sneumeister/Gas-o-Meter2/CAD-housing/README.md

[↓ Switch to English](README_EN.md)

# Gehäuse Dateien zum 3D Druck #

## CAD Dateien ##

CAD-dateien für PTC Creo Parametrics v11.x :  [Creo_parametrics/](./Creo_parametrics/)

## STEP Dateien ###

- Gehäuse: [gasmeter-case01.stp](./gasmeter-case01.stp)
- Akkudeckel: [battcover.stp](./battcover.stp)

## Bilder ##

Platz für das PCB und den Reed-Schalter:

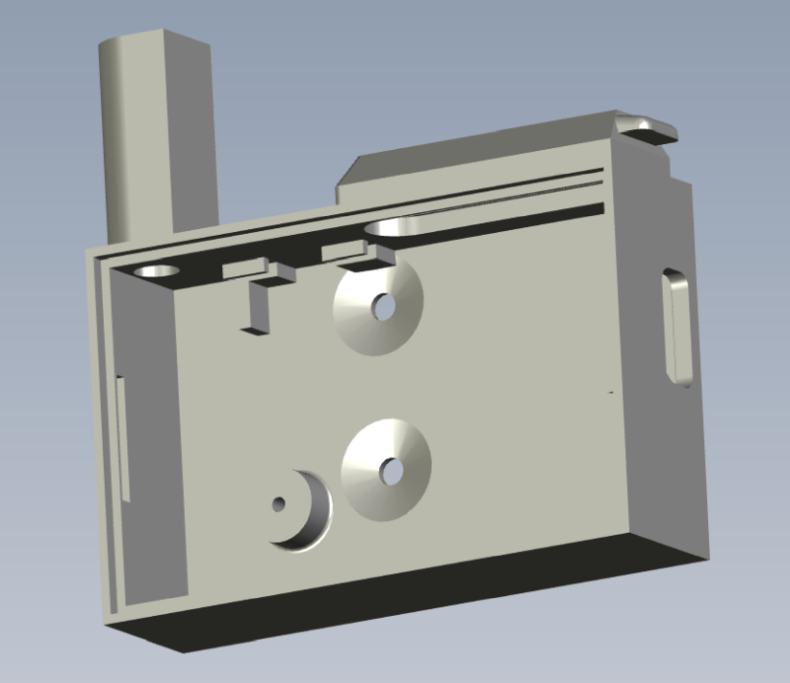
[picture p3: CAD-housing/pictures/gasmeter-case01.png]

(Am "Dom" muss noch ein M6 Gewinde geschnitten werden; die Platine mit Innensechskantschraube M2x10 befestigen)

Paltz für den Akku 523450 - 3,7V / 1000mAh (5,2 x 34 x 50mm):

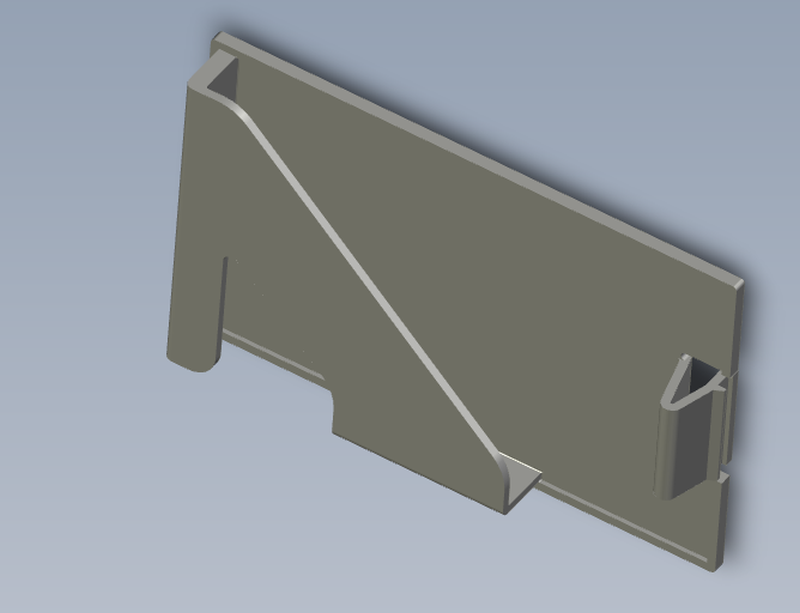
[picture p4: CAD-housing/pictures/battcover.png]


Gedruckt bei JLCPCB

| Item | Data |
| ---- | ---- |
| 3D Technology | SLA(Resin) |
| Material | JLC Black Resin |
| Colors | Black |
| Surface Finish | 01 Sanding / General Sanding |

Bilder
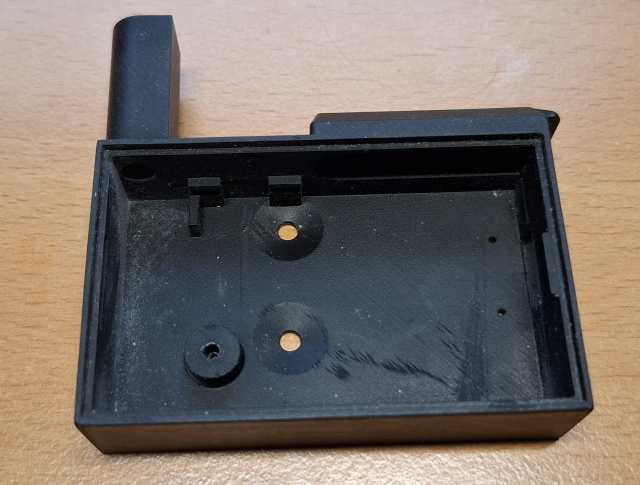
[picture p5: CAD-housing/pictures/house00.png]

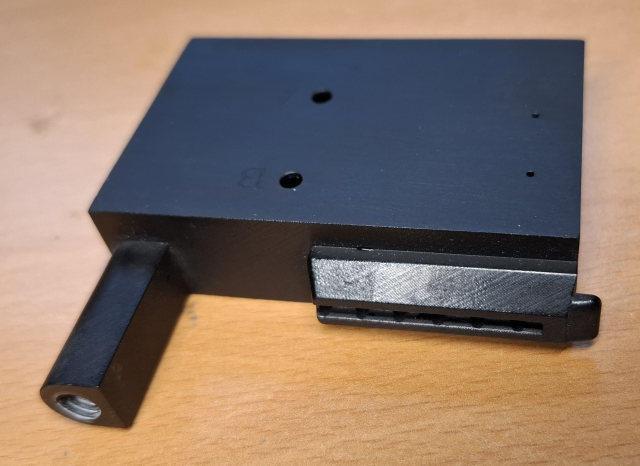
[picture p6: CAD-housing/pictures/house01.png]

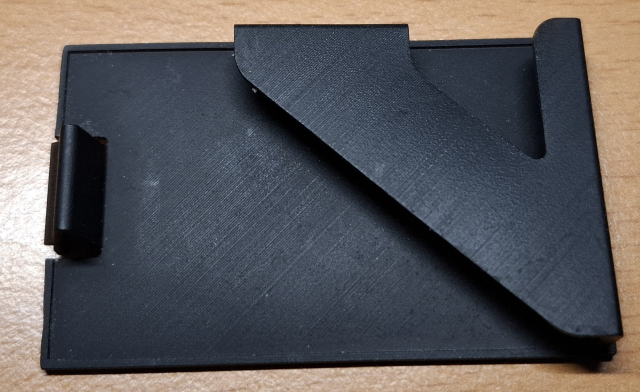
[picture p7: CAD-housing/pictures/house06.png]

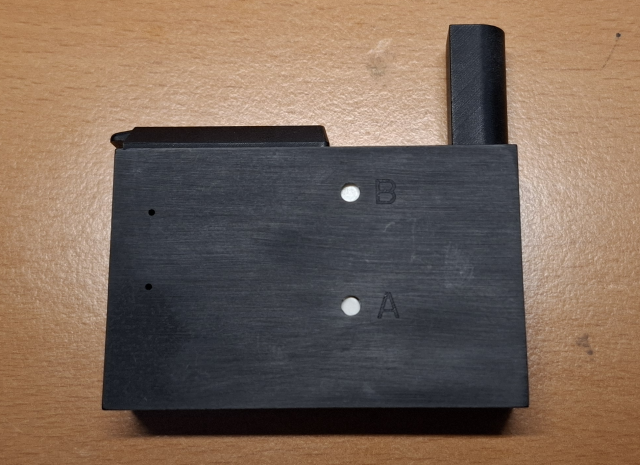
[picture p8: CAD-housing/pictures/house02.png]

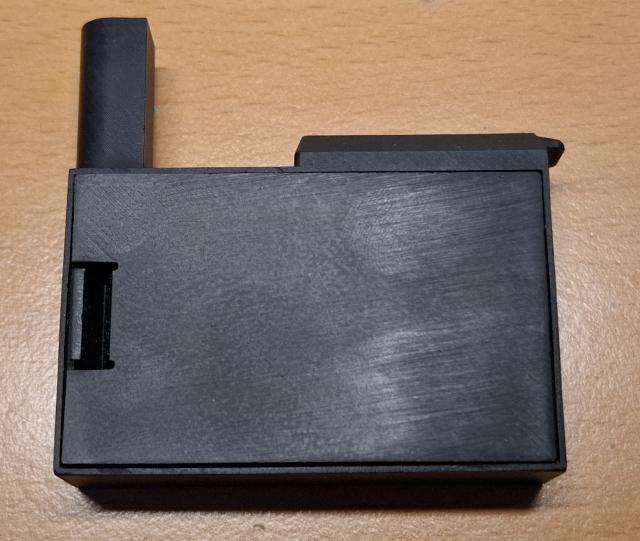
[picture p9: CAD-housing/pictures/house03.png]

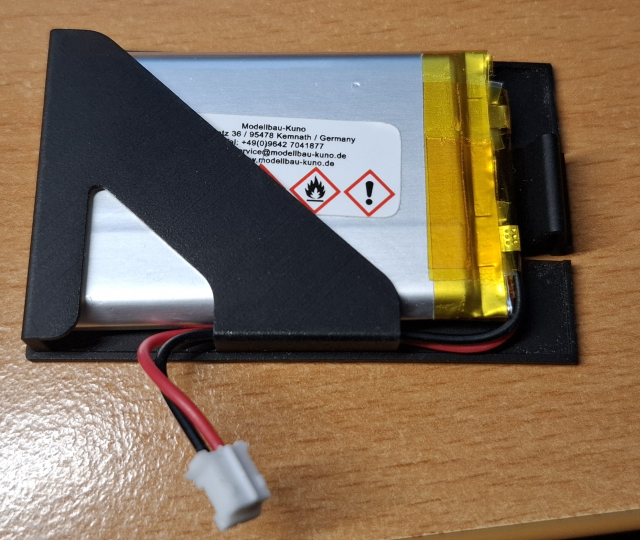
[picture p10: CAD-housing/pictures/house04.png]

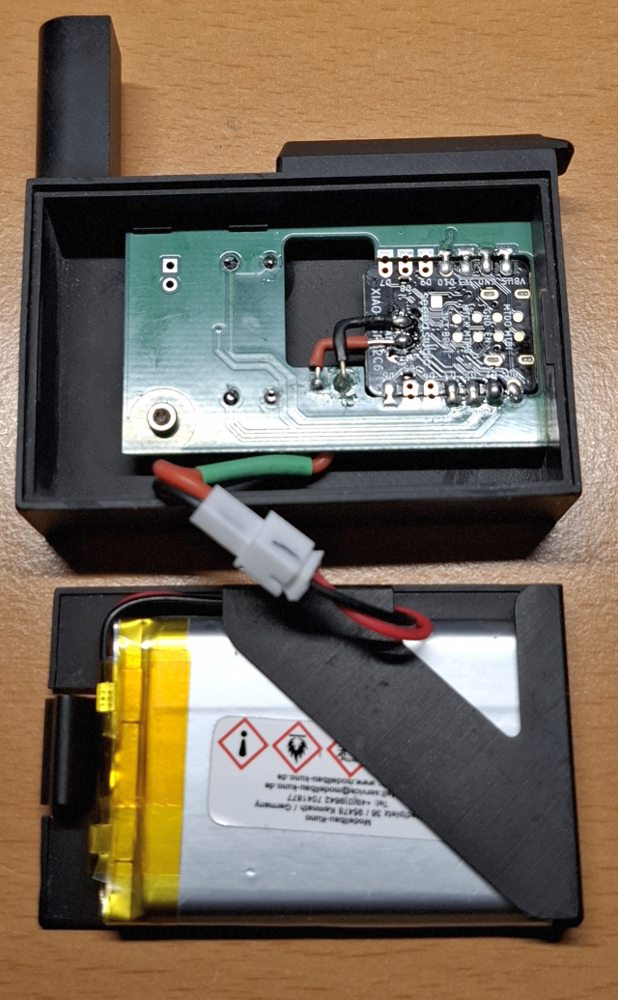
[picture p11: CAD-housing/pictures/house05.png]
