sneumeister/Gas-o-Meter2/KiCAD-PCB/Version20260523/README.md

[↓ Switch to English](README_EN.md)

# Gas-O-Meter2 — Platinenversion 20260523

KiCAD-Projekt und Stückliste (BOM) der zweiten Platinenrevision.

- Akku-Spannung am **GPIO0** (Pin1/A0/D0) mittels **1:1-Spannungsteiler** (R2/R3)
- **USB-Spannungsversorgung:** **VBUS** an **GPIO18** (Pin11/D10) über **asymmetrischen Spannungsteiler** (R3/R4)
- **Freiraum** um die Onboard-Antenne zur Verbesserung der Sende-/Empfangseigenschaften

## Schaltplan

[Schaltplan ESP32C6_gasometer (PDF)](Schaltplan_ESP32C6_gasometer.pdf)

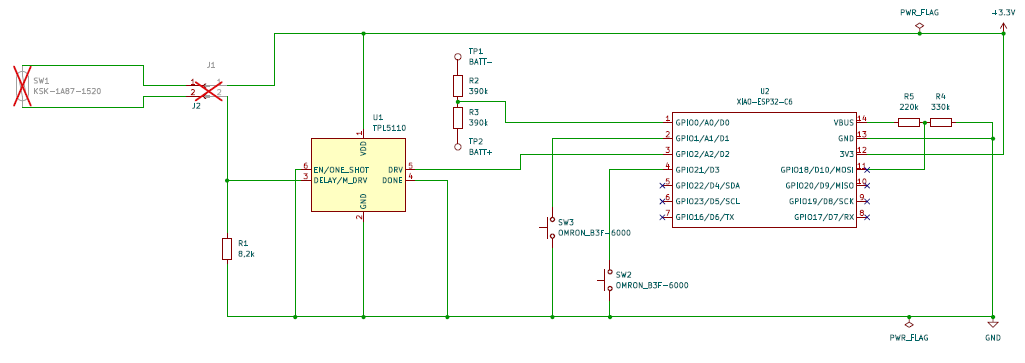
[picture p16: KiCAD-PCB/Version20260523/ESP32C6_gasometer_Schaltplan.png]
Schaltplan ESP32C6_gasometer


## Stückliste (BOM)

Quelle: `BOM_ESP32C6_gasometer.xlsx`

| Reference | Qty | Beschreibung | Value | Datasheet |
| --- | --- | --- | ----- | --- |
| J1 | 1 | Generic connector, single row, 01x02 // Reed | JST-XH 1.25 2pin socket | |
| J2 | 1 | Generic connector, single row, 01x02 // Batterie | JST-XH 1.25 2pin plug | |
| R1 | 1 | Resistor_SMD1206 | 8,2k | |
| R2,R3 | 2 | Resistor_SMD1206 | 390k | |
| R4 | 1 | Resistor_SMD1206 | 330k | |
| R5 | 1 | Resistor_SMD1206 | 220k | |
| SW1 | 1 | reed switch | KSK-1A87-1520 | [Datasheet](https://standexdetect.de/wp-content/uploads/sites/8/2025/09/datasheet-reed-switch-series-ksk-1a80.pdf) |
| SW2,SW3 | 2 | Push button switch, generic, two pins | OMRON_B3F-6000 | [Datasheet](https://omronfs.omron.com/en_US/ecb/products/pdf/en-b3f.pdf) |
| U1 | 1 | Timer, Nano Power, SOT-23-6 | TPL5110 | [Datasheet](http://www.ti.com/lit/ds/symlink/tpl5110.pdf) |
| U2 | 1 | | Seeed Studio XIAO ESP32-C6 | |
| J3 | | JST-Conn. / Battery Connector | JST-PH 2.00 2pin socket | |
| | 1 | Li-Polymer Battery 52x34x5,0mm | LiPo 1000mAh 523450 | |

## 3D-Ansicht

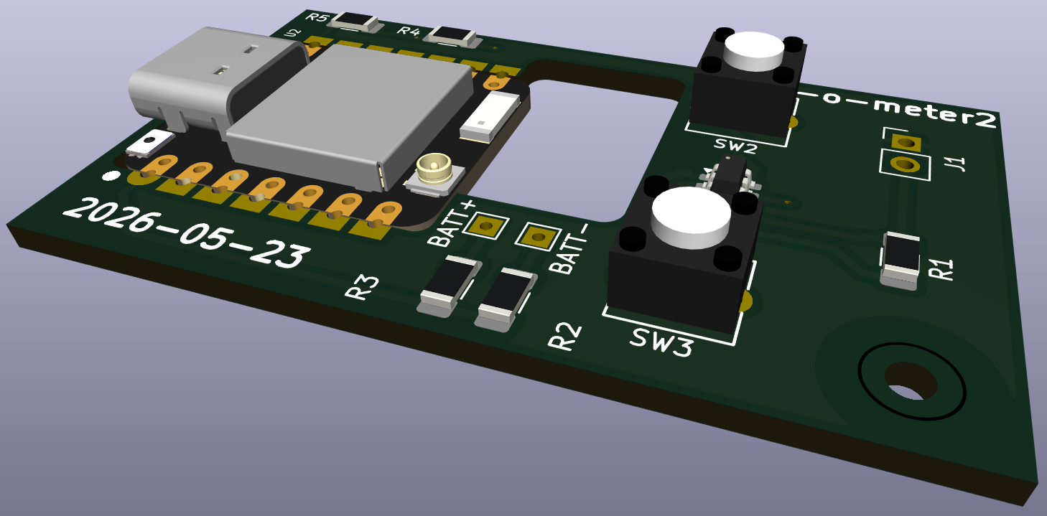
[picture p17: KiCAD-PCB/Version20260523/ESP32C6_PCB_3D.png]
ESP32C6 PCB 3D


## KiCAD-Export

Aktueller Stand: [ESP32C6_gasometer-2026-07-11_162129](ESP32C6_gasometer-2026-07-11_162129/)
