sneumeister/Gas-o-Meter2/THIRD_PARTY_NOTICES.md

# Third-party notices

Gas-O-Meter2 firmware and the web flasher use third-party software. The
versions below correspond to the pinned entries in `dependencies.lock`,
`platformio.ini` and the web-flasher dependency for the current source tree.

The Gas-O-Meter2 project itself is licensed under the Apache License 2.0; see
[`LICENSE`](./LICENSE) and [`NOTICE`](./NOTICE). The notices below do not
change the licenses of the respective third-party works.

## Apache License 2.0

The following works are provided under the Apache License 2.0:

- ESP-IDF 5.5.1, Espressif Systems:
  <https://github.com/espressif/esp-idf/tree/v5.5.1>
- espressif/mdns 1.9.1, Espressif Systems:
  <https://components.espressif.com/components/espressif/mdns/versions/1.9.1>
- espressif/esp-zigbee-lib 1.6.8, Espressif Systems:
  <https://components.espressif.com/components/espressif/esp-zigbee-lib/versions/1.6.8>
- ESP Web Tools 10.4.0, ESPHome contributors:
  <https://github.com/esphome/esp-web-tools/tree/10.4.0>

A copy of the Apache License 2.0 is provided in [`LICENSE`](./LICENSE).

ESP-IDF contains components and submodules with their own license and
attribution notices. Their corresponding source and component-specific notices
are available from the exact ESP-IDF source version linked above.

## MIT-licensed software

The following copyright notices apply:

### ArduinoJson 7.4.3

Copyright © 2014-2026, Benoit BLANCHON

Source: <https://github.com/bblanchon/ArduinoJson/tree/v7.4.3>

### joltwallet/littlefs 1.20.3

Copyright 2020 Brian Pugh

Source: <https://components.espressif.com/components/joltwallet/littlefs/versions/1.20.3>

### nordesems/esp-captive-portal 1.3.0

Copyright (c) 2026 Ahmed Al-Tameemi, Nordes Sp. z o. o.

Source:
<https://components.espressif.com/components/nordesems/esp-captive-portal/versions/1.3.0>

### Bootstrap 5.3.2

Copyright (c) 2011-2023 The Bootstrap Authors

Source: <https://github.com/twbs/bootstrap/tree/v5.3.2>

### MIT License text

Permission is hereby granted, free of charge, to any person obtaining a copy
of this software and associated documentation files (the "Software"), to deal
in the Software without restriction, including without limitation the rights
to use, copy, modify, merge, publish, distribute, sublicense, and/or sell
copies of the Software, and to permit persons to whom the Software is
furnished to do so, subject to the following conditions:

The above copyright notice and this permission notice shall be included in all
copies or substantial portions of the Software.

THE SOFTWARE IS PROVIDED "AS IS", WITHOUT WARRANTY OF ANY KIND, EXPRESS OR
IMPLIED, INCLUDING BUT NOT LIMITED TO THE WARRANTIES OF MERCHANTABILITY,
FITNESS FOR A PARTICULAR PURPOSE AND NONINFRINGEMENT. IN NO EVENT SHALL THE
AUTHORS OR COPYRIGHT HOLDERS BE LIABLE FOR ANY CLAIM, DAMAGES OR OTHER
LIABILITY, WHETHER IN AN ACTION OF CONTRACT, TORT OR OTHERWISE, ARISING FROM,
OUT OF OR IN CONNECTION WITH THE SOFTWARE OR THE USE OR OTHER DEALINGS IN THE
SOFTWARE.

## espressif/esp-zboss-lib 1.6.4

Source:
<https://components.espressif.com/components/espressif/esp-zboss-lib/versions/1.6.4>

Copyright (c) 2012-2021 DSR Corporation, Denver CO, USA  
Copyright (c) 2021 Espressif Systems (Shanghai) PTE LTD  
All rights reserved.

Redistribution and use in source and binary forms, with or without
modification, are permitted provided that the following conditions are met:

1. Redistributions of source code must retain the above copyright notice,
   this list of conditions and the following disclaimer.
2. Redistributions in binary form, except as embedded into an Espressif
   Systems integrated circuit in a product or a software update for such
   product, must reproduce the above copyright notice, this list of conditions
   and the following disclaimer in the documentation and/or other materials
   provided with the distribution.
3. Neither the name of the copyright holder nor the names of its contributors
   may be used to endorse or promote products derived from this software
   without specific prior written permission.
4. Any software provided in binary form under this license must not be reverse
   engineered, decompiled, modified and/or disassembled.

THIS SOFTWARE IS PROVIDED BY THE COPYRIGHT HOLDERS AND CONTRIBUTORS "AS IS"
AND ANY EXPRESS OR IMPLIED WARRANTIES, INCLUDING, BUT NOT LIMITED TO, THE
IMPLIED WARRANTIES OF MERCHANTABILITY AND FITNESS FOR A PARTICULAR PURPOSE
ARE DISCLAIMED. IN NO EVENT SHALL THE COPYRIGHT HOLDER OR CONTRIBUTORS BE
LIABLE FOR ANY DIRECT, INDIRECT, INCIDENTAL, SPECIAL, EXEMPLARY, OR
CONSEQUENTIAL DAMAGES (INCLUDING, BUT NOT LIMITED TO, PROCUREMENT OF
SUBSTITUTE GOODS OR SERVICES; LOSS OF USE, DATA, OR PROFITS; OR BUSINESS
INTERRUPTION) HOWEVER CAUSED AND ON ANY THEORY OF LIABILITY, WHETHER IN
CONTRACT, STRICT LIABILITY, OR TORT (INCLUDING NEGLIGENCE OR OTHERWISE)
ARISING IN ANY WAY OUT OF THE USE OF THIS SOFTWARE, EVEN IF ADVISED OF THE
POSSIBILITY OF SUCH DAMAGE.
