sneumeister/Gas-o-Meter2/pictures/webui/config-ble.png

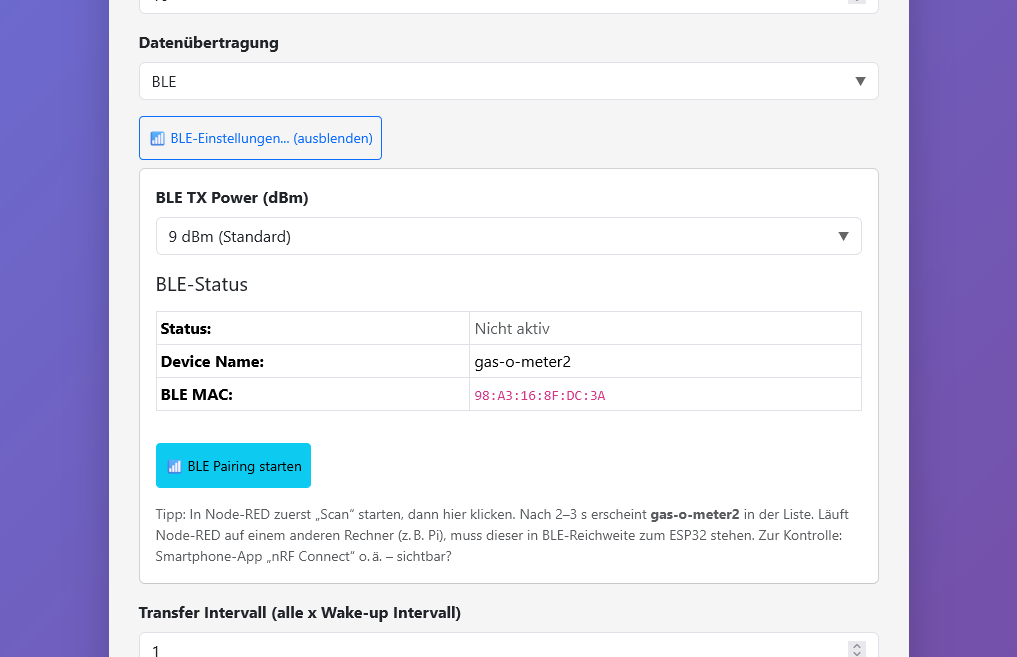
pictures/webui/config-ble.png
