sneumeister/Gas-o-Meter2/pictures/webui/config-change-popup.png

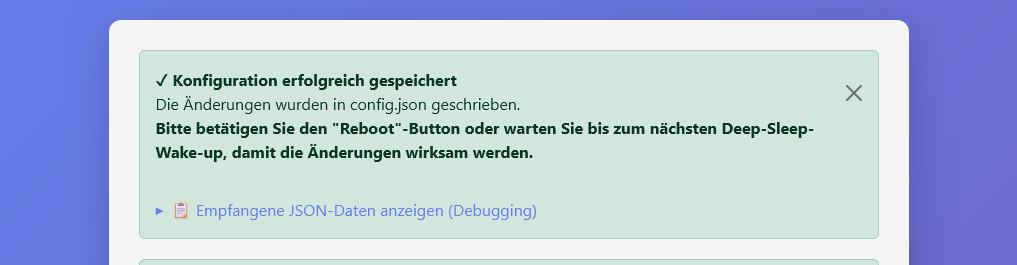
pictures/webui/config-change-popup.png
