sneumeister/Gas-o-Meter2/CAD-housing/gasmeter-case01.stp

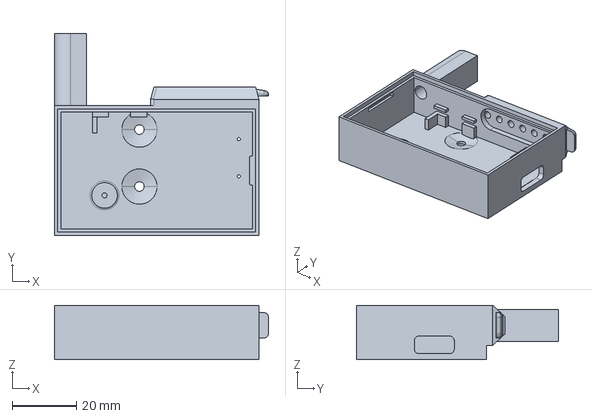
[picture p26: CAD file, 2025-12-28]
CAD-housing/gasmeter-case01.stp
66.8 x 63.0 x 17.0 mm
