sneumeister/Gas-o-Meter2/CAD-housing/battcover.stp

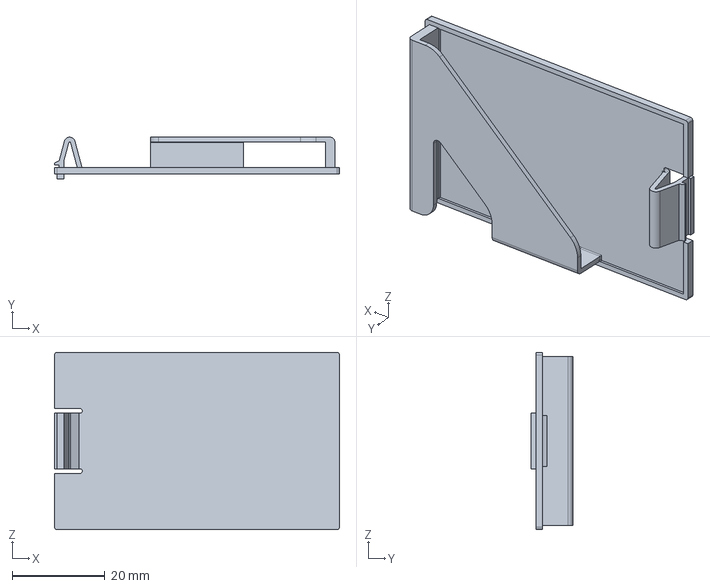
[picture p27: CAD file, 2025-12-28]
CAD-housing/battcover.stp
61.5 x 9.00 x 38.2 mm
