sneumeister/Gas-o-Meter2/CAD-housing/ESP32C6_gasometer.step

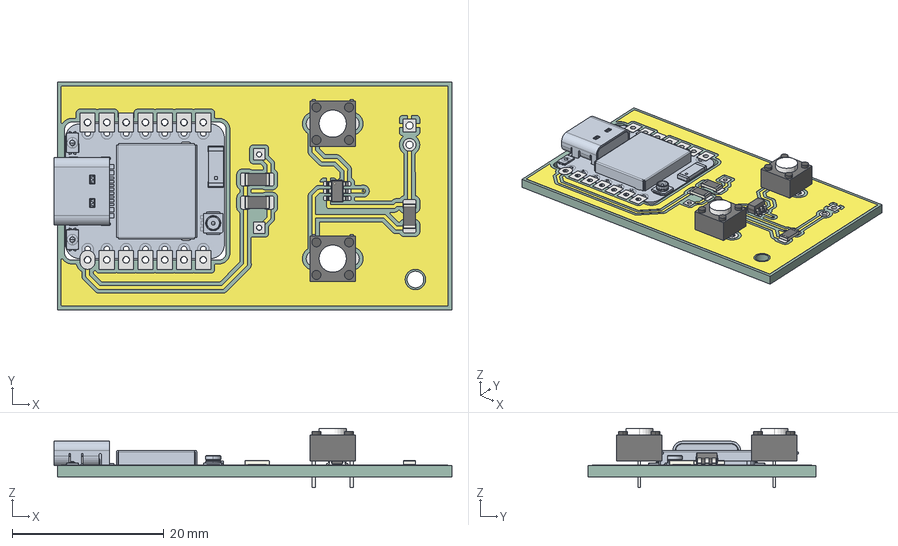
[picture p28: CAD file, 2025-12-26]
CAD-housing/ESP32C6_gasometer.step
52.4 x 30.0 x 7.80 mm
b3f-6000 x 2
R_1206_3216Metric x 3
ESP32C6_gasometer 1.5.1
SOT-23-6
ESP32C6_gasometer_copper
ESP32C6_gasometer_pad
ESP32C6_gasometer_via
ESP32C6_gasometer_PCB
