sneumeister/Gas-o-Meter2/(list of files, cad)

Other CAD files:
CAD-housing/Creo_parametrics/battcover.prt
CAD-housing/Creo_parametrics/gasmeter-case01.prt
CAD-housing/Creo_parametrics/lipo_1500mah.prt
