sneumeister/Gas-o-Meter2/KiCAD-PCB/Version20260523/ESP32C6_gasometer.pdf

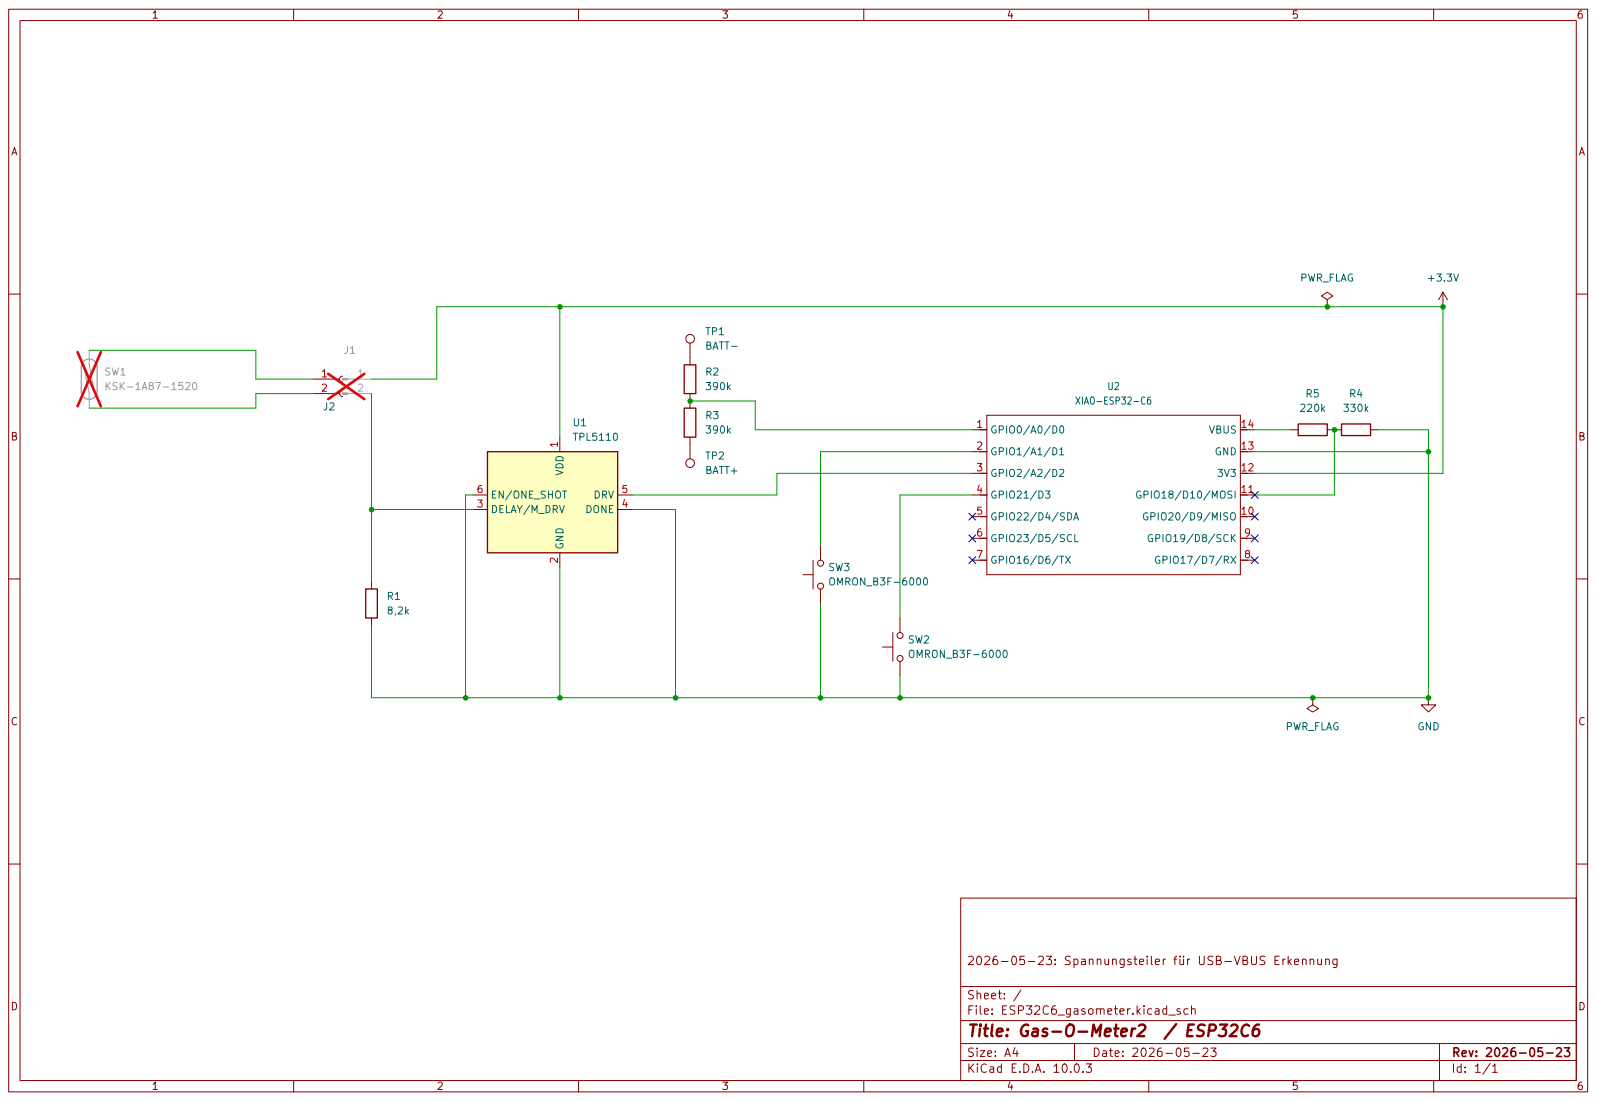
[picture p29: page 1]
