sneumeister/Gas-o-Meter2/KiCAD-PCB/Version20251022/ESP32C6_gasometer.pdf

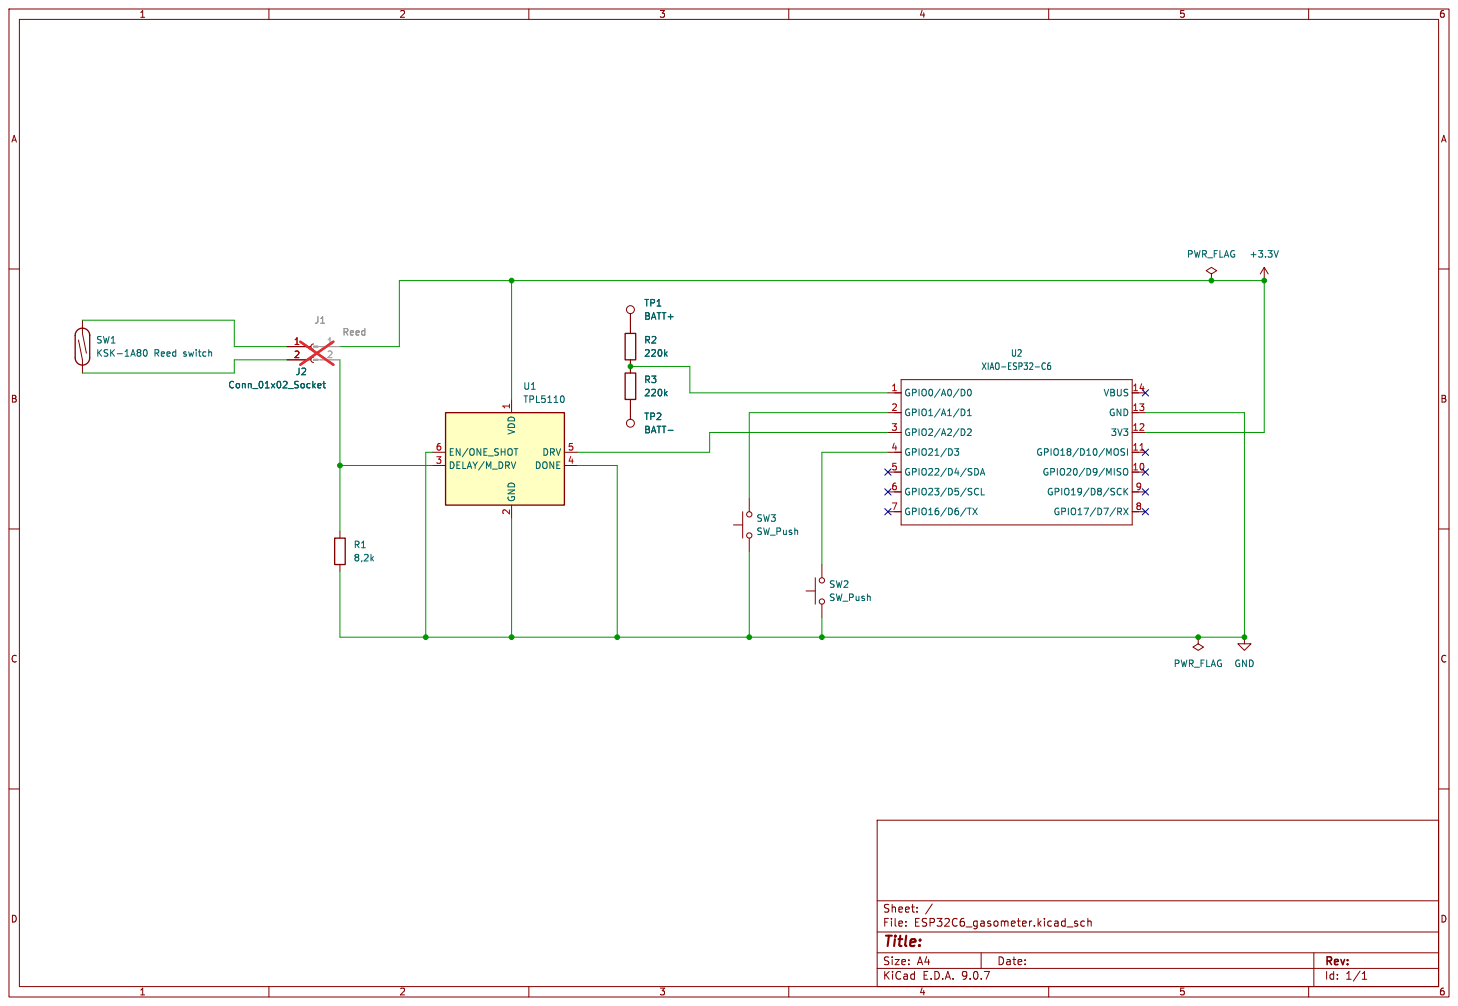
[picture p30: page 1]
