sneumeister/Gas-o-Meter2/KiCAD-PCB/Version20251022/ESP32C6_gasometer-2026-02-07_185848/ESP32C6_gasometer.kicad_pcb

## KiCad design KiCAD-PCB/Version20251022/ESP32C6_gasometer-2026-02-07_185848/ESP32C6_gasometer.kicad_pcb (2026-07-11)

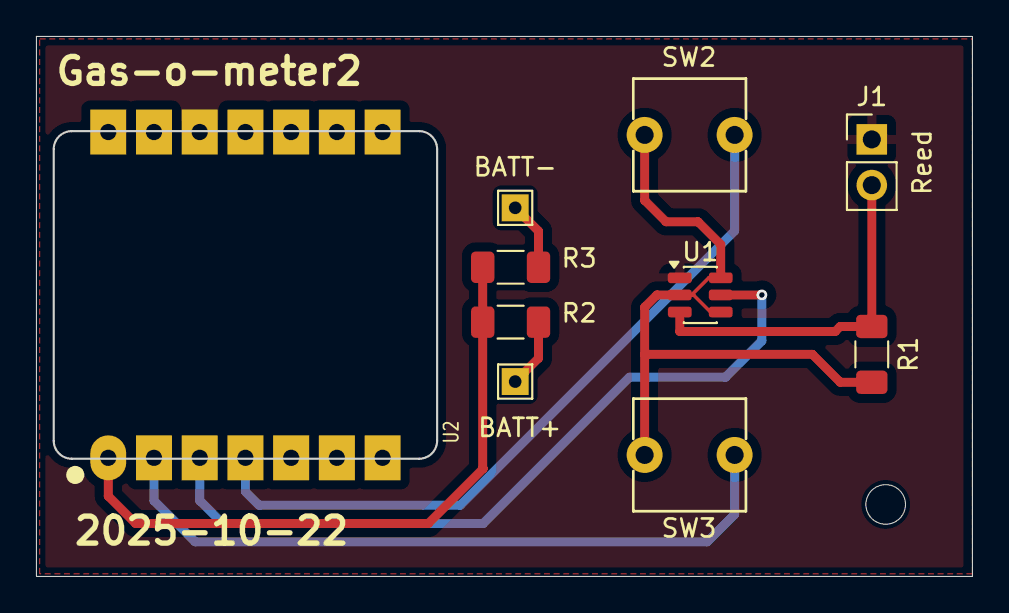
[picture p31: board ESP32C6_gasometer.kicad_pcb from above]

Board: 2 copper layers, 52.0 x 30.0 mm, 11 parts (0 on the bottom side), 9 nets.

Parts:
.: M.Hole_2.2mm_M2; MountingHole_2.2mm_M2
J1: Reed; PinHeader_1x02_P2.54mm_Vertical
R1: 8,2k; R_1206_3216Metric_Pad1.30x1.75mm_HandSolder
R2, R3: 200k; R_1206_3216Metric_Pad1.30x1.75mm_HandSolder
SW2, SW3: SW_Push; SW_TH_Tactile_Omron_B3F-6000
TP1: BATT+; TestPoint_THTPad_1.5x1.5mm_Drill0.7mm
TP2: BATT-; TestPoint_THTPad_1.5x1.5mm_Drill0.7mm
U1: TPL5110; SOT-23-6
U2: XIAO-ESP32-C6; XIAO-ESP32C6-Breakout

Connections:
+3.3V: J1.1, U1.1 (VDD), U2.12 (3V3)
GND: R1.2, SW2.1, SW3.1, U1.2 (GND), U1.4 (DONE), U1.6 (EN/ONE_SHOT), U2.13 (GND)
unnamed: J1.2, R1.1, U1.3 (DELAY/M_DRV)
unnamed: R2.1, TP1.1
unnamed: R3.2, TP2.1
unnamed: U1.5 (DRV), U2.3 (GPIO2/A2/D2)
unnamed: R2.2, R3.1, U2.1 (GPIO0/A0/D0)
unnamed: SW3.2, U2.2 (GPIO1/A1/D1)
unnamed: SW2.2, U2.4 (GPIO21/D3)
