sneumeister/Gas-o-Meter2/include/hardware.h

#define HARDWARE_H
#include "hardware_shared.h"
#include "driver/gpio.h"
#include "freertos/FreeRTOS.h"
#include "freertos/task.h"
#include "esp_log.h"
#include "hal/adc_types.h"
#define SET_WIFI_LOG_LEVEL() esp_log_level_set("wifi", ESP_LOG_WARN)
    #define HIGH    1
    #define LOW     0
    ((BOARD_VERSION_ID != 20251022) && (BOARD_VERSION_ID != 20260523))
  #undef BOARD_VERSION_ID
  #define BOARD_VERSION_ID 20251022
#define LED_BUILTIN_GPIO   15  // Interne LED
#define BUTTON_A_GPIO_MODE  ((int)(GPIO_MODE_INPUT) | (int)(GPIO_PULLUP_ONLY))
#define REED_GPIO_MODE      GPIO_MODE_INPUT  // Kein Pull-Up/Pull-Down (externer Pull-Up)
#define BUTTON_B_GPIO_MODE  ((int)(GPIO_MODE_INPUT) | (int)(GPIO_PULLUP_ONLY))
#define INPUT_PULLUP      ((int)(GPIO_MODE_INPUT) | (int)(GPIO_PULLUP_ONLY))
#define INPUT_PULLDOWN    ((int)(GPIO_MODE_INPUT) | (int)(GPIO_PULLDOWN_ONLY))
#define LED_OFF            HIGH  // LED AUS (bei HIGH!)
#define LED_ON             LOW   // LED AN (bei LOW!)
#define ANTENNA_RF_SWITCH_ENABLE LOW  // RF-Switch aktivieren
#define ANTENNA_INTERNAL        LOW   // Logik-Level für interne Antenne (GPIO14)
#define ANTENNA_EXTERNAL        HIGH  // Logik-Level für externe Antenne (GPIO14)
#define BATTERY_ADC_PIN    0   // Akku-Monitoring ADC Pin (GPIO0)
#define BATTERY_ADC_UNIT   ADC_UNIT_1  // ADC Unit 1 (GPIO0 gehört zu ADC1)
#define BATTERY_ADC_CHANNEL ADC_CHANNEL_0  // ADC1 Channel 0
#define ANTENNA_RF_SWITCH_GPIO  3   // GPIO3: RF-Switch aktivieren (LOW = aktiviert)
#define ANTENNA_SELECT_GPIO     14  // GPIO14: Antennenauswahl (LOW = intern, HIGH = extern)
#define ADC_SAMPLE_COUNT   5   // Anzahl Messungen für Median-Filter
#define VOLTAGE_DIVIDER_RATIO  2.0   // Spannungsteiler-Verhältnis (2:1 = 2.0)
#define ADC_VOLTAGE_MULTIPLIER  1.00f
#define ADC_MAX_ADC_VOLTAGE    4.24f  // Maximale Spannung am ADC-Eingang bei ADC_ATTEN_DB_12 (V) - gemessen
#define ADC_RESOLUTION         4095   // 12-bit ADC Auflösung (2^12 - 1)
#define BATTERY_VOLTAGE_FULL      4.02f   // ≥4.02V = 100% = "Voll"
#define BATTERY_VOLTAGE_80        3.92f   // 3.92V = 80% = "Gut"
#define BATTERY_VOLTAGE_50        3.72f   // 3.72V = 50% = "Mittel"
#define BATTERY_VOLTAGE_30        3.57f   // 3.57V = 30% (Schwelle für Ring-Speicher-Schreibung)
#define BATTERY_VOLTAGE_20        3.42f   // 3.42V = 20% = "Niedrig"
#define BATTERY_VOLTAGE_PROTECTION 3.15f   // ≤3.15V = 0% = "Schutz!" (Betrieb einstellen)
#define BATTERY_MIN_VOLTAGE   BATTERY_VOLTAGE_PROTECTION  // Minimale Akku-Spannung (V) = 0%
#define BATTERY_MAX_VOLTAGE   BATTERY_VOLTAGE_FULL        // Maximale Akku-Spannung (V) = 100%
#define USB_DETECTION_THRESHOLD   2.0f    // Schwellwert für USB-Erkennung (V) - darunter: USB angeschlossen
#define VBUS_DETECT_GPIO  18
#define DEFAULT_NTP_SERVER    "pool.ntp.org"  // Default NTP-Server (gut für Europa)
#define NTP_TIMEOUT_MS        5000            // Timeout für NTP-Synchronisation (ms)
#define WIFI_TX_POWER_DEFAULT       80      // Default WiFi TX Power: 20 dBm (80 * 0.25 dBm = 20 dBm)
#define HOSTNAME_MAX_LEN  26
#define WIFI_WAIT_FOR_SLEEP   5               // Minuten ohne Web-Server-Zugriff → Deep-Sleep
#define AP_IP_ADDRESS_1       10               // AP IP-Adresse: 10.0.0.1
#define AP_IP_ADDRESS_2       0
#define AP_IP_ADDRESS_3       0
#define AP_IP_ADDRESS_4       1
#define LP_CORE_WATCHDOG_MS   6000
#define DEFAULT_WAKEUP_INTERVAL_MIN  10  // Minuten
#define DEFAULT_WAKEUP_INTERVAL_US   (DEFAULT_WAKEUP_INTERVAL_MIN * 60 * 1000000ULL)
#define WAKEUP_BUFFER_SEC  30  // Sekunden
#define DEFAULT_TRANSFER_INTERVAL_X  2  // Multiplikator für Transfer-Intervall
#define DEFAULT_TRANSFER_INTERVAL_US   (DEFAULT_TRANSFER_INTERVAL_X * DEFAULT_WAKEUP_INTERVAL_MIN * 60 * 1000000ULL)
#define PULSE_COUNTER_DIVISOR  100  // Divisor für 2 Nachkommastellen (m³)
#define RING_BUFFER_SIZE  12000  // Anzahl Einträge im Ringspeicher (10 Jahre @ 1200 Pulse/Jahr)
#define ULP_RTC_MEM_BASE   0x50000000  // RTC Fast Memory Start-Adresse
#define ULP_DATA_OFFSET    0x100       // Offset für Daten im RTC Memory
#define ULP_DATA_MAGIC     0x475A4D4F  // "GZMO" (Gas-Zähler-Meter-Original)
#define NVS_PARTITION_PULSE  "pulse_nv"   // Partition-Name aus partitions.csv
#define NVS_NAMESPACE_PULSE  "pulse_ring"
#define NVS_KEY_VERSION      "version"  // Versionsnummer für Initialisierungs-Check
#define NVS_KEY_PREFIX       "p_"
#define MAX_KEY_LENGTH       8   // Max: "p_11999" = 7 Zeichen + 1 Null-Terminator = 8
#include "version.h"
#define ADC_TO_VOLTAGE(adc_value) \
    ((float)(adc_value) / ADC_RESOLUTION * ADC_MAX_ADC_VOLTAGE * VOLTAGE_DIVIDER_RATIO)
inline uint8_t VOLTAGE_TO_PERCENT(float voltage) {
    if (voltage >= BATTERY_VOLTAGE_FULL) {
        return 100;  // "Voll"
    } else if (voltage >= BATTERY_VOLTAGE_80) {
        return 80 + (uint8_t)(((voltage - BATTERY_VOLTAGE_80) / (BATTERY_VOLTAGE_FULL - BATTERY_VOLTAGE_80)) * 20.0f);
    } else if (voltage >= BATTERY_VOLTAGE_50) {
        return 50 + (uint8_t)(((voltage - BATTERY_VOLTAGE_50) / (BATTERY_VOLTAGE_80 - BATTERY_VOLTAGE_50)) * 30.0f);
    } else if (voltage >= BATTERY_VOLTAGE_20) {
        return 20 + (uint8_t)(((voltage - BATTERY_VOLTAGE_20) / (BATTERY_VOLTAGE_50 - BATTERY_VOLTAGE_20)) * 30.0f);
    } else if (voltage >= BATTERY_VOLTAGE_PROTECTION) {
        return 0 + (uint8_t)(((voltage - BATTERY_VOLTAGE_PROTECTION) / (BATTERY_VOLTAGE_20 - BATTERY_VOLTAGE_PROTECTION)) * 20.0f);
    } else {
        return 0;     // "Schutz!" - unter 3.15V
    }
}
#define ADC_TO_PERCENT(adc_value) \
    VOLTAGE_TO_PERCENT(ADC_TO_VOLTAGE(adc_value))
#define INIT_ANTENNA_SWITCH(antenna_type) \
    do { \
        gpio_config_t io_conf = {}; \
        io_conf.pin_bit_mask = (1ULL << ANTENNA_RF_SWITCH_GPIO) | (1ULL << ANTENNA_SELECT_GPIO); \
        io_conf.mode = GPIO_MODE_OUTPUT; \
        io_conf.pull_up_en = GPIO_PULLUP_DISABLE; \
        io_conf.pull_down_en = GPIO_PULLDOWN_DISABLE; \
        io_conf.intr_type = GPIO_INTR_DISABLE; \
        gpio_config(&io_conf); \
        gpio_set_level((gpio_num_t)ANTENNA_RF_SWITCH_GPIO, ANTENNA_RF_SWITCH_ENABLE); \
        vTaskDelay(pdMS_TO_TICKS(100));  \
        gpio_set_level((gpio_num_t)ANTENNA_SELECT_GPIO, antenna_type); \
    } while(0)
#define SET_ANTENNA_INTERNAL() \
    gpio_set_level((gpio_num_t)ANTENNA_SELECT_GPIO, ANTENNA_INTERNAL)
#define SET_ANTENNA_EXTERNAL() \
    gpio_set_level((gpio_num_t)ANTENNA_SELECT_GPIO, ANTENNA_EXTERNAL)
#define INIT_VBUS_DETECT_GPIO() \
    do { \
        gpio_config_t _vbus = {}; \
        _vbus.pin_bit_mask = (1ULL << VBUS_DETECT_GPIO); \
        _vbus.mode = GPIO_MODE_INPUT; \
        _vbus.pull_up_en = GPIO_PULLUP_DISABLE; \
        _vbus.pull_down_en = GPIO_PULLDOWN_DISABLE; \
        _vbus.intr_type = GPIO_INTR_DISABLE; \
        gpio_config(&_vbus); \
    } while (0)
#if BOARD_VERSION_ID == 20260523
#define IS_USB_POWER(battery_voltage_v) \
    (gpio_get_level((gpio_num_t)VBUS_DETECT_GPIO) == 1)
#else
#define IS_USB_POWER(battery_voltage_v) \
    ((battery_voltage_v) < USB_DETECTION_THRESHOLD)
#endif
#if BOARD_VERSION_ID == 20260523
#define LOG_USB_POWER_DETECTED(tag, battery_voltage_v) \
    ESP_LOGI(tag, "USB-Stromversorgung erkannt (VBUS GPIO%d=%d)", \
             VBUS_DETECT_GPIO, (int)gpio_get_level((gpio_num_t)VBUS_DETECT_GPIO))
#else
#define LOG_USB_POWER_DETECTED(tag, battery_voltage_v) \
    ESP_LOGI(tag, "USB-Stromversorgung erkannt (Spannung %.2f V < %.2f V)", \
             (float)(battery_voltage_v), USB_DETECTION_THRESHOLD)
#endif
#define LOG_POWER_SUPPLY_MODE(tag, battery_voltage_v, is_usb_power_v) \
    do { \
        if (is_usb_power_v) { \
            LOG_USB_POWER_DETECTED(tag, battery_voltage_v); \
        } else { \
            ESP_LOGI(tag, "Akku-Betrieb (Spannung: %.2f V)", (float)(battery_voltage_v)); \
        } \
    } while (0)
