sneumeister/Gas-o-Meter2/src/main_idf.cpp

// ESP-IDF Headers
#include "esp_log.h"
#include "esp_system.h"
#include "esp_mac.h"
#include "esp_event.h"
#include "esp_netif.h"
#include "esp_wifi.h"
#include "esp_http_server.h"
#include "mdns.h"
#include "esp_littlefs.h"
#include "lwip/apps/sntp.h"
#include "lwip/inet.h"
#include "lwip/sockets.h"
#include "captive_portal.h"
#include <string.h>
#include "esp_vfs.h"
#include "esp_timer.h"
#include "esp_adc/adc_oneshot.h"
#include "esp_adc/adc_cali.h"
#include "esp_adc/adc_cali_scheme.h"
#include "esp_sleep.h"
#include "driver/gpio.h"
#include "driver/rtc_io.h"
#include "driver/uart.h"
#include "ulp_lp_core.h"  // LP-Core Management APIs
#include <time.h>
#include "nvs.h"
#include "nvs_flash.h"
#include "esp_partition.h"
#include "hardware.h"
#include "version.h"
#include "freertos/FreeRTOS.h"
#include "freertos/task.h"
#include "transfer.h"
#include "transfer_zigbee.h"
#include "zigbee_config.h"
#include "transfer_ble.h"
#include "ble_config.h"
#include "mqtt_config.h"
#include "transfer_mqtt.h"
#include "wifi_scan_config.h"
#include "wifi_manager.h"
#include "time_sync.h"
#include <stdlib.h>

#include <ArduinoJson.h>

// Template-Placeholder (aus CMakeLists.txt)
#ifndef TEMPLATE_PLACEHOLDER
#define TEMPLATE_PLACEHOLDER '`'   // Backtick (`) für Template-Platzhalter
#endif

// Logging-Tag
static const char *TAG = "gas-o-meter";

/** UART-TX leeren vor Deep-Sleep/Reboot (ersetzt feste 200-ms-Pause). */
static void console_flush_before_poweroff(void) {
    fflush(stdout);
#if CONFIG_ESP_CONSOLE_UART
    const esp_err_t err = uart_wait_tx_done((uart_port_t)CONFIG_ESP_CONSOLE_UART_NUM,
                                            pdMS_TO_TICKS(500));
    if (err != ESP_OK && err != ESP_ERR_TIMEOUT) {
        ESP_LOGW(TAG, "console_flush_before_poweroff: uart_wait_tx_done: %s", esp_err_to_name(err));
    }
#endif
}

// LP-Core Binary Header (generiert durch ulp_embed_binary in src/CMakeLists.txt)
// ulp_embed_binary() erstellt automatisch ulp_main.h mit:
//   - Binary-Symbolen: ulp_main_bin_start, ulp_main_bin_end (für ulp_lp_core_load_binary())
//   - Exportierten globalen Variablen aus LP-Core Code mit "ulp_" Präfix:
//       extern uint32_t ulp_pulse_counter;      // Siehe Kommentar bei Zeile 135
//       extern uint32_t ulp_lp_core_running;     // Siehe Kommentar bei Zeile 135
// ulp_app_name="ulp_main" → Header-File: ulp_main.h
// WICHTIG: Keine expliziten extern-Deklarationen nötig - alles erfolgt implizit über dieses Include!
// WICHTIG: Alle Zugriffe auf ULP-Variablen müssen mit volatile-Casts erfolgen (siehe Kommentar bei Zeile 135)
#include "ulp_main.h"
// Manuelle Deklaration für das LP-Core Programm-Image
extern "C" {
    extern const uint8_t ulp_main_bin_start[] asm("_binary_ulp_main_bin_start");
    extern const uint8_t ulp_main_bin_end[]   asm("_binary_ulp_main_bin_end");
}

// LP-Core Initialisierung und Start
// Läuft auf dem HP-Core und startet den LP-Core-Prozessor
bool start_lp_core(void) {
    static constexpr uint32_t START_TIMEOUT_MS = 100;
    static constexpr uint32_t START_POLL_MS = 10;

    ESP_LOGI(TAG, "Starte LP-Core...");

    // Binary-Load initialisiert LP-BSS neu (pulse_counter := 0). Stand vorher sichern.
    const uint32_t saved_pulse = *(volatile uint32_t *)&ulp_pulse_counter;

    // REED-Pin vor dem Binary-Load als RTC-GPIO initialisieren.
    // Kein interner Pull-Up/Pull-Down; der externe Pull-Up bleibt maßgeblich.
    const gpio_num_t reed_gpio = (gpio_num_t)REED_GPIO;
    esp_err_t ret = rtc_gpio_init(reed_gpio);
    if (ret == ESP_OK) {
        ret = rtc_gpio_set_direction(reed_gpio, RTC_GPIO_MODE_INPUT_ONLY);
    }
    if (ret == ESP_OK) {
        ret = rtc_gpio_pullup_dis(reed_gpio);
    }
    if (ret == ESP_OK) {
        ret = rtc_gpio_pulldown_dis(reed_gpio);
    }
    if (ret != ESP_OK) {
        ESP_LOGE(TAG, "FEHLER: REED-Pin konnte nicht als RTC-GPIO initialisiert werden: %s",
                 esp_err_to_name(ret));
        return false;
    }
    
    ESP_LOGI(TAG, "REED-Pin (GPIO%d) als RTC-GPIO initialisiert", REED_GPIO);
    
    // LP-Core Binary laden
    // Binary-Symbole werden durch ulp_main.h (generiert von ulp_embed_binary) deklariert
    // Format: _binary_ulp_<ulp_app_name>_bin_start/end mit ulp_app_name="ulp_main"
    size_t binary_size = ulp_main_bin_end - ulp_main_bin_start;
    ret = ulp_lp_core_load_binary(ulp_main_bin_start, binary_size);
    if (ret != ESP_OK) {
        ESP_LOGE(TAG, "FEHLER: LP-Core Binary konnte nicht geladen werden: %s", esp_err_to_name(ret));
        return false;
    }
    
    ESP_LOGI(TAG, "LP-Core Binary geladen (%zu Bytes)", binary_size);

    // LP-RAM nach Load: Zähler, Heartbeat-Basis und aktueller Reed-Pegel
    // (echter Pegel vermeidet Phantom-Impuls und Doppelzählung bei Neustart während LOW).
    *(volatile uint32_t *)&ulp_pulse_counter = saved_pulse;
    *(volatile uint32_t *)&ulp_lp_core_running = 0;
    *(volatile uint32_t *)&ulp_reed_level = (uint32_t)rtc_gpio_get_level(reed_gpio);
    ESP_LOGI(TAG, "LP-Core: ulp_pulse_counter nach Load wiederhergestellt: %lu, reed_level=%lu",
             (unsigned long)saved_pulse,
             (unsigned long)*(volatile uint32_t *)&ulp_reed_level);

    // Ein Start: sofortiger Durchlauf (HP_CPU) plus periodischer LP-Timer.
    ulp_lp_core_cfg_t cfg = {
        .wakeup_source = ULP_LP_CORE_WAKEUP_SOURCE_HP_CPU |
                         ULP_LP_CORE_WAKEUP_SOURCE_LP_TIMER,
        .lp_timer_sleep_duration_us = LP_CORE_SAMPLE_IDLE_US,
    };

    ret = ulp_lp_core_run(&cfg);
    if (ret != ESP_OK) {
        ESP_LOGE(TAG, "FEHLER: LP-Core konnte nicht gestartet werden: %s", esp_err_to_name(ret));
        return false;
    }

    // ulp_lp_core_run() bestätigt nur den API-Aufruf. Erst der initiale
    // Heartbeat aus LP-main() bestätigt, dass das LP-Programm wirklich läuft.
    bool heartbeat_confirmed = false;
    for (uint32_t elapsed_ms = 0; elapsed_ms < START_TIMEOUT_MS; elapsed_ms += START_POLL_MS) {
        if (*(volatile uint32_t *)&ulp_lp_core_running != 0) {
            heartbeat_confirmed = true;
            break;
        }
        vTaskDelay(pdMS_TO_TICKS(START_POLL_MS));
    }

    if (!heartbeat_confirmed &&
        *(volatile uint32_t *)&ulp_lp_core_running != 0) {
        heartbeat_confirmed = true;
    }

    if (!heartbeat_confirmed) {
        ESP_LOGE(TAG, "LP-Core Start-Timeout: kein Heartbeat innerhalb %lu ms",
                 (unsigned long)START_TIMEOUT_MS);
        return false;
    }

    ESP_LOGI(TAG, "LP-Core Haltbetrieb aktiv (Pegel-Abtastung, Idle %lu ms / Pulse %lu ms)",
             (unsigned long)(LP_CORE_SAMPLE_IDLE_US / 1000),
             (unsigned long)(LP_CORE_SAMPLE_PULSE_US / 1000));
    return true;
}


// ============================================
// RTC Memory Struktur für Config-Werte
// ============================================
typedef struct {
    char hostname[HOSTNAME_MAX_LEN + 1];
    char adminpass[32];
    struct {
        char ssid[32];
        char password[64];
    } wifi_credentials[2];  // Max 2 SSID/Passwort-Paare
    uint8_t wifi_count;  // Anzahl der gespeicherten Credentials (0, 1 oder 2)
    uint8_t wakeup_minutes;
    uint8_t transfer_minutes;
    char transfer_mode[16];  // "zigbee", "ble", "mqtt", "none" (Default: "none")
    int8_t wifi_tx_power_dbm;     // WiFi TX Power in dBm (2..20 in UI-Stufen)
    int8_t ble_tx_power_dbm;      // BLE TX Power in dBm (3/6/9/12/15/18/20)
    int8_t zigbee_tx_power_dbm;   // ZigBee TX Power in dBm (-9/-6/-3/0/+3/+6/+10)
    float adc_voltage_multiplier;  // ADC-Skalierung (aus config.json oder hardware.h)
    char ntp_server[64];       // NTP-Server (aus config.json oder hardware.h)
    char mqtt_host[MQTT_HOST_MAX_LEN + 1];
    uint16_t mqtt_port;
    char mqtt_username[MQTT_USERNAME_MAX_LEN + 1];
    char mqtt_password[MQTT_PASSWORD_MAX_LEN + 1];
    char mqtt_main_topic[MQTT_MAIN_TOPIC_MAX_LEN + 1];
    bool mqtt_ha_autodiscovery;
    bool config_loaded;
} config_rtc_t;

RTC_DATA_ATTR config_rtc_t config_rtc = {
    .hostname = "gasometer2",
    .adminpass = "",
    .wifi_credentials = {{"", ""}, {"", ""}},
    .wifi_count = 0,
    .wakeup_minutes = DEFAULT_WAKEUP_INTERVAL_MIN,
    .transfer_minutes = DEFAULT_TRANSFER_INTERVAL_X * DEFAULT_WAKEUP_INTERVAL_MIN,
    .transfer_mode = "none",  // Default: keine Übertragung
    .wifi_tx_power_dbm = (int8_t)(WIFI_TX_POWER_DEFAULT / 4), // Default: 20 dBm
    .ble_tx_power_dbm = (int8_t)BLE_TX_POWER_DBM,               // Default: 9 dBm
    .zigbee_tx_power_dbm = (int8_t)ZIGBEE_TX_POWER_DEFAULT,     // Default: 0 dBm
    .adc_voltage_multiplier = ADC_VOLTAGE_MULTIPLIER,  // Default aus hardware.h
    .ntp_server = DEFAULT_NTP_SERVER,          // Default aus hardware.h
    .mqtt_host = MQTT_DUMMY_HOST,
    .mqtt_port = MQTT_DEFAULT_PORT,
    .mqtt_username = "",
    .mqtt_password = "",
    .mqtt_main_topic = MQTT_DEFAULT_MAIN_TOPIC,
    .mqtt_ha_autodiscovery = false,
    .config_loaded = false
};
RTC_DATA_ATTR int wakeupCount = 0;  // Zählt nur Deep-Sleep-Wake-ups (nicht ESP.restart())
RTC_DATA_ATTR uint32_t timer_wake_count = 0;  // Nur Timer-Wake-ups (für Übertragungs-Intervall)
RTC_DATA_ATTR bool isPowerOn = false;
RTC_DATA_ATTR uint32_t last_lp_core_running = 0;  // Letzter vom Watchdog geprüfter LP-Heartbeat

// Hostname-Zugriff für transfer_ble.cpp (BLE Device Name = Hostname)
const char* transfer_ble_get_hostname(void) {
    return config_rtc.hostname;
}

// TX Power-Zugriff für transfer_ble.cpp
int8_t transfer_ble_get_tx_power_dbm(void) {
    return config_rtc.ble_tx_power_dbm;
}

// TX Power-Zugriff für transfer_zigbee.cpp
int8_t transfer_zigbee_get_tx_power_dbm(void) {
    return config_rtc.zigbee_tx_power_dbm;
}

const char* transfer_mqtt_get_host(void) {
    return config_rtc.mqtt_host;
}

uint16_t transfer_mqtt_get_port(void) {
    return config_rtc.mqtt_port;
}

const char* transfer_mqtt_get_username(void) {
    return config_rtc.mqtt_username;
}

const char* transfer_mqtt_get_password(void) {
    return config_rtc.mqtt_password;
}

const char* transfer_mqtt_get_main_topic(void) {
    return config_rtc.mqtt_main_topic;
}

bool transfer_mqtt_get_ha_autodiscovery(void) {
    return config_rtc.mqtt_ha_autodiscovery;
}

const char* transfer_mqtt_get_hostname(void) {
    return config_rtc.hostname;
}

extern "C" bool wifi_manager_load_sta_config(wifi_manager_sta_config_t* out) {
    if (out == nullptr) {
        return false;
    }
    out->wifi_count = config_rtc.wifi_count;
    out->wifi_tx_power_dbm = config_rtc.wifi_tx_power_dbm;
    strncpy(out->hostname, config_rtc.hostname, sizeof(out->hostname) - 1);
    out->hostname[sizeof(out->hostname) - 1] = '\0';
    for (uint8_t i = 0; i < 2; i++) {
        strncpy(out->ssid[i], config_rtc.wifi_credentials[i].ssid, sizeof(out->ssid[i]) - 1);
        out->ssid[i][sizeof(out->ssid[i]) - 1] = '\0';
        strncpy(out->password[i], config_rtc.wifi_credentials[i].password, sizeof(out->password[i]) - 1);
        out->password[i][sizeof(out->password[i]) - 1] = '\0';
    }
    return true;
}
RTC_DATA_ATTR uint32_t ring_idx = RING_BUFFER_SIZE;  // Ring-Buffer-Index (im RTC-RAM, wird bei Power-On/ESP.restart() neu ermittelt)

// ============================================
// LP-Core Variablen (pulse_counter, lp_core_running)
// ============================================
// EHEMALIGE DEFINITIONEN (entfernt, jetzt im LP-Core Code):
//   RTC_DATA_ATTR uint32_t pulse_counter = 0;      // Puls-Zähler für LP-Core
//   RTC_DATA_ATTR uint32_t lp_core_running = 0;     // LP-Core Watchdog-Zähler
//
// AKTUELLE IMPLEMENTIERUNG:
//   - Variablen sind jetzt in ulp/ulp_main.c definiert:
//       volatile uint32_t pulse_counter = 0;      // volatile wegen gleichzeitigem Zugriff
//       volatile uint32_t lp_core_running = 0;     // volatile wegen gleichzeitigem Zugriff
//   - ulp_embed_binary() exportiert sie automatisch mit "ulp_" Präfix über ulp_main.h:
//       extern uint32_t ulp_pulse_counter;      // WICHTIG: volatile fehlt hier!
//       extern uint32_t ulp_lp_core_running;    // WICHTIG: volatile fehlt hier!
//   - Die Deklarationen erfolgen implizit durch #include "ulp_main.h" (siehe Zeile 47)
//   - WICHTIG: Alle Zugriffe auf diese Variablen müssen mit volatile-Casts erfolgen:
//       uint32_t val = *(volatile uint32_t *)&ulp_pulse_counter;  // Lesen
//       *(volatile uint32_t *)&ulp_pulse_counter = new_val;        // Schreiben
//     Dies zwingt den Compiler, immer vom RAM zu lesen/schreiben und verhindert Race Conditions
//   - Im Code werden die Variablen mit "ulp_" Präfix verwendet (z.B. ulp_pulse_counter)
//   - Die Variablen liegen im LP-RAM und werden zwischen HP-Core und LP-Core geteilt
//     (bleiben über HP-Deep-Sleep erhalten, Binary-Load initialisiert sie neu)

// ============================================
// Globale Variablen
// ============================================
httpd_handle_t server = NULL;  // ESP-IDF HTTP Server Handle
bool littlefs_mounted = false;
bool server_started = false;  // Flag: Web-Server gestartet?
// Akku-Messwerte
uint32_t battery_adc_mv = 0;  // ADC-Wert in Millivolt
float battery_voltage = 0.0f;
uint8_t battery_percent = 0;

// ADC-Handles (ESP-IDF)
adc_oneshot_unit_handle_t adc1_handle = NULL;
adc_cali_handle_t adc1_cali_handle = NULL;

// Web-Server Inaktivitäts-Timer
volatile uint64_t last_web_activity_us = 0;  // Zeitpunkt der letzten Web-Server-Aktivität (Mikrosekunden)

// Deep-Sleep-Steuerung (zentralisiert in web_timeout_task)
bool should_enter_deep_sleep = false;
const char* deep_sleep_reason = NULL;

// Reboot-Steuerung: Flag setzen, Ausführung in web_timeout_task
bool reboot_requested = false;
const char* reboot_reason = NULL;

// Funktionsdeklarationen
void web_timeout_task(void *parameter);
void enter_deep_sleep_with_gpio_and_timer_wakeup(bool enable_timer);
bool write_ulp_pulse_counter_to_ring_buffer();

static bool wake_allows_web_ui(esp_sleep_wakeup_cause_t reason) {
    return reason == ESP_SLEEP_WAKEUP_GPIO || reason == ESP_SLEEP_WAKEUP_EXT0 ||
           reason == ESP_SLEEP_WAKEUP_EXT1 || reason == ESP_SLEEP_WAKEUP_UNDEFINED;
}

/** 1-s-Pause vor erster Log-Ausgabe: Serial-Monitor nach Flash/Reboot oder Taster-Wake. */
static bool wake_needs_serial_monitor_delay(esp_sleep_wakeup_cause_t reason) {
    return reason == ESP_SLEEP_WAKEUP_UNDEFINED || reason == ESP_SLEEP_WAKEUP_GPIO ||
           reason == ESP_SLEEP_WAKEUP_EXT0 || reason == ESP_SLEEP_WAKEUP_EXT1;
}

/** true = jetzt transfer_data() ausführen (Timer-Wake-up, Intervall aus Config). */
static bool timer_wake_should_transfer(bool config_available) {
    if (!config_available || config_rtc.transfer_minutes == 255) {
        return false;
    }
    if (config_rtc.wakeup_minutes == 0) {
        return false;
    }
    const uint8_t every_n = (uint8_t)(config_rtc.transfer_minutes / config_rtc.wakeup_minutes);
    const uint8_t interval = (every_n == 0) ? 1 : every_n;
    return (timer_wake_count % interval) == 0;
}

static void persist_pulse_counter_before_deep_sleep(void) {
    // Nur bei Low-Akku (< 30%): RTC-RAM kann unzuverlässig sein.
    // Bei Akku >= 30% (auch mit USB/VBUS) kein NVS-Schreiben → Flash-Schonung.
    if (battery_voltage < BATTERY_VOLTAGE_30) {
        ESP_LOGI(TAG, "Speichere ulp_pulse_counter in Ring-Speicher vor Deep-Sleep (< 30%%)...");
        write_ulp_pulse_counter_to_ring_buffer();
    } else {
        ESP_LOGI(TAG, "Akku-Spannung OK (>= 30%%) → ulp_pulse_counter bleibt im RTC-RAM (kein Schreiben nötig)");
    }
}

static void enter_deep_sleep_after_wakeup(bool enable_timer_wakeup) {
    persist_pulse_counter_before_deep_sleep();
    // ZigBee: CAN_SLEEP -> deinit -> WiFi in shutdown_resources(true)
    enter_deep_sleep_with_gpio_and_timer_wakeup(enable_timer_wakeup);
}

// ============================================
// ADC Initialisierung (ESP-IDF)
// ============================================
esp_err_t init_adc() {
    // ADC Unit initialisieren
    adc_oneshot_unit_init_cfg_t init_config1 = {
        .unit_id = ADC_UNIT_1,
    };
    esp_err_t ret = adc_oneshot_new_unit(&init_config1, &adc1_handle);
    if (ret != ESP_OK) {
        ESP_LOGE(TAG, "ADC Unit Initialisierung fehlgeschlagen: %s", esp_err_to_name(ret));
        return ret;
    }
    
    // ADC Channel konfigurieren
    adc_oneshot_chan_cfg_t config = {
        .atten = ADC_ATTEN_DB_12,
        .bitwidth = ADC_BITWIDTH_12,
    };
    ret = adc_oneshot_config_channel(adc1_handle, BATTERY_ADC_CHANNEL, &config);
    if (ret != ESP_OK) {
        ESP_LOGE(TAG, "ADC Channel Konfiguration fehlgeschlagen: %s", esp_err_to_name(ret));
        return ret;
    }
    
    // ADC Kalibrierung (Curve Fitting)
    adc_cali_curve_fitting_config_t cali_config = {
        .unit_id = ADC_UNIT_1,
        .atten = ADC_ATTEN_DB_12,
        .bitwidth = ADC_BITWIDTH_12,
    };
    ret = adc_cali_create_scheme_curve_fitting(&cali_config, &adc1_cali_handle);
    if (ret != ESP_OK) {
        ESP_LOGE(TAG, "ADC Kalibrierung fehlgeschlagen: %s", esp_err_to_name(ret));
        return ret;
    }
    
    ESP_LOGI(TAG, "ADC initialisiert (Channel %d, Unit 1)", BATTERY_ADC_CHANNEL);
    return ESP_OK;
}

// ============================================
// ADC-Messung mit Median-Filter (in Millivolt)
// ============================================
uint32_t read_adc_median_mv() {
    uint32_t adc_values[ADC_SAMPLE_COUNT];
    
    // Insertion Sort beim Einlesen (effizienter für kleine Arrays)
    for (int i = 0; i < ADC_SAMPLE_COUNT; i++) {
        // ADC-Rohwert lesen
        int adc_raw;
        esp_err_t ret = adc_oneshot_read(adc1_handle, BATTERY_ADC_CHANNEL, &adc_raw);
        if (ret != ESP_OK) {
            ESP_LOGE(TAG, "ADC-Lesefehler: %s", esp_err_to_name(ret));
            continue;
        }
        
        // In Millivolt konvertieren (kalibriert)
        int voltage_mv;
        ret = adc_cali_raw_to_voltage(adc1_cali_handle, adc_raw, &voltage_mv);
        if (ret != ESP_OK) {
            ESP_LOGE(TAG, "ADC-Kalibrierungsfehler: %s", esp_err_to_name(ret));
            continue;
        }
        
        uint32_t mv = (uint32_t)voltage_mv;
        
        // Einfügen und gleichzeitig sortieren (Insertion Sort)
        int j = i;
        while (j > 0 && adc_values[j - 1] > mv) {
            adc_values[j] = adc_values[j - 1];
            j--;
        }
        adc_values[j] = mv;
        
        vTaskDelay(pdMS_TO_TICKS(10));
    }
    
    // Median zurückgeben (mittlerer Wert im sortierten Array)
    return adc_values[ADC_SAMPLE_COUNT / 2];
}

// ============================================
// LittleFS Mount (einmalig)
// ============================================
bool mount_littlefs() {
    if (littlefs_mounted) {
        return true;
    }
    
    // LittleFS mit explizitem Partitionsnamen mounten
    esp_vfs_littlefs_conf_t conf = {
        .base_path = "/littlefs",
        .partition_label = "storage",
        .format_if_mount_failed = true,
        .dont_mount = false,
    };
    
    esp_err_t ret = esp_vfs_littlefs_register(&conf);
    if (ret != ESP_OK) {
        if (ret == ESP_FAIL) {
            ESP_LOGE(TAG, "LittleFS Mount fehlgeschlagen: Dateisystem konnte nicht formatiert werden");
        } else if (ret == ESP_ERR_NOT_FOUND) {
            ESP_LOGE(TAG, "LittleFS Mount fehlgeschlagen: Partition nicht gefunden");
        } else {
            ESP_LOGE(TAG, "LittleFS Mount fehlgeschlagen: %s", esp_err_to_name(ret));
        }
        return false;
    }
    
    littlefs_mounted = true;
    ESP_LOGI(TAG, "LittleFS erfolgreich gemountet");
    
    // Partitionsgröße ausgeben
    size_t total_bytes = 0;
    size_t used_bytes = 0;
    ret = esp_littlefs_info("storage", &total_bytes, &used_bytes);
    if (ret == ESP_OK) {
        ESP_LOGI(TAG, "LittleFS Partition: %zu KB gesamt, %zu KB verwendet (%.1f%%)", 
                 total_bytes / 1024, used_bytes / 1024, 
                 (float)used_bytes * 100.0f / (float)total_bytes);
    } else {
        ESP_LOGW(TAG, "LittleFS Info konnte nicht abgerufen werden: %s", esp_err_to_name(ret));
    }
    
    return true;
}

// ============================================
// NVS-Ring-Speicher: Höchsten Puls-Zähler-Wert finden
// ============================================
uint32_t find_max_pulse_and_index_from_nvs(uint32_t* out_max_index) {
    nvs_handle_t nvs_handle;
    esp_err_t err;
    uint32_t max_pulse = 0;
    uint32_t max_index = 0;  // Index des höchsten Wertes
    uint32_t found_count = 0;
    
    // NVS-Namespace aus spezieller Partition öffnen (read-only)
    err = nvs_open_from_partition(NVS_PARTITION_PULSE, NVS_NAMESPACE_PULSE, NVS_READONLY, &nvs_handle);
    if (err != ESP_OK) {
        ESP_LOGE(TAG, "NVS-Namespace '%s' in Partition '%s' konnte nicht geöffnet werden: %s", 
                 NVS_NAMESPACE_PULSE, NVS_PARTITION_PULSE, esp_err_to_name(err));
        if (out_max_index != nullptr) {
            *out_max_index = 0;
        }
        return 0;  // Keine Daten vorhanden
    }
    
    ESP_LOGI(TAG, "Durchsuche NVS-Ring-Speicher '%s' nach höchstem Puls-Zähler-Wert...", 
             NVS_NAMESPACE_PULSE);
    
    // Alle möglichen Keys durchsuchen (p_0 bis p_11999)
    for (uint32_t i = 0; i < RING_BUFFER_SIZE; i++) {
        char key[MAX_KEY_LENGTH];
        snprintf(key, sizeof(key), "%s%lu", NVS_KEY_PREFIX, i);
        
        uint32_t pulse_value = 0;
        
        // Versuche, den Wert zu lesen
        err = nvs_get_u32(nvs_handle, key, &pulse_value);
        if (err == ESP_OK) {
            // Wert gefunden
            found_count++;
            if (pulse_value > max_pulse) {
                max_pulse = pulse_value;
                max_index = i;  // Index des höchsten Wertes speichern
            }
        }
        // ESP_ERR_NVS_NOT_FOUND ignorieren (Key existiert nicht)
    }
    
    nvs_close(nvs_handle);
    
    if (out_max_index != nullptr) {
        *out_max_index = max_index;
    }
    
    if (found_count > 0) {
        if (max_pulse > 0) {
            // Echte Daten gefunden (Werte > 0)
            ESP_LOGI(TAG, "NVS-Ring-Speicher: %lu Einträge gefunden, höchster Wert: %lu (Index: %lu)", 
                     found_count, max_pulse, max_index);
        } else {
            // Nur Initialisierungsreste gefunden (alle Werte = 0)
            ESP_LOGI(TAG, "NVS-Ring-Speicher: %lu Initialisierungsreste gefunden (alle 0) - keine echten Daten", 
                     found_count);
            max_pulse = 0;  // Als "keine Daten" behandeln
        }
    } else {
        ESP_LOGI(TAG, "NVS-Ring-Speicher: Keine Einträge gefunden");
    }
    
    return max_pulse;
}

uint32_t find_max_pulse_from_nvs() {
    uint32_t dummy_index;
    return find_max_pulse_and_index_from_nvs(&dummy_index);
}

// ============================================
// Pulse-NVS-Partition initialisieren (minimal, nur für Ring-Speicher)
// ============================================
bool init_pulse_nvs_minimal() {
    // Prüfe, ob bereits initialisiert
    esp_err_t err = nvs_flash_init_partition(NVS_PARTITION_PULSE);
    if (err == ESP_OK) {
        return true;  // Bereits initialisiert
    }
    
    // Versuche zu initialisieren (ohne Löschung, da wir nur lesen/schreiben wollen)
    if (err == ESP_ERR_NVS_NO_FREE_PAGES || err == ESP_ERR_NVS_NEW_VERSION_FOUND) {
        ESP_LOGI(TAG, "Pulse-NVS-Partition '%s' benötigt Initialisierung...", NVS_PARTITION_PULSE);
        // Bei Wake-up: Versuche erneut zu initialisieren (ohne Löschung)
        err = nvs_flash_init_partition(NVS_PARTITION_PULSE);
    }
    
    if (err != ESP_OK) {
        ESP_LOGE(TAG, "Pulse-NVS-Initialisierung fehlgeschlagen: %s", esp_err_to_name(err));
        return false;
    }
    
    ESP_LOGI(TAG, "Pulse-NVS-Partition '%s' erfolgreich initialisiert", NVS_PARTITION_PULSE);
    return true;
}

// ============================================
// RTC ulp_pulse_counter: In Ring-Speicher schreiben (bei ESP.restart(), Akku-Low)
// ============================================
bool write_ulp_pulse_counter_to_ring_buffer() {
    // WICHTIG: Stelle sicher, dass Pulse-NVS initialisiert ist
    if (!init_pulse_nvs_minimal()) {
        ESP_LOGE(TAG, "FEHLER: Pulse-NVS konnte nicht initialisiert werden → kein Schreiben möglich");
        return false;
    }
    
    // Prüfung: Nur schreiben, wenn ulp_pulse_counter > 0
    if (*(volatile uint32_t *)&ulp_pulse_counter == 0) {
        ESP_LOGI(TAG, "ulp_pulse_counter ist 0 → Keine Ring-Speicher-Schreibung nötig");
        return true;  // Kein Fehler, einfach nichts zu speichern
    }
    
    // Prüfung: Nur schreiben, wenn ulp_pulse_counter > max_pulse aus Ring-Speicher
    uint32_t max_pulse = find_max_pulse_from_nvs();
    uint32_t current_pulse = *(volatile uint32_t *)&ulp_pulse_counter;
    if (current_pulse <= max_pulse) {
        ESP_LOGI(TAG, "ulp_pulse_counter nicht gespeichert: RTC=%lu <= Ring-Speicher-Max=%lu", 
                 current_pulse, max_pulse);
        return true;  // Kein Fehler, einfach nichts zu speichern
    }
    
    // Ring-Speicher öffnen
    nvs_handle_t nvs_handle;
    esp_err_t err = nvs_open_from_partition(NVS_PARTITION_PULSE, NVS_NAMESPACE_PULSE, NVS_READWRITE, &nvs_handle);
    if (err != ESP_OK) {
        ESP_LOGE(TAG, "Fehler beim Öffnen von Ring-Speicher für ulp_pulse_counter: %s", esp_err_to_name(err));
        return false;
    }
    
    // ring_idx aus RTC-RAM verwenden (nicht aus NVS lesen!)
    // WICHTIG: ring_idx wird im RTC-RAM gehalten, um Wear-Leveling-Hotspot zu vermeiden
    if (ring_idx >= RING_BUFFER_SIZE) {
        // ring_idx ist ungültig (z.B. nach Power-On, aber noch nicht initialisiert)
        ESP_LOGW(TAG, "WARNUNG: ring_idx ist ungültig! Sollte beim Boot initialisiert werden.");
        nvs_close(nvs_handle);
        return false;
    }
    
    // ulp_pulse_counter an Position ring_idx schreiben
    char key[MAX_KEY_LENGTH];
    snprintf(key, sizeof(key), "%s%lu", NVS_KEY_PREFIX, ring_idx);
    err = nvs_set_u32(nvs_handle, key, *(volatile uint32_t *)&ulp_pulse_counter);
    if (err != ESP_OK) {
        ESP_LOGE(TAG, "Fehler beim Schreiben von ulp_pulse_counter in Ring-Speicher: %s", esp_err_to_name(err));
        nvs_close(nvs_handle);
        return false;
    }
    
    // Ring-Index inkrementieren (modulo RING_BUFFER_SIZE) - NUR im RTC-RAM!
    // NICHT mehr in NVS speichern (vermeidet Wear-Leveling-Hotspot)
    ring_idx = (ring_idx + 1) % RING_BUFFER_SIZE;
    
    // Änderungen committen
    err = nvs_commit(nvs_handle);
    if (err != ESP_OK) {
        ESP_LOGE(TAG, "Fehler beim Commit von Ring-Speicher: %s", esp_err_to_name(err));
        nvs_close(nvs_handle);
        return false;
    }
    
    nvs_close(nvs_handle);
    
    ESP_LOGI(TAG, "ulp_pulse_counter in Ring-Speicher geschrieben: %lu (Position: %lu, nächster Index: %lu)", 
             *(volatile uint32_t *)&ulp_pulse_counter, (ring_idx == 0 ? RING_BUFFER_SIZE - 1 : ring_idx - 1), ring_idx);
    return true;
}


static bool restart_lp_core_with_retries(uint32_t observed_heartbeat) {
    static constexpr uint8_t MAX_RETRIES = 3;

    for (uint8_t attempt = 1; attempt <= MAX_RETRIES; ++attempt) {
        ESP_LOGW(TAG,
                 "LP-Core Heartbeat unverändert (%lu) → starte LP-Core (Versuch %u/%u)",
                 (unsigned long)observed_heartbeat,
                 (unsigned)attempt,
                 (unsigned)MAX_RETRIES);

        if (start_lp_core()) {
            return true;
        }
    }

    ESP_LOGE(TAG, "FEHLER: LP-Core konnte nach %u Versuchen nicht gestartet werden",
             (unsigned)MAX_RETRIES);
    return false;
}

// FreeRTOS Task für LP-Core Watchdog
void lp_core_watchdog_task(void *parameter) {
    
    ESP_LOGI(TAG, "LP-Core Watchdog Task gestartet");
    
    // Prüft sofort beim Task-Start und danach alle LP_CORE_WATCHDOG_MS.
    // last_lp_core_running liegt im RTC-RAM und überlebt den HP-Deep-Sleep.
    while (1) {
        const uint32_t current_lp_core_running =
            *(volatile uint32_t *)&ulp_lp_core_running;

        // uint32_t-Subtraktion bleibt auch beim Überlauf korrekt:
        // 0 = unverändert, jeder andere Wert = LP-Core hat Fortschritt gemacht.
        if (current_lp_core_running - last_lp_core_running) {
            last_lp_core_running = current_lp_core_running;
        } else {
            const bool lp_core_started =
                restart_lp_core_with_retries(current_lp_core_running);

            // Auch nach einem Fehlschlag die tatsächliche Basis übernehmen:
            // start_lp_core() setzt den Heartbeat auf 0. Nach dem normalen
            // Watchdog-Delay führt 0 - 0 wieder zu einem Recovery-Versuch.
            last_lp_core_running = *(volatile uint32_t *)&ulp_lp_core_running;

            if (!lp_core_started) {
                ESP_LOGE(TAG,
                         "LP-Core weiterhin inaktiv; nächster Versuch nach %u ms",
                         (unsigned)LP_CORE_WATCHDOG_MS);
            }
        }

        // Der Delay gilt auch nach drei fehlgeschlagenen Startversuchen.
        vTaskDelay(pdMS_TO_TICKS(LP_CORE_WATCHDOG_MS));
    }
}

// ============================================
// NVS-Ring-Speicher initialisieren (alle Werte auf 0)
// ============================================
bool init_pulse_ring_nvs() {
    nvs_handle_t nvs_handle;
    esp_err_t err;
    bool success = true;
    
    // NVS-Namespace aus spezieller Partition öffnen (read-write)
    err = nvs_open_from_partition(NVS_PARTITION_PULSE, NVS_NAMESPACE_PULSE, NVS_READWRITE, &nvs_handle);
    if (err != ESP_OK) {
        ESP_LOGE(TAG, "NVS-Namespace '%s' in Partition '%s' konnte nicht geöffnet werden: %s", 
                 NVS_NAMESPACE_PULSE, NVS_PARTITION_PULSE, esp_err_to_name(err));
        return false;
    }
    
    ESP_LOGI(TAG, "Initialisiere NVS-Ring-Speicher (Metadaten)...");
    
    // Alte Initialisierungsreste löschen (falls vorhanden)
    // Wir löschen alle p_* Keys, die möglicherweise von einem vorherigen fehlgeschlagenen Versuch stammen
    // Dies ist sicher, da wir Lazy Initialization verwenden und nur Metadaten speichern
    ESP_LOGI(TAG, "Lösche eventuelle Initialisierungsreste...");
    for (uint32_t i = 0; i < RING_BUFFER_SIZE; i++) {
        char key[MAX_KEY_LENGTH];
        snprintf(key, sizeof(key), "%s%lu", NVS_KEY_PREFIX, i);
        // Versuche Key zu löschen (ignoriere Fehler, wenn Key nicht existiert)
        nvs_erase_key(nvs_handle, key);
    }
    
    // WICHTIG: Wir initialisieren NICHT alle 12.000 Einträge auf einmal!
    // Stattdessen verwenden wir "Lazy Initialization":
    // - Einträge werden erst beim tatsächlichen Schreiben angelegt
    // - Beim Lesen: Wenn ein Eintrag nicht existiert, ist er implizit 0
    // Dies spart NVS-Speicherplatz und vermeidet ESP_ERR_NVS_NOT_ENOUGH_SPACE
    
    // WICHTIG: Ring-Index wird NICHT mehr in NVS gespeichert!
    // Stattdessen wird ring_idx im RTC-RAM gehalten (vermeidet Wear-Leveling-Hotspot)
    // ring_idx wird beim Boot (Power-On/ESP.restart()) aus Ring-Speicher ermittelt
    
    // Versionsnummer setzen
    uint32_t version = RING_BUFFER_VERSION;
    err = nvs_set_u32(nvs_handle, NVS_KEY_VERSION, version);
    if (err != ESP_OK) {
        ESP_LOGE(TAG, "FEHLER beim Setzen der Versionsnummer: %s", esp_err_to_name(err));
        success = false;
    }
    
    // Änderungen committen
    err = nvs_commit(nvs_handle);
    if (err != ESP_OK) {
        ESP_LOGE(TAG, "FEHLER beim Committen der NVS-Änderungen: %s", esp_err_to_name(err));
        nvs_close(nvs_handle);
        return false;
    }
    
    nvs_close(nvs_handle);
    
    if (success) {
        ESP_LOGI(TAG, "NVS-Ring-Speicher erfolgreich initialisiert (Version %lu, Timestamp: %lu)", 
                 version, version);
    } else {
        ESP_LOGW(TAG, "WARNUNG: NVS-Ring-Speicher-Initialisierung mit Fehlern abgeschlossen!");
    }
    
    return success;
}

// ============================================
// NVS-Ring-Speicher: Versionsnummer prüfen und ggf. initialisieren
// ============================================
bool check_and_init_pulse_ring_nvs() {
    nvs_handle_t nvs_handle;
    esp_err_t err;
    
    // NVS-Namespace aus spezieller Partition öffnen (read-only)
    err = nvs_open_from_partition(NVS_PARTITION_PULSE, NVS_NAMESPACE_PULSE, NVS_READONLY, &nvs_handle);
    if (err != ESP_OK) {
        // Namespace existiert nicht → Initialisierung erforderlich
        ESP_LOGI(TAG, "NVS-Namespace '%s' in Partition '%s' existiert nicht → Initialisierung erforderlich", 
                 NVS_NAMESPACE_PULSE, NVS_PARTITION_PULSE);
        return init_pulse_ring_nvs();
    }
    
    // Versionsnummer lesen
    uint32_t stored_version = 0;
    err = nvs_get_u32(nvs_handle, NVS_KEY_VERSION, &stored_version);
    nvs_close(nvs_handle);
    
    if (err != ESP_OK) {
        // Versionsnummer existiert nicht → Initialisierung erforderlich
        ESP_LOGI(TAG, "Versionsnummer nicht gefunden → Initialisierung erforderlich");
        return init_pulse_ring_nvs();
    }
    
    if (stored_version != RING_BUFFER_VERSION) {
        // Versionsnummer stimmt nicht überein → Code wurde neu hochgeladen
        // Ring-Speicher löschen und auf 0 setzen (neuer Code = neuer Start)
        ESP_LOGI(TAG, "Versionsnummer stimmt nicht überein (gespeichert: %lu, erwartet: %lu) → Code-Upload erkannt, Ring-Speicher wird gelöscht",
                 stored_version, RING_BUFFER_VERSION);
        return init_pulse_ring_nvs();
    }
    
    // Versionsnummer stimmt → keine Initialisierung nötig
    ESP_LOGI(TAG, "NVS-Ring-Speicher Version %lu ist gültig → keine Initialisierung nötig", stored_version);
    return true;
}

// ============================================
// NVS-Partition initialisieren (Hilfsfunktion)
// ============================================
// Initialisiert eine NVS-Partition (Standard oder Pulse)
// WICHTIG: nvs_flash_init() ist idempotent - wenn bereits initialisiert, passiert nichts (keine Wear!)
// Bei Power-On: Partition wird gelöscht und neu initialisiert (falls nötig)
// Bei Deep-Sleep-Wake-up: Versucht erneut zu initialisieren ohne Löschung (NVS sollte noch vorhanden sein)
bool init_nvs_partition(const char* partition_name, bool is_power_on, bool is_standard_nvs) {
    esp_err_t err;
    
    // Initialisierung versuchen (Standard-NVS oder Pulse-NVS)
    ESP_LOGI(TAG, "init_nvs_partition: Initialisiere %s (is_power_on=%s, is_standard_nvs=%s)...", 
             partition_name, is_power_on ? "true" : "false", is_standard_nvs ? "true" : "false");
    if (is_standard_nvs) {
        err = nvs_flash_init();
    } else {
        err = nvs_flash_init_partition(partition_name);
    }
    ESP_LOGI(TAG, "init_nvs_partition: %s Initialisierung: %s", partition_name, esp_err_to_name(err));
    
    // Prüfen, ob Neuinitialisierung erforderlich ist
    if (err == ESP_ERR_NVS_NO_FREE_PAGES || err == ESP_ERR_NVS_NEW_VERSION_FOUND) {
        ESP_LOGW(TAG, "init_nvs_partition: %s benötigt Neuinitialisierung (err=%s)", partition_name, esp_err_to_name(err));
        if (is_power_on) {
            // Bei Power-On: Partition löschen und neu initialisieren
            ESP_LOGI(TAG, "init_nvs_partition: %s muss neu initialisiert werden (Power-On → Partition wird gelöscht)...", partition_name);
            esp_err_t erase_err = is_standard_nvs ? 
                nvs_flash_erase() : 
                nvs_flash_erase_partition(partition_name);
            if (erase_err == ESP_OK) {
                ESP_LOGI(TAG, "init_nvs_partition: %s erfolgreich gelöscht", partition_name);
                err = is_standard_nvs ? 
                    nvs_flash_init() : 
                    nvs_flash_init_partition(partition_name);
                ESP_LOGI(TAG, "init_nvs_partition: %s nach Löschung neu initialisiert: %s", partition_name, esp_err_to_name(err));
            } else {
                ESP_LOGE(TAG, "init_nvs_partition: %s-Löschung fehlgeschlagen: %s", partition_name, esp_err_to_name(erase_err));
            }
        } else {
            // Bei Deep-Sleep-Wake-up: Versuche erneut ohne Löschung (NVS sollte noch vorhanden sein)
            ESP_LOGW(TAG, "init_nvs_partition: WARNUNG: %s benötigt Neuinitialisierung bei Deep-Sleep-Wake-up!", partition_name);
            ESP_LOGI(TAG, "init_nvs_partition: Versuche erneut zu initialisieren (ohne Löschung - Daten sollten erhalten bleiben)...");
            err = is_standard_nvs ? 
                nvs_flash_init() : 
                nvs_flash_init_partition(partition_name);
            ESP_LOGI(TAG, "init_nvs_partition: %s erneute Initialisierung (ohne Löschung): %s", partition_name, esp_err_to_name(err));
        }
    }
    
    // Ergebnis prüfen
    if (err != ESP_OK) {
        ESP_LOGE(TAG, "%s-Initialisierung fehlgeschlagen: %s", partition_name, esp_err_to_name(err));
        return false;
    }
    ESP_LOGI(TAG, "%s erfolgreich initialisiert", partition_name);
    return true;
}

// ============================================
// NVS-Partitionen initialisieren
// ============================================
// Initialisiert beide NVS-Partitionen (Standard und Pulse)
// Wird bei Power-On und Deep-Sleep-Wake-up aufgerufen
void init_nvs_partitions(bool is_power_on) {
    init_nvs_partition("Standard-NVS", is_power_on, true);
    init_nvs_partition(NVS_PARTITION_PULSE, is_power_on, false);
}

// ============================================
// ring_idx und ulp_pulse_counter initialisieren (kombiniert)
// ============================================
// Initialisiert ring_idx und ulp_pulse_counter aus RTC-RAM oder NVS-Ring-Speicher
// ring_idx: Ring-Buffer-Index (im RTC-RAM, wird bei Power-On/ESP.restart() neu ermittelt)
//           Bei Deep-Sleep-Wake-up sollte ring_idx noch im RTC-RAM vorhanden sein
// ulp_pulse_counter: Puls-Zähler (im RTC-RAM, wird bei Power-On/ESP.restart() aus Ring-Speicher geladen)
//                Bei Deep-Sleep-Wake-up ist RTC-RAM noch vorhanden und muss NICHT geladen werden
void init_ring_buffer_and_ulp_pulse_counter(bool is_power_on) {
    // ring_idx initialisieren
    // Bei Power-On oder wenn ring_idx ungültig: aus Ring-Speicher ermitteln
    if (is_power_on || ring_idx >= RING_BUFFER_SIZE) {
        uint32_t max_index = 0;
        uint32_t max_pulse = find_max_pulse_and_index_from_nvs(&max_index);
        if (max_pulse > 0) {
            // Nächster freier Slot: (max_index + 1) % RING_BUFFER_SIZE
            ring_idx = (max_index + 1) % RING_BUFFER_SIZE;
            ESP_LOGI(TAG, "ring_idx aus Ring-Speicher: %lu (höchster Index: %lu)", ring_idx, max_index);
        } else {
            ring_idx = 0;  // Erster Slot (keine Daten vorhanden)
            ESP_LOGI(TAG, "ring_idx auf 0 gesetzt (keine Daten im Ring-Speicher)");
        }
    } else {
        // Bei Deep-Sleep-Wake-up: ring_idx aus RTC-RAM übernehmen
        ESP_LOGI(TAG, "ring_idx aus RTC-RAM: %lu", ring_idx);
    }
    
    // ulp_pulse_counter initialisieren
    // WICHTIG: Bei Power-On ist RTC-RAM IMMER leer/uninitialisiert (auch wenn zufällige Werte drin stehen)
    //          → IMMER aus NVS laden
    //          Bei Deep-Sleep-Wake-up ist RTC-RAM noch vorhanden → aus RTC-RAM verwenden
    uint32_t current_pulse = *(volatile uint32_t *)&ulp_pulse_counter;
    
    if (is_power_on) {
        // Power-On: RTC-RAM ist leer/uninitialisiert → IMMER aus NVS laden
        uint32_t max_index = 0;
        uint32_t max_pulse = find_max_pulse_and_index_from_nvs(&max_index);
        
        if (max_pulse > 0) {
            // Ring-Speicher enthält Daten → verwende diesen Wert
            *(volatile uint32_t *)&ulp_pulse_counter = max_pulse;
            ESP_LOGI(TAG, "ulp_pulse_counter aus Ring-Speicher: %lu (Power-On, RTC-RAM war: %lu)", max_pulse, current_pulse);
        } else {
            // Ring-Speicher ist leer (z.B. nach Code-Upload mit Versionsmismatch)
            *(volatile uint32_t *)&ulp_pulse_counter = 0;
            ESP_LOGI(TAG, "ulp_pulse_counter auf 0 initialisiert (Power-On, keine Ring-Speicher-Daten, RTC-RAM war: %lu)", current_pulse);
        }
    } else {
        // Deep-Sleep-Wake-up: RTC-RAM ist noch vorhanden → aus RTC-RAM verwenden
        ESP_LOGI(TAG, "ulp_pulse_counter aus RTC-RAM: %lu (RTC-RAM behält Daten bei Deep-Sleep-Wake-up)", current_pulse);
    }
}

// ============================================
// Ressourcen sauber beenden (Web-Server, WiFi, LittleFS)
// ============================================
void shutdown_resources(bool for_imminent_restart) {
    const bool zigbee_was_active =
        (strcmp(config_rtc.transfer_mode, TRANSFER_MODE_ZIGBEE) == 0);

    // ZigBee: CAN_SLEEP abwarten (Main-Loop laeuft), dann Deinit, danach WiFi-Stop
    if (for_imminent_restart && zigbee_was_active && transfer_zigbee_is_initialized()) {
        ESP_LOGI(TAG, "Warte auf ZigBee CAN_SLEEP vor Shutdown (max %d ms)...",
                 ZIGBEE_CAN_SLEEP_WAIT_MS);
        if (transfer_zigbee_wait_can_sleep(ZIGBEE_CAN_SLEEP_WAIT_MS)) {
            ESP_LOGI(TAG, "ZigBee CAN_SLEEP empfangen – Deinit, danach WiFi-Stop");
        } else {
            ESP_LOGW(TAG, "ZigBee CAN_SLEEP Timeout – Deinit und WiFi-Stop trotzdem");
        }
    }

    // Transfer-Modus deinitialisieren (ZigBee Main Loop + NVS-Flush)
    transfer_deinit();
    
    // LED ausschalten (HP-Core wird beendet)
    gpio_set_level((gpio_num_t)LED_BUILTIN_GPIO, LED_OFF);
    ESP_LOGI(TAG, "Interne LED ausgeschaltet");
    
    ESP_LOGI(TAG, "Schließe Ressourcen...");
    
    // 1. mDNS stoppen
    mdns_free();
    ESP_LOGI(TAG, "mDNS gestoppt");
    vTaskDelay(pdMS_TO_TICKS(50));
    
    // 2. Web-Server stoppen
    if (server_started && server != NULL) {
        ESP_LOGI(TAG, "Stoppe Web-Server...");
        esp_err_t ret = httpd_stop(server);
        if (ret != ESP_OK) {
            ESP_LOGW(TAG, "httpd_stop() gab Fehler zurück: %s", esp_err_to_name(ret));
        }
        server = NULL;
        server_started = false;  // Flag zurücksetzen
        ESP_LOGI(TAG, "Web-Server gestoppt");
        vTaskDelay(pdMS_TO_TICKS(100));  // Kurze Verzögerung für sauberes Schließen
    }
    
    // 3. WiFi trennen und stoppen (nach ZigBee-Deinit; Stack/Main-Loop bereits beendet)
    if (wifi_manager_is_initialized()) {
        wifi_manager_session_end();
        vTaskDelay(pdMS_TO_TICKS(100));
    }
    
    // 5. LittleFS unmounten (sichert alle ausstehenden Schreibvorgänge)
    if (littlefs_mounted) {
        ESP_LOGI(TAG, "Unmounte LittleFS...");
        esp_err_t ret = esp_vfs_littlefs_unregister("storage");
        if (ret != ESP_OK) {
            ESP_LOGW(TAG, "esp_vfs_littlefs_unregister() gab Fehler zurück: %s", esp_err_to_name(ret));
        }
        littlefs_mounted = false;
        ESP_LOGI(TAG, "LittleFS unmounted");
        vTaskDelay(pdMS_TO_TICKS(50));
    }
    
    ESP_LOGI(TAG, "Alle Ressourcen freigegeben");
    console_flush_before_poweroff();
}

// ============================================
// Zentrale Reboot-Funktion
// ============================================
void perform_reboot(const char* reason) {
    ESP_LOGI(TAG, "Reboot wird durchgeführt: %s", reason);
    
    // WICHTIG: ulp_pulse_counter vor esp_restart() in Ring-Speicher speichern
    // (RTC-RAM wird bei esp_restart() zurückgesetzt)
    ESP_LOGI(TAG, "Speichere ulp_pulse_counter in Ring-Speicher vor Reboot...");
    write_ulp_pulse_counter_to_ring_buffer();
    
    // Ressourcen sauber beenden (ZigBee-NVS-Flush in transfer_zigbee_deinit)
    shutdown_resources(true);
    
    ESP_LOGI(TAG, "Starte Reboot...");
    console_flush_before_poweroff();
    esp_restart();
}

// ============================================
// Berechne nächsten Timer-Wake-up-Zeitpunkt (Cron-ähnlich)
// ============================================
// Wake-up < 0.5 × wakeup_minutes → diesen Timer überspringen, nächstes volles Intervall
// (Extremfall: Schlafdauer ≈ 0.5× + 1× Intervall). Schützt vor Doppel-Wake nach Time-Sync.
uint64_t calculate_next_wakeup_timer() {
    struct tm timeinfo;
    time_t now;
    time(&now);
    if (!localtime_r(&now, &timeinfo)) {
        ESP_LOGW(TAG, "WARNUNG: Keine Zeit-Synchronisation → verwende Fallback-Intervall");
        return config_rtc.wakeup_minutes * 60 * 1000000ULL;  // Mikrosekunden
    }
    
    // 1. Ist-UNIX_EPOCH ermitteln
    time_t current_time = mktime(&timeinfo);
    
    // 2. Target-UNIX_EPOCH = Ist-UNIX_EPOCH + WAKEUP_BUFFER_SEC
    time_t target_time = current_time + WAKEUP_BUFFER_SEC;
    
    // 3. Intervall in Sekunden (z.B. 10 Minuten = 600 Sekunden)
    int interval_seconds = config_rtc.wakeup_minutes * 60;
    
    // 4. Auf nächste Intervall-Grenze aufrunden (Vielfaches von interval_seconds)
    // Beispiel: target_time = 12345, interval = 600 → next_wakeup = 12600
    time_t next_wakeup_time = ((target_time / interval_seconds) + 1) * interval_seconds;
    
    // 5. Wake-Interval = nächste Grenze minus Ist-Zeit
    int seconds_until_wakeup = (int)(next_wakeup_time - current_time);

    // 6. Zu kurzer Timer (< 0.5 × Intervall) → ein volles Intervall weiter (Cron-Grenze)
    const int min_sleep_seconds = (interval_seconds + 1) / 2;  // 0.5 × Intervall, aufgerundet
    if (seconds_until_wakeup < min_sleep_seconds) {
        const int skipped_seconds = seconds_until_wakeup;
        next_wakeup_time += interval_seconds;
        seconds_until_wakeup = (int)(next_wakeup_time - current_time);
        ESP_LOGI(TAG, "Wake-up zu kurz (%d s < 0.5×%d min) → übersprungen, nächstes volles Intervall (in %d s)",
                 skipped_seconds, config_rtc.wakeup_minutes, seconds_until_wakeup);
    }

    // 7. Zur Textausgabe: Target-UNIX_EPOCH in Time-struct wandeln
    struct tm next_wakeup_tm;
    localtime_r(&next_wakeup_time, &next_wakeup_tm);
    ESP_LOGI(TAG, "Aktuelle Zeit: %02d:%02d:%02d", timeinfo.tm_hour, timeinfo.tm_min, timeinfo.tm_sec);
    ESP_LOGI(TAG, "Nächster Wake-up: %02d:%02d:00 (in %d Sekunden = %.2f Minuten)", 
             next_wakeup_tm.tm_hour, next_wakeup_tm.tm_min, seconds_until_wakeup, (float)seconds_until_wakeup / 60.0f);
    
    // Konvertiere zu Mikrosekunden für esp_sleep_enable_timer_wakeup()
    return (uint64_t)seconds_until_wakeup * 1000000ULL;
}

// ============================================
// Deep-Sleep mit EXT1- und Timer-Wake-up konfigurieren
// ============================================
// enable_timer: true = Timer-Wake-up aktivieren, false = nur EXT1-Wake-up (Taster)
void enter_deep_sleep_with_gpio_and_timer_wakeup(bool enable_timer = true) {
    ESP_LOGI(TAG, "Konfiguriere Deep-Sleep mit EXT1-Wake-up (Taster A)...");
    
    // Taster A verwendet EXT1. Damit bleibt der generische LP_IO-Wake-Grund
    // ausschließlich dem Reed-Sensor auf GPIO2 vorbehalten.
    gpio_num_t gpio_num = (gpio_num_t)BUTTON_A_GPIO;
    
    // GPIO-Pin-Modus aus hardware.h bestimmen
    uint8_t gpio_mode = BUTTON_A_GPIO_MODE;
    esp_sleep_ext1_wakeup_mode_t wakeup_mode;
    int wakeup_level;
    const char* level_name;
    
    // EXT1 arbeitet beim ESP32-C6 pegelgesteuert. Der Taster muss vor
    // Deep-Sleep im nicht gedrückten Zustand sein.
    
    const bool is_rtc_gpio = rtc_gpio_is_valid_gpio(gpio_num);
    bool gpio_wakeup_configured = false;
    
    if (is_rtc_gpio) {
        ESP_LOGI(TAG, "GPIO%d ist RTC-fähig → konfiguriere EXT1-Wake-up", gpio_num);
        
        esp_err_t ret = rtc_gpio_init(gpio_num);
        if (ret == ESP_OK) {
            ret = rtc_gpio_set_direction(gpio_num, RTC_GPIO_MODE_INPUT_ONLY);
        }
        
        // Level basierend auf GPIO-Modus bestimmen
        if (ret == ESP_OK && gpio_mode == INPUT_PULLUP) {
            // INPUT_PULLUP: Taster zieht auf LOW → Wake-up bei LOW-Level
            wakeup_mode = ESP_EXT1_WAKEUP_ANY_LOW;
            wakeup_level = 0;
            level_name = "LOW LEVEL (Taster gedrückt = LOW)";
            ret = rtc_gpio_pullup_dis(gpio_num);
            if (ret == ESP_OK) {
                ret = rtc_gpio_pulldown_dis(gpio_num);
            }
            if (ret == ESP_OK) {
                ret = rtc_gpio_pullup_en(gpio_num);
            }
        } else if (ret == ESP_OK && gpio_mode == INPUT_PULLDOWN) {
            // INPUT_PULLDOWN: Taster zieht auf HIGH → Wake-up bei HIGH-Level
            wakeup_mode = ESP_EXT1_WAKEUP_ANY_HIGH;
            wakeup_level = 1;
            level_name = "HIGH LEVEL (Taster gedrückt = HIGH)";
            ret = rtc_gpio_pullup_dis(gpio_num);
            if (ret == ESP_OK) {
                ret = rtc_gpio_pulldown_dis(gpio_num);
            }
            if (ret == ESP_OK) {
                ret = rtc_gpio_pulldown_en(gpio_num);
            }
        } else if (ret == ESP_OK) {
            // INPUT (ohne Pull): Standardmäßig LOW-Level annehmen
            wakeup_mode = ESP_EXT1_WAKEUP_ANY_LOW;
            wakeup_level = 0;
            level_name = "LOW LEVEL (Default)";
            ret = rtc_gpio_pullup_dis(gpio_num);
            if (ret == ESP_OK) {
                ret = rtc_gpio_pulldown_dis(gpio_num);
            }
        }

        if (ret != ESP_OK) {
            ESP_LOGE(TAG, "FEHLER: Taster-RTC-GPIO konnte nicht konfiguriert werden: %s",
                     esp_err_to_name(ret));
        } else {
            // Alte RTC-/LP_IO-Wake-Konfiguration für GPIO1 sicher entfernen.
            // EXT1 nutzt einen getrennten Wake-Pfad und verändert GPIO2 nicht.
            ret = rtc_gpio_wakeup_disable(gpio_num);
            if (ret != ESP_OK) {
                ESP_LOGE(TAG, "FEHLER: Alte LP_IO-Konfiguration für Taster konnte nicht entfernt werden: %s",
                         esp_err_to_name(ret));
            }
        }

        // AUTO lässt ESP-IDF die für EXT1 und LP-Core nötigen Domains wählen.
        if (ret == ESP_OK) {
            ret = esp_sleep_pd_config(ESP_PD_DOMAIN_RTC_PERIPH, ESP_PD_OPTION_AUTO);
            if (ret != ESP_OK) {
                ESP_LOGE(TAG, "FEHLER: RTC_PERIPH AUTO konnte nicht gesetzt werden: %s",
                         esp_err_to_name(ret));
            }
        }

        if (ret == ESP_OK) {
            vTaskDelay(pdMS_TO_TICKS(50));
        }

        // Aktuellen GPIO-Zustand prüfen (für Debugging und Warnung)
        int gpio_state = rtc_gpio_get_level(gpio_num);
        ESP_LOGI(TAG, "BUTTON_A_GPIO aktueller Zustand: %s", gpio_state ? "HIGH" : "LOW");

        if (ret == ESP_OK && gpio_state == wakeup_level) {
            ESP_LOGW(TAG, "WARNUNG: BUTTON_A_GPIO ist bereits im EXT1-Wake-Level!");
            ESP_LOGW(TAG, "Stelle sicher, dass Taster nicht gedrückt ist, bevor Deep-Sleep startet!");
            return;
        }

        if (ret == ESP_OK) {
            ret = esp_sleep_enable_ext1_wakeup_io(1ULL << BUTTON_A_GPIO, wakeup_mode);
            if (ret != ESP_OK) {
                ESP_LOGE(TAG, "FEHLER: EXT1-Wake-up-Konfiguration fehlgeschlagen: %s",
                         esp_err_to_name(ret));
                ESP_LOGW(TAG, "Deep-Sleep wird ohne Taster-Wake-up gestartet!");
            } else {
                gpio_wakeup_configured = true;
                ESP_LOGI(TAG, "EXT1-Wake-up konfiguriert: Taster A (GPIO%d) - %s",
                         BUTTON_A_GPIO, level_name);
            }
        } else {
            ESP_LOGW(TAG, "Deep-Sleep wird ohne Taster-Wake-up gestartet!");
        }
    } else {
        ESP_LOGW(TAG, "WARNUNG: GPIO%d ist NICHT RTC-fähig (nur GPIOs 0-7)", gpio_num);
        ESP_LOGW(TAG, "EXT1-Wake-up (Taster A) kann nicht konfiguriert werden!");
        ESP_LOGW(TAG, "Nur Timer-Wake-up möglich (falls aktiviert)");
    }
    
    // Timer-Wake-up berechnen und aktivieren (nur wenn enable_timer == true)
    // WICHTIG: Bei kritischer Akku-Spannung (<= BATTERY_VOLTAGE_PROTECTION) wird Timer deaktiviert,
    // um weiteren Akku-Verschleiß durch automatische Wake-ups zu vermeiden
    bool timer_activated = false;
    uint64_t wakeup_time_us = 0;
    struct tm next_wakeup_tm = {0};
    
    if (enable_timer) {
        wakeup_time_us = calculate_next_wakeup_timer();
        
        if (wakeup_time_us > 0) {
            esp_err_t ret = esp_sleep_enable_timer_wakeup(wakeup_time_us);
            if (ret != ESP_OK) {
                ESP_LOGE(TAG, "FEHLER: Timer-Wake-up-Konfiguration fehlgeschlagen: %s", esp_err_to_name(ret));
            } else {
                timer_activated = true;
                // Berechne nächste Wake-up-Zeit für Ausgabe
                struct tm timeinfo;
                time_t now;
                time(&now);
                if (localtime_r(&now, &timeinfo)) {
                    time_t current_time = mktime(&timeinfo);
                    time_t next_wakeup_time = current_time + (wakeup_time_us / 1000000ULL);
                    localtime_r(&next_wakeup_time, &next_wakeup_tm);
                }
            }
        }
    } else {
        ESP_LOGI(TAG, "Timer-Wake-up DEAKTIVIERT (nur EXT1-Taster-Wake-up aktiv)");
        ESP_LOGI(TAG, "Nur manueller Wake-up über Taster A möglich");
    }
    
    // Prüfen, ob mindestens eine Wake-up-Quelle konfiguriert wurde
    // WICHTIG: Ohne Wake-up-Quelle würde ESP32C6 nicht mehr aufwachen!
    if (!gpio_wakeup_configured && !timer_activated) {
        ESP_LOGE(TAG, "FEHLER: Keine Wake-up-Quelle konfiguriert!");
        ESP_LOGE(TAG, "Deep-Sleep wird ABGEBROCHEN - System bleibt aktiv");
        ESP_LOGE(TAG, "Mögliche Ursachen:");
        if (!is_rtc_gpio) {
            ESP_LOGE(TAG, "  - Taster-GPIO ist nicht EXT1-fähig (nur GPIOs 0-7)");
        }
        if (!enable_timer) {
            ESP_LOGE(TAG, "  - Timer-Wake-up ist deaktiviert (Akku-Schutz)");
        } else if (!timer_activated) {
            ESP_LOGE(TAG, "  - Timer-Wake-up konnte nicht aktiviert werden");
        }
        return;  // Funktion beenden, Ressourcen bleiben aktiv
    }
    
    // Ressourcen sauber beenden (nur wenn Wake-up konfiguriert wurde)
    // LED wird hier zentral in shutdown_resources() ausgeschaltet
    shutdown_resources(true);
    
    // Finale Deep-Sleep-Ausgabe (dynamisch basierend auf aktivierten Wake-up-Quellen)
    ESP_LOGI(TAG, "=== Gehe in Deep-Sleep ===");
    ESP_LOGI(TAG, "Wake-up möglich durch:");
    if (gpio_wakeup_configured) {
        ESP_LOGI(TAG, "  - Taster A (EXT1-Wake-up)");
    } else {
        ESP_LOGI(TAG, "  - Taster A: NICHT verfügbar (EXT1 nicht konfiguriert)");
    }
    if (timer_activated) {
        ESP_LOGI(TAG, "  - Timer (Cron-Intervall): %02d:%02d:00 (in %llu Sekunden = %.2f Minuten)",
                 next_wakeup_tm.tm_hour, next_wakeup_tm.tm_min,
                 wakeup_time_us / 1000000ULL, (float)wakeup_time_us / 60000000.0f);
    } else {
        if (enable_timer) {
            ESP_LOGI(TAG, "  - Timer: FEHLER bei Aktivierung");
        } else {
            ESP_LOGI(TAG, "  - Timer: DEAKTIVIERT (Akku-Schutz)");
        }
    }
    console_flush_before_poweroff();

    esp_deep_sleep_start();
    // Ab hier wird Code nicht mehr ausgeführt
}

// ============================================
// Config.json laden
// ============================================
bool load_config() {
    // Prüfen, ob Config bereits geladen ist (z.B. aus RTC-RAM nach Wake-up)
    if (config_rtc.config_loaded) {
        bool rtc_valid = true;

        // Wake-up Intervall plausibilisieren
        if (config_rtc.wakeup_minutes < 1 || config_rtc.wakeup_minutes > 60) {
            rtc_valid = false;
        }

        // WiFi-Creds Anzahl plausibilisieren
        if (config_rtc.wifi_count > 2) {
            rtc_valid = false;
        }

        // Transfer-Intervall plausibilisieren
        if (!(config_rtc.transfer_minutes == 255 || config_rtc.transfer_minutes <= 60)) {
            rtc_valid = false;
        }

        // Transfer-Mode plausibilisieren (sicher gegen fehlende Null-Terminierung)
        bool transfer_mode_null_terminated = false;
        for (size_t i = 0; i < sizeof(config_rtc.transfer_mode); i++) {
            if (config_rtc.transfer_mode[i] == '\0') {
                transfer_mode_null_terminated = true;
                break;
            }
        }
        if (!transfer_mode_null_terminated) {
            rtc_valid = false;
        } else {
            if (strcmp(config_rtc.transfer_mode, "zigbee") != 0 &&
                strcmp(config_rtc.transfer_mode, "ble") != 0 &&
                strcmp(config_rtc.transfer_mode, "mqtt") != 0 &&
                strcmp(config_rtc.transfer_mode, "none") != 0) {
                rtc_valid = false;
            }
        }

        // MQTT-Konfiguration plausibilisieren
        if (config_rtc.mqtt_port == 0) {
            rtc_valid = false;
        }
        if (strnlen(config_rtc.mqtt_main_topic, sizeof(config_rtc.mqtt_main_topic)) == 0) {
            rtc_valid = false;
        }

        // RTC-RAM Plausibilität (vor allem TX-Power, damit Brownout/seltene RAM-Korruption
        // nicht zu ungültigen Funktionsparametern führt)
        if (!(config_rtc.wifi_tx_power_dbm == 2 || config_rtc.wifi_tx_power_dbm == 5 ||
              config_rtc.wifi_tx_power_dbm == 8 || config_rtc.wifi_tx_power_dbm == 11 ||
              config_rtc.wifi_tx_power_dbm == 14 || config_rtc.wifi_tx_power_dbm == 17 ||
              config_rtc.wifi_tx_power_dbm == 20)) {
            ESP_LOGW(TAG, "RTC wifi_tx_power_dbm ungültig (%d) → Default", config_rtc.wifi_tx_power_dbm);
            config_rtc.wifi_tx_power_dbm = (int8_t)(WIFI_TX_POWER_DEFAULT / 4);
        }
        if (!(config_rtc.ble_tx_power_dbm == 3 || config_rtc.ble_tx_power_dbm == 6 ||
              config_rtc.ble_tx_power_dbm == 9 || config_rtc.ble_tx_power_dbm == 12 ||
              config_rtc.ble_tx_power_dbm == 15 || config_rtc.ble_tx_power_dbm == 18 ||
              config_rtc.ble_tx_power_dbm == 20)) {
            ESP_LOGW(TAG, "RTC ble_tx_power_dbm ungültig (%d) → Default", config_rtc.ble_tx_power_dbm);
            config_rtc.ble_tx_power_dbm = (int8_t)BLE_TX_POWER_DBM;
        }
        if (!(config_rtc.zigbee_tx_power_dbm == -9 || config_rtc.zigbee_tx_power_dbm == -6 ||
              config_rtc.zigbee_tx_power_dbm == -3 || config_rtc.zigbee_tx_power_dbm == 0 ||
              config_rtc.zigbee_tx_power_dbm == 3 || config_rtc.zigbee_tx_power_dbm == 6 ||
              config_rtc.zigbee_tx_power_dbm == 10)) {
            ESP_LOGW(TAG, "RTC zigbee_tx_power_dbm ungültig (%d) → Default", config_rtc.zigbee_tx_power_dbm);
            config_rtc.zigbee_tx_power_dbm = (int8_t)ZIGBEE_TX_POWER_DEFAULT;
        }

        if (!rtc_valid) {
            ESP_LOGW(TAG, "RTC-Config unplausibel → config.json nachladen");
            config_rtc.config_loaded = false;  // -> normaler Pfad lädt aus Datei
        } else {
            ESP_LOGI(TAG, "Config bereits geladen (aus RTC-RAM) → kein erneutes Laden nötig");
            return true;
        }
    }
    
    if (!mount_littlefs()) {
        return false;
    }
    
    FILE* configFile = fopen("/littlefs/config.json", "r");
    if (!configFile) {
        ESP_LOGE(TAG, "config.json nicht gefunden");
        return false;
    }
    
    // Dateigröße ermitteln
    fseek(configFile, 0, SEEK_END);
    long size = ftell(configFile);
    fseek(configFile, 0, SEEK_SET);
    
    if (size > 1024) {
        ESP_LOGE(TAG, "config.json zu groß (%ld Bytes)", size);
        fclose(configFile);
        return false;
    }
    
    // Datei in Puffer lesen (ArduinoJson kann nicht direkt mit FILE* arbeiten)
    char* buffer = (char*)malloc(size + 1);
    if (!buffer) {
        ESP_LOGE(TAG, "Speicher für config.json Puffer fehlt");
        fclose(configFile);
        return false;
    }
    size_t read_size = fread(buffer, 1, size, configFile);
    fclose(configFile);
    buffer[read_size] = '\0';
    
    // JSON parsen
    JsonDocument doc;
    DeserializationError error = deserializeJson(doc, buffer);
    free(buffer);
    
    if (error) {
        ESP_LOGE(TAG, "JSON Parse Fehler: %s", error.c_str());  // ArduinoJson DeserializationError hat c_str()
        return false;
    }
    
    // Werte in RTC Memory speichern (mit Null-Terminierung)
    const char* hostname = doc["hostname"] | "gas-o-meter2";
    if (strlen(hostname) > HOSTNAME_MAX_LEN) {
        ESP_LOGW(TAG, "Hostname '%s' zu lang (%d > %d), wird gekürzt", hostname, strlen(hostname), HOSTNAME_MAX_LEN);
    }
    strncpy(config_rtc.hostname, hostname, sizeof(config_rtc.hostname) - 1);
    config_rtc.hostname[sizeof(config_rtc.hostname) - 1] = '\0';
    
    const char* adminpass = doc["adminpass"] | "";
    strncpy(config_rtc.adminpass, adminpass, sizeof(config_rtc.adminpass) - 1);
    config_rtc.adminpass[sizeof(config_rtc.adminpass) - 1] = '\0';
    
    // Wake-up Intervall: aus config.json oder Default aus hardware.h
    if (doc["wakeup_minutes"].is<uint8_t>()) {
        config_rtc.wakeup_minutes = doc["wakeup_minutes"].as<uint8_t>();
    } else {
        config_rtc.wakeup_minutes = DEFAULT_WAKEUP_INTERVAL_MIN;
    }
    
    // Transfer Intervall: aus config.json oder Default
    // In config.json wird der Multiplikator gespeichert, intern wird es in Minuten umgerechnet
    if (doc["transfer_interval_x"].is<uint8_t>()) {
        uint8_t multiplier = doc["transfer_interval_x"].as<uint8_t>();
        if (multiplier == 0) {
            config_rtc.transfer_minutes = 255;  // Nie
        } else {
            config_rtc.transfer_minutes = multiplier * config_rtc.wakeup_minutes;
        }
    } else if (doc["transfer_minutes"].is<uint8_t>()) {  // Rückwärtskompatibilität: alte config.json mit Minuten (als Multiplikator)
        uint8_t multiplier = doc["transfer_minutes"].as<uint8_t>();
        if (multiplier == 0) {
            config_rtc.transfer_minutes = 255;  // Nie
        } else {
            config_rtc.transfer_minutes = multiplier * config_rtc.wakeup_minutes;
        }
    } else if (doc["tarnsfer_minutes"].is<uint8_t>()) {  // Rückwärtskompatibilität: Tippfehler-Variante
        uint8_t multiplier = doc["tarnsfer_minutes"].as<uint8_t>();
        if (multiplier == 0) {
            config_rtc.transfer_minutes = 255;  // Nie
        } else {
            config_rtc.transfer_minutes = multiplier * config_rtc.wakeup_minutes;
        }
    } else {
        // Default: DEFAULT_TRANSFER_INTERVAL_X * wakeup_minutes (wenn wakeup_minutes aus config.json geladen wurde)
        // oder DEFAULT_TRANSFER_INTERVAL_X * DEFAULT_WAKEUP_INTERVAL_MIN (wenn wakeup_minutes auch nicht gesetzt)
        if (config_rtc.wakeup_minutes > 0) {
            config_rtc.transfer_minutes = DEFAULT_TRANSFER_INTERVAL_X * config_rtc.wakeup_minutes;
        } else {
            config_rtc.transfer_minutes = DEFAULT_TRANSFER_INTERVAL_X * DEFAULT_WAKEUP_INTERVAL_MIN;
        }
    }
    
    // ADC-Multiplikator: aus config.json oder Default aus hardware.h
    if (doc["adc_voltage_multiplier"].is<float>()) {
        config_rtc.adc_voltage_multiplier = doc["adc_voltage_multiplier"].as<float>();
    } else if (doc["adc_voltage_offset"].is<float>()) {
        // Legacy-Fallback: alte Offset-Config näherungsweise auf Multiplikator abbilden.
        // Arbeitspunkt: 4.0 V Akkuspannung (typischer LiPo-Bereich).
        const float legacy_offset = doc["adc_voltage_offset"].as<float>();
        config_rtc.adc_voltage_multiplier = 1.0f + (legacy_offset / 4.0f);
        ESP_LOGW(TAG, "Legacy-Feld adc_voltage_offset erkannt (%.3f V) -> adc_voltage_multiplier=%.4f (nahezu)",
                 legacy_offset, config_rtc.adc_voltage_multiplier);
    } else {
        config_rtc.adc_voltage_multiplier = ADC_VOLTAGE_MULTIPLIER;
    }
    
    // NTP-Server: aus config.json oder Default aus hardware.h
    if (doc["ntp_server"].is<const char*>()) {
        const char* ntp_server = doc["ntp_server"] | DEFAULT_NTP_SERVER;
        strncpy(config_rtc.ntp_server, ntp_server, sizeof(config_rtc.ntp_server) - 1);
        config_rtc.ntp_server[sizeof(config_rtc.ntp_server) - 1] = '\0';
    } else {
        strncpy(config_rtc.ntp_server, DEFAULT_NTP_SERVER, sizeof(config_rtc.ntp_server) - 1);
        config_rtc.ntp_server[sizeof(config_rtc.ntp_server) - 1] = '\0';
    }

    if (doc["mqtt_host"].is<const char*>()) {
        const char* mqtt_host = doc["mqtt_host"] | "";
        if (strlen(mqtt_host) > 0) {
            strncpy(config_rtc.mqtt_host, mqtt_host, sizeof(config_rtc.mqtt_host) - 1);
            config_rtc.mqtt_host[sizeof(config_rtc.mqtt_host) - 1] = '\0';
        } else {
            strncpy(config_rtc.mqtt_host, MQTT_DUMMY_HOST, sizeof(config_rtc.mqtt_host) - 1);
            config_rtc.mqtt_host[sizeof(config_rtc.mqtt_host) - 1] = '\0';
        }
    } else {
        strncpy(config_rtc.mqtt_host, MQTT_DUMMY_HOST, sizeof(config_rtc.mqtt_host) - 1);
        config_rtc.mqtt_host[sizeof(config_rtc.mqtt_host) - 1] = '\0';
    }

    if (doc["mqtt_port"].is<uint16_t>()) {
        uint16_t mqtt_port = doc["mqtt_port"].as<uint16_t>();
        config_rtc.mqtt_port = (mqtt_port == 0) ? MQTT_DEFAULT_PORT : mqtt_port;
    } else {
        config_rtc.mqtt_port = MQTT_DEFAULT_PORT;
    }

    if (doc["mqtt_username"].is<const char*>()) {
        const char* mqtt_username = doc["mqtt_username"] | "";
        strncpy(config_rtc.mqtt_username, mqtt_username, sizeof(config_rtc.mqtt_username) - 1);
        config_rtc.mqtt_username[sizeof(config_rtc.mqtt_username) - 1] = '\0';
    } else {
        config_rtc.mqtt_username[0] = '\0';
    }

    if (doc["mqtt_password"].is<const char*>()) {
        const char* mqtt_password = doc["mqtt_password"] | "";
        strncpy(config_rtc.mqtt_password, mqtt_password, sizeof(config_rtc.mqtt_password) - 1);
        config_rtc.mqtt_password[sizeof(config_rtc.mqtt_password) - 1] = '\0';
    } else {
        config_rtc.mqtt_password[0] = '\0';
    }

    if (doc["mqtt_main_topic"].is<const char*>()) {
        const char* mqtt_main_topic = doc["mqtt_main_topic"] | "";
        if (strlen(mqtt_main_topic) > 0) {
            strncpy(config_rtc.mqtt_main_topic, mqtt_main_topic, sizeof(config_rtc.mqtt_main_topic) - 1);
            config_rtc.mqtt_main_topic[sizeof(config_rtc.mqtt_main_topic) - 1] = '\0';
        } else {
            strncpy(config_rtc.mqtt_main_topic, config_rtc.hostname, sizeof(config_rtc.mqtt_main_topic) - 1);
            config_rtc.mqtt_main_topic[sizeof(config_rtc.mqtt_main_topic) - 1] = '\0';
        }
    } else {
        strncpy(config_rtc.mqtt_main_topic, config_rtc.hostname, sizeof(config_rtc.mqtt_main_topic) - 1);
        config_rtc.mqtt_main_topic[sizeof(config_rtc.mqtt_main_topic) - 1] = '\0';
    }

    config_rtc.mqtt_ha_autodiscovery = doc["mqtt_ha_autodiscovery"] | false;
    
    // Transfer-Mode: aus config.json oder Default "none"
    if (doc["transfer_mode"].is<const char*>()) {
        const char* transfer_mode = doc["transfer_mode"].as<const char*>();
        // Validiere Transfer-Mode (nur gültige Werte erlauben)
        if (strcmp(transfer_mode, "zigbee") == 0 || 
            strcmp(transfer_mode, "ble") == 0 || 
            strcmp(transfer_mode, "mqtt") == 0 || 
            strcmp(transfer_mode, "none") == 0) {
            strncpy(config_rtc.transfer_mode, transfer_mode, sizeof(config_rtc.transfer_mode) - 1);
            config_rtc.transfer_mode[sizeof(config_rtc.transfer_mode) - 1] = '\0';
        } else {
            // Ungültiger Wert → Default "none"
            strncpy(config_rtc.transfer_mode, "none", sizeof(config_rtc.transfer_mode) - 1);
            config_rtc.transfer_mode[sizeof(config_rtc.transfer_mode) - 1] = '\0';
        }
    } else {
        // Kein Transfer-Mode in JSON → Default "none"
        strncpy(config_rtc.transfer_mode, "none", sizeof(config_rtc.transfer_mode) - 1);
        config_rtc.transfer_mode[sizeof(config_rtc.transfer_mode) - 1] = '\0';
    }

    // WiFi TX Power (dBm, UI-Stufen)
    if (doc["wifi_tx_power_dbm"].is<int>()) {
        int v = doc["wifi_tx_power_dbm"].as<int>();
        bool ok = (v == 2 || v == 5 || v == 8 || v == 11 || v == 14 || v == 17 || v == 20);
        if (ok) {
            config_rtc.wifi_tx_power_dbm = (int8_t)v;
        } else {
            ESP_LOGW(TAG, "wifi_tx_power_dbm ungültig (%d) → Default", v);
            config_rtc.wifi_tx_power_dbm = (int8_t)(WIFI_TX_POWER_DEFAULT / 4);
        }
    }

    // BLE TX Power (dBm, Stufen)
    if (doc["ble_tx_power_dbm"].is<int>()) {
        int v = doc["ble_tx_power_dbm"].as<int>();
        bool ok = (v == 3 || v == 6 || v == 9 || v == 12 || v == 15 || v == 18 || v == 20);
        if (ok) {
            config_rtc.ble_tx_power_dbm = (int8_t)v;
        } else {
            ESP_LOGW(TAG, "ble_tx_power_dbm ungültig (%d) → Default", v);
            config_rtc.ble_tx_power_dbm = (int8_t)BLE_TX_POWER_DBM;
        }
    }

    // ZigBee TX Power (dBm, Stufen)
    if (doc["zigbee_tx_power_dbm"].is<int>()) {
        int v = doc["zigbee_tx_power_dbm"].as<int>();
        bool ok = (v == -9 || v == -6 || v == -3 || v == 0 || v == 3 || v == 6 || v == 10);
        if (ok) {
            config_rtc.zigbee_tx_power_dbm = (int8_t)v;
        } else {
            ESP_LOGW(TAG, "zigbee_tx_power_dbm ungültig (%d) → Default", v);
            config_rtc.zigbee_tx_power_dbm = (int8_t)ZIGBEE_TX_POWER_DEFAULT;
        }
    }
    
    // WiFi-Credentials laden (max. 2 Paare)
    config_rtc.wifi_count = 0;
    if (doc["wifiCredentials"].is<JsonArray>()) {
        JsonArray credentials = doc["wifiCredentials"].as<JsonArray>();
        uint8_t max_credentials = (credentials.size() > 2) ? 2 : credentials.size();
        
        for (uint8_t i = 0; i < max_credentials; i++) {
            if (credentials[i]["ssid"].is<const char*>() && credentials[i]["password"].is<const char*>()) {
                const char* ssid = credentials[i]["ssid"];
                const char* password = credentials[i]["password"];
                
                strncpy(config_rtc.wifi_credentials[i].ssid, ssid, sizeof(config_rtc.wifi_credentials[i].ssid) - 1);
                config_rtc.wifi_credentials[i].ssid[sizeof(config_rtc.wifi_credentials[i].ssid) - 1] = '\0';
                
                strncpy(config_rtc.wifi_credentials[i].password, password, sizeof(config_rtc.wifi_credentials[i].password) - 1);
                config_rtc.wifi_credentials[i].password[sizeof(config_rtc.wifi_credentials[i].password) - 1] = '\0';
                
                config_rtc.wifi_count++;
            }
        }
        
        if (credentials.size() > 2) {
            ESP_LOGW(TAG, "WARNUNG: Mehr als 2 WiFi-Credentials gefunden, nur die ersten 2 werden verwendet");
        }
        ESP_LOGI(TAG, "WiFi-Credentials geladen: %d Paar(e)", config_rtc.wifi_count);
    }
    
    // Debug: Geladene Config (inkl. TX-Power) ausgeben (ohne Passwörter im Klartext)
    ESP_LOGI(TAG, "=== Geladene Config (runtime) ===");
    ESP_LOGI(TAG, "  hostname: %s", config_rtc.hostname);
    ESP_LOGI(TAG, "  adminpass: (Länge: %zu)", strlen(config_rtc.adminpass));
    ESP_LOGI(TAG, "  wakeup_minutes: %d", config_rtc.wakeup_minutes);
    // JSON-Feld transfer_minutes / transfer_interval_x = Multiplikator (x Wake-ups); RTC = effektive Minuten
    if (config_rtc.transfer_minutes == 255) {
        ESP_LOGI(TAG, "  transfer: nie (Multiplikator 0, intern 255)");
    } else if (config_rtc.wakeup_minutes > 0) {
        uint8_t mult = (uint8_t)(config_rtc.transfer_minutes / config_rtc.wakeup_minutes);
        ESP_LOGI(TAG, "  transfer: Multiplikator %u × Wake-up %u Min. = %u Min. effektiv",
                 (unsigned)mult, (unsigned)config_rtc.wakeup_minutes, (unsigned)config_rtc.transfer_minutes);
    } else {
        ESP_LOGI(TAG, "  transfer: %u Min. effektiv (Wake-up ungültig, Multiplikator nicht angezeigt)",
                 (unsigned)config_rtc.transfer_minutes);
    }
    ESP_LOGI(TAG, "  transfer_mode: %s", config_rtc.transfer_mode);
    ESP_LOGI(TAG, "  wifi_tx_power_dbm: %d", config_rtc.wifi_tx_power_dbm);
    ESP_LOGI(TAG, "  ble_tx_power_dbm: %d", config_rtc.ble_tx_power_dbm);
    ESP_LOGI(TAG, "  zigbee_tx_power_dbm: %d", config_rtc.zigbee_tx_power_dbm);
    ESP_LOGI(TAG, "  adc_voltage_multiplier: %.4f", config_rtc.adc_voltage_multiplier);
    ESP_LOGI(TAG, "  ntp_server: %s", config_rtc.ntp_server);
    ESP_LOGI(TAG, "  mqtt_host: %s", config_rtc.mqtt_host);
    ESP_LOGI(TAG, "  mqtt_port: %u", (unsigned int)config_rtc.mqtt_port);
    ESP_LOGI(TAG, "  mqtt_username: %s", config_rtc.mqtt_username);
    ESP_LOGI(TAG, "  mqtt_password: %s (Länge: %zu)",
             (strlen(config_rtc.mqtt_password) > 0 ? "***" : "(leer)"),
             strlen(config_rtc.mqtt_password));
    ESP_LOGI(TAG, "  mqtt_main_topic: %s", config_rtc.mqtt_main_topic);
    ESP_LOGI(TAG, "  mqtt_ha_autodiscovery: %s", config_rtc.mqtt_ha_autodiscovery ? "true" : "false");
    ESP_LOGI(TAG, "  wifiCredentials: %d Set(s)", config_rtc.wifi_count);
    for (uint8_t i = 0; i < config_rtc.wifi_count && i < 2; i++) {
        ESP_LOGI(TAG, "    [%d] SSID: %s", i, config_rtc.wifi_credentials[i].ssid);
        ESP_LOGI(TAG, "    [%d] Password: %s (Länge: %zu)",
                 i,
                 (strlen(config_rtc.wifi_credentials[i].password) > 0 ? "***" : "(leer)"),
                 strlen(config_rtc.wifi_credentials[i].password));
    }
    ESP_LOGI(TAG, "================================");
    
    config_rtc.config_loaded = true;
    
    ESP_LOGI(TAG, "Config.json erfolgreich geladen");
    return true;
}

// ============================================
// Config speichern (RTC-RAM und config.json)
// ============================================
// Rückgabewert: true = erfolgreich, false = Fehler
// wifi_credentials_changed wird auf true gesetzt, wenn WiFi-Credentials geändert wurden
bool save_config(JsonDocument& doc, bool* wifi_credentials_changed = nullptr, char errorMessage[] = nullptr) {
    if (wifi_credentials_changed != nullptr) {
        *wifi_credentials_changed = false;
    }
    if (errorMessage != nullptr) {
        errorMessage[0] = '\0';
    }
    
    if (!mount_littlefs()) {
        ESP_LOGE(TAG, "Fehler: LittleFS nicht gemountet");
        if (errorMessage != nullptr) {
            strncpy(errorMessage, "Fehler: LittleFS nicht gemountet", 255);
        }
        return false;
    }
    
    // Alte WiFi-Credentials speichern für Vergleich
    struct {
        uint8_t count;
        char ssid[2][32];
        char password[2][64];
    } old_wifi;
    old_wifi.count = config_rtc.wifi_count;
    for (uint8_t i = 0; i < config_rtc.wifi_count && i < 2; i++) {
        strncpy(old_wifi.ssid[i], config_rtc.wifi_credentials[i].ssid, sizeof(old_wifi.ssid[i]) - 1);
        old_wifi.ssid[i][sizeof(old_wifi.ssid[i]) - 1] = '\0';
        strncpy(old_wifi.password[i], config_rtc.wifi_credentials[i].password, sizeof(old_wifi.password[i]) - 1);
        old_wifi.password[i][sizeof(old_wifi.password[i]) - 1] = '\0';
    }
    
    // Werte in RTC Memory speichern mit Validierung
    if (doc["hostname"].is<const char*>()) {
        const char* hostname = doc["hostname"];
        if (strlen(hostname) > 0 && strlen(hostname) < sizeof(config_rtc.hostname)) {
            strncpy(config_rtc.hostname, hostname, sizeof(config_rtc.hostname) - 1);
            config_rtc.hostname[sizeof(config_rtc.hostname) - 1] = '\0';
        } else {
            ESP_LOGE(TAG, "FEHLER: Hostname ungültig (leer oder zu lang)");
            if (errorMessage != nullptr) {
                strncpy(errorMessage, "Fehler: Hostname ungültig (leer oder zu lang)", 255);
            }
            return false;
        }
    }
    
    if (doc["adminpass"].is<const char*>()) {
        const char* adminpass = doc["adminpass"];
        if (strlen(adminpass) > 0 && strlen(adminpass) < sizeof(config_rtc.adminpass)) {
            strncpy(config_rtc.adminpass, adminpass, sizeof(config_rtc.adminpass) - 1);
            config_rtc.adminpass[sizeof(config_rtc.adminpass) - 1] = '\0';
        } else {
            ESP_LOGE(TAG, "FEHLER: Admin-Passwort ungültig (leer oder zu lang)");
            if (errorMessage != nullptr) {
                strncpy(errorMessage, "Fehler: Admin-Passwort ungültig (leer oder zu lang)", 255);
            }
            return false;
        }
    }
    
    if (doc["wakeup_minutes"].is<uint8_t>()) {
        uint8_t wakeup_minutes = doc["wakeup_minutes"].as<uint8_t>();
        if (wakeup_minutes >= 1 && wakeup_minutes <= 60) {
            config_rtc.wakeup_minutes = wakeup_minutes;
        } else {
            ESP_LOGE(TAG, "FEHLER: Wake-up Intervall ungültig (%d, muss zwischen 1-60 sein)", wakeup_minutes);
            if (errorMessage != nullptr) {
                strncpy(errorMessage, "Fehler: Wake-up Intervall ungültig (muss zwischen 1-60 sein)", 255);
            }
            return false;
        }
    }
    
    if (doc["transfer_minutes"].is<uint8_t>()) {
        uint8_t multiplier = doc["transfer_minutes"].as<uint8_t>();
        // Multiplikator 0 = nie (keine automatische Übertragung)
        // Multiplikator 1-60: muss sicherstellen, dass multiplier * wakeup_minutes <= 60
        if (multiplier == 0) {
            // 0 = nie: transfer_minutes auf einen sehr großen Wert setzen, damit die Bedingung nie erfüllt wird
            config_rtc.transfer_minutes = 255;  // Maximaler uint8_t Wert, wird nie durch tm_min (0-59) teilbar sein
        } else if (multiplier >= 1 && multiplier <= 60) {
            uint16_t calculated_minutes = multiplier * config_rtc.wakeup_minutes;
            if (calculated_minutes > 60) {
                ESP_LOGE(TAG, "FEHLER: Transfer Intervall ungültig (%d * %d = %d Min., muss <= 60 sein)", 
                         multiplier, config_rtc.wakeup_minutes, calculated_minutes);
                if (errorMessage != nullptr) {
                    char msg[255];
                    snprintf(msg, sizeof(msg), "Fehler: Transfer Intervall ungültig (%d * %d = %d Min., muss <= 60 sein)", 
                             multiplier, config_rtc.wakeup_minutes, calculated_minutes);
                    strncpy(errorMessage, msg, 255);
                }
                return false;
            }
            config_rtc.transfer_minutes = (uint8_t)calculated_minutes;
        } else {
            ESP_LOGE(TAG, "FEHLER: Transfer Intervall Multiplikator ungültig (%d, muss zwischen 0-60 sein)", multiplier);
            if (errorMessage != nullptr) {
                strncpy(errorMessage, "Fehler: Transfer Intervall Multiplikator ungültig (muss zwischen 0-60 sein, 0 = nie)", 255);
            }
            return false;
        }
    }
    
    if (doc["transfer_mode"].is<const char*>()) {
        const char* transfer_mode = doc["transfer_mode"].as<const char*>();
        if (strcmp(transfer_mode, "zigbee") != 0 && 
            strcmp(transfer_mode, "ble") != 0 && 
            strcmp(transfer_mode, "mqtt") != 0 && 
            strcmp(transfer_mode, "none") != 0) {
            ESP_LOGE(TAG, "FEHLER: Transfer-Mode ungültig (%s, muss zigbee/ble/mqtt/none sein)", transfer_mode);
            if (errorMessage != nullptr) {
                strncpy(errorMessage, "Fehler: Transfer-Mode ungültig (muss zigbee/ble/mqtt/none sein)", 255);
            }
            return false;
        }
        // Transfer-Mode ist gültig → in config_rtc speichern
        strncpy(config_rtc.transfer_mode, transfer_mode, sizeof(config_rtc.transfer_mode) - 1);
        config_rtc.transfer_mode[sizeof(config_rtc.transfer_mode) - 1] = '\0';
    }

    // WiFi TX Power (dBm, UI-Stufen)
    if (doc["wifi_tx_power_dbm"].is<int>()) {
        int v = doc["wifi_tx_power_dbm"].as<int>();
        bool ok = (v == 2 || v == 5 || v == 8 || v == 11 || v == 14 || v == 17 || v == 20);
        if (ok) {
            config_rtc.wifi_tx_power_dbm = (int8_t)v;
        } else {
            ESP_LOGE(TAG, "FEHLER: wifi_tx_power_dbm ungültig (%d)", v);
            if (errorMessage != nullptr) {
                strncpy(errorMessage, "Fehler: wifi_tx_power_dbm ungültig", 255);
            }
            return false;
        }
    }

    // BLE TX Power (dBm, Stufen)
    if (doc["ble_tx_power_dbm"].is<int>()) {
        int v = doc["ble_tx_power_dbm"].as<int>();
        bool ok = (v == 3 || v == 6 || v == 9 || v == 12 || v == 15 || v == 18 || v == 20);
        if (ok) {
            config_rtc.ble_tx_power_dbm = (int8_t)v;
        } else {
            ESP_LOGE(TAG, "FEHLER: ble_tx_power_dbm ungültig (%d)", v);
            if (errorMessage != nullptr) {
                strncpy(errorMessage, "Fehler: ble_tx_power_dbm ungültig", 255);
            }
            return false;
        }
    }

    // ZigBee TX Power (dBm, Stufen)
    if (doc["zigbee_tx_power_dbm"].is<int>()) {
        int v = doc["zigbee_tx_power_dbm"].as<int>();
        bool ok = (v == -9 || v == -6 || v == -3 || v == 0 || v == 3 || v == 6 || v == 10);
        if (ok) {
            config_rtc.zigbee_tx_power_dbm = (int8_t)v;
        } else {
            ESP_LOGE(TAG, "FEHLER: zigbee_tx_power_dbm ungültig (%d)", v);
            if (errorMessage != nullptr) {
                strncpy(errorMessage, "Fehler: zigbee_tx_power_dbm ungültig", 255);
            }
            return false;
        }
    }
    
    if (doc["adc_voltage_multiplier"].is<float>()) {
        float adc_voltage_multiplier = doc["adc_voltage_multiplier"].as<float>();
        if (adc_voltage_multiplier >= 0.5f && adc_voltage_multiplier <= 2.0f) {
            config_rtc.adc_voltage_multiplier = adc_voltage_multiplier;
        } else {
            ESP_LOGE(TAG, "FEHLER: ADC Spannungs-Multiplikator ungültig (%.4f, muss zwischen 0.5 und 2.0 sein)", adc_voltage_multiplier);
            if (errorMessage != nullptr) {
                strncpy(errorMessage, "Fehler: ADC Spannungs-Multiplikator ungültig (muss zwischen 0.5 und 2.0 sein)", 255);
            }
            return false;
        }
    } else if (doc["adc_voltage_offset"].is<float>()) {
        // Legacy-Fallback für ältere Clients/Configs.
        float legacy_offset = doc["adc_voltage_offset"].as<float>();
        config_rtc.adc_voltage_multiplier = 1.0f + (legacy_offset / 4.0f);
        ESP_LOGW(TAG, "Legacy-Feld adc_voltage_offset beim Speichern erkannt (%.3f V) -> adc_voltage_multiplier=%.4f",
                 legacy_offset, config_rtc.adc_voltage_multiplier);
    }
    
    if (doc["ntp_server"].is<const char*>()) {
        const char* ntp_server = doc["ntp_server"];
        if (strlen(ntp_server) > 0 && strlen(ntp_server) < sizeof(config_rtc.ntp_server)) {
            strncpy(config_rtc.ntp_server, ntp_server, sizeof(config_rtc.ntp_server) - 1);
            config_rtc.ntp_server[sizeof(config_rtc.ntp_server) - 1] = '\0';
        } else {
            ESP_LOGE(TAG, "FEHLER: NTP-Server ungültig (leer oder zu lang)");
            if (errorMessage != nullptr) {
                strncpy(errorMessage, "Fehler: NTP-Server ungültig (leer oder zu lang)", 255);
            }
            return false;
        }
    }

    if (doc["mqtt_host"].is<const char*>()) {
        const char* mqtt_host = doc["mqtt_host"];
        if (strlen(mqtt_host) < sizeof(config_rtc.mqtt_host)) {
            if (strlen(mqtt_host) == 0) {
                mqtt_host = MQTT_DUMMY_HOST;
            }
            strncpy(config_rtc.mqtt_host, mqtt_host, sizeof(config_rtc.mqtt_host) - 1);
            config_rtc.mqtt_host[sizeof(config_rtc.mqtt_host) - 1] = '\0';
        } else {
            ESP_LOGE(TAG, "FEHLER: MQTT Host zu lang");
            if (errorMessage != nullptr) {
                strncpy(errorMessage, "Fehler: MQTT Host zu lang", 255);
            }
            return false;
        }
    }

    if (doc["mqtt_port"].is<uint16_t>()) {
        uint16_t mqtt_port = doc["mqtt_port"].as<uint16_t>();
        if (mqtt_port >= 1) {
            config_rtc.mqtt_port = mqtt_port;
        } else {
            ESP_LOGE(TAG, "FEHLER: MQTT Port ungültig");
            if (errorMessage != nullptr) {
                strncpy(errorMessage, "Fehler: MQTT Port ungültig", 255);
            }
            return false;
        }
    }

    if (doc["mqtt_username"].is<const char*>()) {
        const char* mqtt_username = doc["mqtt_username"];
        if (strlen(mqtt_username) < sizeof(config_rtc.mqtt_username)) {
            strncpy(config_rtc.mqtt_username, mqtt_username, sizeof(config_rtc.mqtt_username) - 1);
            config_rtc.mqtt_username[sizeof(config_rtc.mqtt_username) - 1] = '\0';
        } else {
            ESP_LOGE(TAG, "FEHLER: MQTT Username zu lang");
            if (errorMessage != nullptr) {
                strncpy(errorMessage, "Fehler: MQTT Username zu lang", 255);
            }
            return false;
        }
    }

    if (doc["mqtt_password"].is<const char*>()) {
        const char* mqtt_password = doc["mqtt_password"];
        if (strlen(mqtt_password) < sizeof(config_rtc.mqtt_password)) {
            strncpy(config_rtc.mqtt_password, mqtt_password, sizeof(config_rtc.mqtt_password) - 1);
            config_rtc.mqtt_password[sizeof(config_rtc.mqtt_password) - 1] = '\0';
        } else {
            ESP_LOGE(TAG, "FEHLER: MQTT Passwort zu lang");
            if (errorMessage != nullptr) {
                strncpy(errorMessage, "Fehler: MQTT Passwort zu lang", 255);
            }
            return false;
        }
    }

    if (doc["mqtt_main_topic"].is<const char*>()) {
        const char* mqtt_main_topic = doc["mqtt_main_topic"];
        if (strlen(mqtt_main_topic) < sizeof(config_rtc.mqtt_main_topic)) {
            strncpy(config_rtc.mqtt_main_topic, mqtt_main_topic, sizeof(config_rtc.mqtt_main_topic) - 1);
            config_rtc.mqtt_main_topic[sizeof(config_rtc.mqtt_main_topic) - 1] = '\0';
        } else {
            ESP_LOGE(TAG, "FEHLER: MQTT Main Topic zu lang");
            if (errorMessage != nullptr) {
                strncpy(errorMessage, "Fehler: MQTT Main Topic zu lang", 255);
            }
            return false;
        }
    }

    config_rtc.mqtt_ha_autodiscovery = doc["mqtt_ha_autodiscovery"] | false;

    if (strcmp(config_rtc.transfer_mode, TRANSFER_MODE_MQTT) == 0) {
        if (strlen(config_rtc.mqtt_host) == 0) {
            strncpy(config_rtc.mqtt_host, MQTT_DUMMY_HOST, sizeof(config_rtc.mqtt_host) - 1);
            config_rtc.mqtt_host[sizeof(config_rtc.mqtt_host) - 1] = '\0';
        }
        if (strlen(config_rtc.mqtt_main_topic) == 0) {
            strncpy(config_rtc.mqtt_main_topic, config_rtc.hostname, sizeof(config_rtc.mqtt_main_topic) - 1);
            config_rtc.mqtt_main_topic[sizeof(config_rtc.mqtt_main_topic) - 1] = '\0';
        }
    }
    
    // WiFi-Credentials speichern (max. 2 Paare)
    config_rtc.wifi_count = 0;
    if (doc["wifiCredentials"].is<JsonArray>()) {
        JsonArray credentials = doc["wifiCredentials"].as<JsonArray>();
        uint8_t max_credentials = (credentials.size() > 2) ? 2 : credentials.size();
        
        for (uint8_t i = 0; i < max_credentials; i++) {
            if (credentials[i]["ssid"].is<const char*>() && credentials[i]["password"].is<const char*>()) {
                const char* ssid = credentials[i]["ssid"];
                const char* password = credentials[i]["password"];
                
                // Nur nicht-leere Sets speichern (mindestens SSID muss vorhanden sein)
                if (strlen(ssid) > 0) {
                    if (strlen(ssid) >= sizeof(config_rtc.wifi_credentials[i].ssid)) {
                        ESP_LOGE(TAG, "FEHLER: WiFi SSID zu lang (max. %d Zeichen)", sizeof(config_rtc.wifi_credentials[i].ssid) - 1);
                        if (errorMessage != nullptr) {
                            strncpy(errorMessage, "Fehler: WiFi SSID zu lang (max. 31 Zeichen)", 255);
                        }
                        return false;
                    }
                    if (strlen(password) >= sizeof(config_rtc.wifi_credentials[i].password)) {
                        ESP_LOGE(TAG, "FEHLER: WiFi Passwort zu lang (max. %d Zeichen)", sizeof(config_rtc.wifi_credentials[i].password) - 1);
                        if (errorMessage != nullptr) {
                            strncpy(errorMessage, "Fehler: WiFi Passwort zu lang (max. 63 Zeichen)", 255);
                        }
                        return false;
                    }
                    
                    strncpy(config_rtc.wifi_credentials[i].ssid, ssid, sizeof(config_rtc.wifi_credentials[i].ssid) - 1);
                    config_rtc.wifi_credentials[i].ssid[sizeof(config_rtc.wifi_credentials[i].ssid) - 1] = '\0';
                    
                    strncpy(config_rtc.wifi_credentials[i].password, password, sizeof(config_rtc.wifi_credentials[i].password) - 1);
                    config_rtc.wifi_credentials[i].password[sizeof(config_rtc.wifi_credentials[i].password) - 1] = '\0';
                    
                    config_rtc.wifi_count++;
                }
            }
        }
    }
    
    // Validierung: Mindestens ein WiFi-Set muss vorhanden sein
    if (config_rtc.wifi_count == 0) {
        ESP_LOGE(TAG, "FEHLER: Mindestens ein WiFi-Set (SSID) muss angegeben werden");
        if (errorMessage != nullptr) {
            strncpy(errorMessage, "Fehler: Mindestens ein WiFi-Set (SSID) muss angegeben werden", 255);
        }
        return false;
    }
    
    // Config in config.json speichern
    // WICHTIG: Wir müssen ein neues JSON-Dokument erstellen, da das eingehende doc
    // möglicherweise nicht alle Felder enthält (z.B. wenn nur WiFi-Credentials geändert wurden)
    FILE* configFile = fopen("/littlefs/config.json", "w");
    if (!configFile) {
        ESP_LOGE(TAG, "Fehler: config.json konnte nicht zum Schreiben geöffnet werden");
        if (errorMessage != nullptr) {
            strncpy(errorMessage, "Fehler: config.json konnte nicht zum Schreiben geöffnet werden", 255);
        }
        return false;
    }
    
    // Neues JSON-Dokument erstellen mit allen Werten
    JsonDocument newDoc;
    newDoc["hostname"] = config_rtc.hostname;
    newDoc["adminpass"] = config_rtc.adminpass;
    newDoc["wakeup_minutes"] = config_rtc.wakeup_minutes;
    // Multiplikator berechnen und speichern
    // Wenn transfer_minutes == 255, dann ist Multiplikator = 0 (nie)
    uint8_t multiplier;
    if (config_rtc.transfer_minutes == 255) {
        multiplier = 0;  // Nie
    } else if (config_rtc.wakeup_minutes > 0) {
        multiplier = config_rtc.transfer_minutes / config_rtc.wakeup_minutes;
    } else {
        multiplier = DEFAULT_TRANSFER_INTERVAL_X;
    }
    newDoc["transfer_interval_x"] = multiplier;
    newDoc["transfer_mode"] = config_rtc.transfer_mode;
    newDoc["wifi_tx_power_dbm"] = (int)config_rtc.wifi_tx_power_dbm;
    newDoc["ble_tx_power_dbm"] = (int)config_rtc.ble_tx_power_dbm;
    newDoc["zigbee_tx_power_dbm"] = (int)config_rtc.zigbee_tx_power_dbm;
    newDoc["adc_voltage_multiplier"] = config_rtc.adc_voltage_multiplier;
    newDoc["ntp_server"] = config_rtc.ntp_server;
    newDoc["mqtt_host"] = config_rtc.mqtt_host;
    newDoc["mqtt_port"] = config_rtc.mqtt_port;
    newDoc["mqtt_username"] = config_rtc.mqtt_username;
    newDoc["mqtt_password"] = config_rtc.mqtt_password;
    newDoc["mqtt_main_topic"] = config_rtc.mqtt_main_topic;
    newDoc["mqtt_ha_autodiscovery"] = config_rtc.mqtt_ha_autodiscovery;
    
    // WiFi-Credentials als Array
    JsonArray wifiArray = newDoc["wifiCredentials"].to<JsonArray>();
    for (uint8_t i = 0; i < config_rtc.wifi_count; i++) {
        JsonObject cred = wifiArray.add<JsonObject>();
        cred["ssid"] = config_rtc.wifi_credentials[i].ssid;
        cred["password"] = config_rtc.wifi_credentials[i].password;
    }
    
    // JSON schreiben (mit Formatierung für bessere Lesbarkeit)
    // ArduinoJson serializeJsonPretty funktioniert nicht direkt mit FILE*, daher Buffer verwenden
    char json_buffer[2048];
    size_t json_len = serializeJsonPretty(newDoc, json_buffer, sizeof(json_buffer));
    if (json_len > 0) {
        fwrite(json_buffer, 1, json_len, configFile);
    }
    fclose(configFile);
    
    config_rtc.config_loaded = true;
    
    // Prüfen, ob WiFi-Credentials geändert wurden
    if (wifi_credentials_changed != nullptr) {
        bool changed = false;
        
        // Anzahl geändert?
        if (old_wifi.count != config_rtc.wifi_count) {
            changed = true;
        } else {
            // Einzelne Credentials vergleichen
            for (uint8_t i = 0; i < config_rtc.wifi_count && i < 2; i++) {
                if (strcmp(old_wifi.ssid[i], config_rtc.wifi_credentials[i].ssid) != 0 ||
                    strcmp(old_wifi.password[i], config_rtc.wifi_credentials[i].password) != 0) {
                    changed = true;
                    break;
                }
            }
        }
        
        *wifi_credentials_changed = changed;
        
        if (changed) {
            ESP_LOGI(TAG, "WiFi-Credentials wurden geändert");
        }
    }

    ESP_LOGI(TAG, "MQTT Config gespeichert: host=%s port=%u user=%s password=%s topic=%s ha_auto=%s",
             config_rtc.mqtt_host,
             (unsigned int)config_rtc.mqtt_port,
             config_rtc.mqtt_username,
             (strlen(config_rtc.mqtt_password) > 0 ? "***" : "(leer)"),
             config_rtc.mqtt_main_topic,
             config_rtc.mqtt_ha_autodiscovery ? "true" : "false");
    
    ESP_LOGI(TAG, "Config erfolgreich gespeichert (RTC-RAM und config.json)");
    return true;
}

// Statische Variable für mDNS-Initialisierung
static bool mdns_initialized = false;

// ============================================
// NTP-Zeitsynchronisation (ESP-IDF)
// ============================================
// Callback für Zeit-Synchronisation
static void time_sync_notification_cb(struct timeval *tv) {
    ESP_LOGI(TAG, "Zeit synchronisiert");
}

bool sync_ntp_time() {
    if (!wifi_is_connected()) {
        ESP_LOGE(TAG, "NTP-Sync: WiFi nicht verbunden");
        return false;
    }
    
    ESP_LOGI(TAG, "NTP-Sync: Verbinde mit %s...", config_rtc.ntp_server);
    
    // Zeitzone explizit auf UTC setzen (für Datenlogger wichtig - keine Sommer/Winterzeit-Sprünge!)
    setenv("TZ", "UTC", 1);
    tzset();
    
    // NTP-Konfiguration (ESP-IDF SNTP)
    sntp_setoperatingmode(SNTP_OPMODE_POLL);
    sntp_setservername(0, config_rtc.ntp_server);
    sntp_init();
    
    // Warte auf Zeit-Synchronisation
    struct tm timeinfo;
    uint64_t start_time_us = esp_timer_get_time();
    uint64_t timeout_us = NTP_TIMEOUT_MS * 1000ULL;
    
    time_t now;
    bool synced = false;
    while ((esp_timer_get_time() - start_time_us) < timeout_us) {
        time(&now);
        if (localtime_r(&now, &timeinfo) && timeinfo.tm_year > (2016 - 1900)) {
            // Zeit ist synchronisiert (tm_year > 2016 bedeutet, dass Zeit gesetzt wurde)
            synced = true;
            break;
        }
        vTaskDelay(pdMS_TO_TICKS(100));
    }
    
    if (synced) {
        time_sync_set_hard(now, "NTP");
        ESP_LOGI(TAG, "NTP-Sync erfolgreich (UTC): %04d-%02d-%02d %02d:%02d:%02d UTC",
                 timeinfo.tm_year + 1900, timeinfo.tm_mon + 1, timeinfo.tm_mday,
                 timeinfo.tm_hour, timeinfo.tm_min, timeinfo.tm_sec);
        int64_t sec_since = time_sync_seconds_since_last();
        if (sec_since >= 0) {
            ESP_LOGI(TAG, "  Letzte Sync: vor %lld Sekunden", (long long)sec_since);
        }
        return true;
    } else {
        ESP_LOGE(TAG, "NTP-Sync fehlgeschlagen (Timeout)");
        return false;
    }
}
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
extern "C" void app_main(void) {
    // Logging initialisieren (automatisch in ESP-IDF)
    esp_log_level_set("*", ESP_LOG_INFO);
    esp_log_level_set(TAG, ESP_LOG_DEBUG);
    // Captive/Browser brechen viele HTTP-Verbindungen ab → harmlose WARN-Spam unterdrücken
    esp_log_level_set("httpd_txrx", ESP_LOG_ERROR);
    // WiFi-Debug-Nachrichten reduzieren (muss ganz am Anfang stehen)
    SET_WIFI_LOG_LEVEL();
#ifdef GOM_ZIGBEE_DEBUG_LOG
    esp_log_level_set("transfer_zigbee", ESP_LOG_DEBUG);
    esp_log_level_set("transfer", ESP_LOG_DEBUG);
    ESP_LOGW(TAG, "ZigBee-Debug-Log aktiv (GOM_ZIGBEE_DEBUG_LOG)");
#endif

    const esp_sleep_wakeup_cause_t wakeup_reason = esp_sleep_get_wakeup_cause();
    if (wake_needs_serial_monitor_delay(wakeup_reason)) {
        vTaskDelay(pdMS_TO_TICKS(1000));  // Serial-Monitor nach Flash/Reboot/Taster
    }

    // Antennenumschaltung initialisieren (interne Antenne als Standard)
    INIT_ANTENNA_SWITCH(ANTENNA_INTERNAL);

    INIT_VBUS_DETECT_GPIO();
    ESP_LOGI(TAG, "Platinenversion: %d", BOARD_VERSION_ID);
    
    // Taster A (BUTTON_A_GPIO) für Wake-up konfigurieren (INPUT_PULLUP, active-low)
    gpio_config_t io_conf = {};
    io_conf.pin_bit_mask = (1ULL << BUTTON_A_GPIO);
    io_conf.mode = GPIO_MODE_INPUT;
    io_conf.pull_up_en = GPIO_PULLUP_ENABLE;
    io_conf.pull_down_en = GPIO_PULLDOWN_DISABLE;
    io_conf.intr_type = GPIO_INTR_DISABLE;
    gpio_config(&io_conf);

    // Power-On vs. Wake-up erkennen (wakeup_reason bereits oben gelesen)
    isPowerOn = (wakeup_reason == ESP_SLEEP_WAKEUP_UNDEFINED);

    // RTC-RAM ist nach Power-On, Flash oder Reboot nicht als gültig anzusehen.
    // Gleiche Startwerte veranlassen den Watchdog-Task, den LP-Core zu starten.
    if (isPowerOn) {
        *(volatile uint32_t *)&ulp_lp_core_running = 0;
        last_lp_core_running = 0;
    }
    
    // Wake-up Count nur bei Deep-Sleep-Wake-up erhöhen (nicht bei ESP.restart())
    if (!isPowerOn) {
        ++wakeupCount;
    }
    
    // Wake-up-Informationen ausgeben (kombiniert)
    ESP_LOGI(TAG, "\n=== Gas-O-Meter ===");
    ESP_LOGI(TAG, "Wake-up Count: %d", wakeupCount);
    
    // WICHTIG: ADC-Messung bei JEDEM Wake-up durchführen (Power-On oder Timer/EXT1-Wake-up)
    // Diese Messung ist die Basis für alle weiteren Entscheidungen (Akku-Schutz, Übertragung, etc.)
    ESP_LOGI(TAG, "Führe ADC-Messung durch (bei jedem Wake-up)...");
    esp_err_t adc_ret = init_adc();
    if (adc_ret != ESP_OK) {
        ESP_LOGE(TAG, "ADC Fehler: %s", esp_err_to_name(adc_ret));
        // Bei ADC-Fehler: Versuche trotzdem fortzufahren (kritisch, aber nicht fatal)
        battery_voltage = 0.0f;
        battery_percent = 0;
    } else {
        // Akku-Messung durchführen
        // HINWEIS: config_rtc.adc_voltage_multiplier ist IMMER gesetzt (entweder durch Initialisierung mit ADC_VOLTAGE_MULTIPLIER
        //          oder durch load_config() aus config.json). Daher können wir es direkt verwenden.
        battery_adc_mv = read_adc_median_mv();
        battery_voltage = (float)battery_adc_mv / 1000.0f * VOLTAGE_DIVIDER_RATIO * config_rtc.adc_voltage_multiplier;
        battery_percent = VOLTAGE_TO_PERCENT(battery_voltage);
        
        ESP_LOGI(TAG, "ADC-Messung: %d mV → Spannung: %.2f V, Prozent: %d%%", 
                 battery_adc_mv, battery_voltage, battery_percent);
        
        // Akku-Schutz-Prüfung: Bei zu niedriger Spannung sofort Deep-Sleep (ohne Übertragung)
        // WICHTIG: Diese Prüfung erfolgt BEVOR Config geladen wird, um Akku zu schützen!
        bool is_usb_power = IS_USB_POWER(battery_voltage);
        
        if (!is_usb_power && battery_voltage < BATTERY_VOLTAGE_20) {
            // Akku-Betrieb und Spannung < 20%: Sofort Deep-Sleep zum Akku-Schutz
            ESP_LOGW(TAG, "Akku zu niedrig - Sofort Deep-Sleep zum Akku-Schutz (ohne Übertragung)");
            ESP_LOGW(TAG, "Spannung: %.2f V (Minimum: %.2f V)", battery_voltage, BATTERY_VOLTAGE_20);
            
            // Vor Deep-Sleep: ulp_pulse_counter in Ring-Speicher schreiben (bei Akku-Low kann RTC-RAM verloren gehen)
            // WICHTIG: NVS muss vorher initialisiert werden!
            init_nvs_partitions(isPowerOn);
            init_ring_buffer_and_ulp_pulse_counter(isPowerOn);

            // Dieser Schnellpfad liegt vor dem Watchdog-Task. Deshalb den
            // Cross-Wake-Check einmal synchron ausführen, damit der LP-Core
            // auch nach Power-On/Reboot mit schwachem Akku Impulse zählt.
            const uint32_t current_lp_core_running =
                *(volatile uint32_t *)&ulp_lp_core_running;
            if (current_lp_core_running - last_lp_core_running) {
                last_lp_core_running = current_lp_core_running;
            } else {
                ESP_LOGW(TAG, "Akku-Schnellpfad: LP-Core ohne Fortschritt");
                restart_lp_core_with_retries(current_lp_core_running);
                last_lp_core_running =
                    *(volatile uint32_t *)&ulp_lp_core_running;
            }

            ESP_LOGI(TAG, "Speichere ulp_pulse_counter in Ring-Speicher vor Deep-Sleep (Akku-Low)...");
            write_ulp_pulse_counter_to_ring_buffer();
            
            // Deep-Sleep mit EXT1-Wake-up (Taster A) - Timer deaktiviert bei kritischer Spannung
            bool enable_timer = (battery_voltage > BATTERY_VOLTAGE_PROTECTION);
            enter_deep_sleep_with_gpio_and_timer_wakeup(enable_timer);
            // Ab hier wird Code nicht mehr ausgeführt (Deep-Sleep)
            return;
        }
    }
    
    switch (wakeup_reason) {
        case ESP_SLEEP_WAKEUP_UNDEFINED:
            ESP_LOGI(TAG, "=== EVENT: Power-On ===");
            break;
        case ESP_SLEEP_WAKEUP_GPIO:
            ESP_LOGI(TAG, "=== EVENT: Wake-up durch GPIO (Legacy/sonstige Quelle) ===");
            break;
        case ESP_SLEEP_WAKEUP_TIMER:
            ESP_LOGI(TAG, "=== EVENT: Wake-up durch Timer (Cron-Intervall) ===");
            break;
        case ESP_SLEEP_WAKEUP_EXT1:
            ESP_LOGI(TAG, "=== EVENT: Wake-up durch EXT1 (Taster A) ===");
            break;
        case ESP_SLEEP_WAKEUP_EXT0:
            ESP_LOGI(TAG, "=== EVENT: Wake-up durch EXT0 (Legacy/sonstige Quelle) ===");
            break;
        case ESP_SLEEP_WAKEUP_TOUCHPAD:
            ESP_LOGI(TAG, "=== EVENT: Wake-up durch Touchpad ===");
            break;
        case ESP_SLEEP_WAKEUP_ULP:
            ESP_LOGI(TAG, "=== EVENT: Wake-up durch ULP ===");
            break;
        default:
            ESP_LOGI(TAG, "=== EVENT: Wake-up durch Unbekannt (0x%x) ===", wakeup_reason);
            break;
    }
    
    // Interne LED initialisieren und sofort einschalten (HP-Core läuft)
    // WICHTIG: LED wird hier eingeschaltet, um zu zeigen, dass HP-Core aktiv ist
    io_conf.pin_bit_mask = (1ULL << LED_BUILTIN_GPIO);
    io_conf.mode = GPIO_MODE_OUTPUT;
    io_conf.pull_up_en = GPIO_PULLUP_DISABLE;
    io_conf.pull_down_en = GPIO_PULLDOWN_DISABLE;
    io_conf.intr_type = GPIO_INTR_DISABLE;
    gpio_config(&io_conf);
    gpio_set_level((gpio_num_t)LED_BUILTIN_GPIO, LED_ON);  // LED EIN (HP-Core aktiv)
    ESP_LOGI(TAG, "LED initialisiert (GPIO%d)", LED_BUILTIN_GPIO);
    
    // Stromversorgungs-Prüfung (basierend auf bereits durchgeführter ADC-Messung)
    // WICHTIG: Bei USB-Stromversorgung kann Timer aktiv bleiben (keine Akku-Probleme)
    bool is_usb_power = IS_USB_POWER(battery_voltage);
    bool enable_timer_wakeup = true;  // Standard: Timer aktiviert
    
    LOG_POWER_SUPPLY_MODE(TAG, battery_voltage, is_usb_power);
    if (is_usb_power) {
        // USB-Stromversorgung: Timer kann aktiv bleiben (keine Akku-Probleme)
        ESP_LOGI(TAG, "Betrieb fortgesetzt");
        // enable_timer_wakeup bleibt true
    } else {
        // Akku-Betrieb: Timer-Wake-up deaktivieren bei kritischer Spannung
        // WICHTIG: Bei Spannung <= BATTERY_VOLTAGE_PROTECTION macht automatisches Wake-up nur mehr Schaden
        // Nur noch manueller Wake-up über Taster möglich
        if (battery_voltage <= BATTERY_VOLTAGE_PROTECTION) {
            enable_timer_wakeup = false;
            ESP_LOGW(TAG, "Akku-Spannung kritisch (<= BATTERY_VOLTAGE_PROTECTION)");
            ESP_LOGW(TAG, "Timer-Wake-up wird DEAKTIVIERT - nur manueller Wake-up über Taster A möglich");
            ESP_LOGW(TAG, "Spannung: %.2f V (Schutz-Schwelle: %.2f V)", 
                     battery_voltage, BATTERY_VOLTAGE_PROTECTION);
        }
    }
    
    // NVS initialisieren (bei Power-On und Deep-Sleep-Wake-up)
        // WICHTIG: nvs_flash_init() ist idempotent - wenn bereits initialisiert, passiert nichts (keine Wear!)
        init_nvs_partitions(isPowerOn);
            
            // NVS-Ring-Speicher: Versionsnummer prüfen und ggf. initialisieren
            // Dies geschieht NUR beim ersten Boot nach Code-Upload oder partition.csv-Änderung
        if (isPowerOn) {
            ESP_LOGI(TAG, "Prüfe NVS-Ring-Speicher-Version...");
            ESP_LOGI(TAG, "Erwartete Version (Build-Timestamp): %lu", RING_BUFFER_VERSION);
            check_and_init_pulse_ring_nvs();
        }

        // Zählerstand aus NVS/RTC laden, BEVOR der LP-Core (asynchron) gestartet wird.
        // Sonst kann ulp_lp_core_load_binary() den Wert auf 0 zurücksetzen.
        init_ring_buffer_and_ulp_pulse_counter(isPowerOn);

        // LP-Core Watchdog Task starten (asynchron)
        const BaseType_t watchdog_task_result = xTaskCreate(
            lp_core_watchdog_task,      // Task-Funktion
            "LP_Core_Watchdog",          // Task-Name
            4096,                        // Stack-Größe (Bytes)
            NULL,                        // Parameter
            1,                           // Priorität (niedrig, da nicht kritisch)
            NULL                         // Task-Handle (nicht benötigt)
        );
        if (watchdog_task_result == pdPASS) {
            ESP_LOGI(TAG, "LP-Core Watchdog Task angelegt");
        } else {
            ESP_LOGE(TAG, "FEHLER: LP-Core Watchdog Task konnte nicht angelegt werden");
        }
        
        // 1. Batteriespannung-Test und ggf. in Ring-Speicher schreiben
        // < 30%: Schreibe in Ring-Speicher (RTC-RAM könnte verloren gehen; deckt auch reinen USB ab)
        // >= 30%: Kein Schreiben (RTC-RAM bleibt erhalten; auch bei USB/VBUS)
        if (battery_voltage < BATTERY_VOLTAGE_30) {
            ESP_LOGI(TAG, "Speichere ulp_pulse_counter in Ring-Speicher (< 30%%)...");
            write_ulp_pulse_counter_to_ring_buffer();
        }
        
        // 2. Config laden (idempotent: prüft intern, ob bereits geladen)
        // WICHTIG: Muss vor allen Aktionen geladen sein, da beide Stränge (Timer/Power-On/GPIO) Config benötigen
        bool config_available = load_config();
        
        // 2.1 Battery-Spannung neu berechnen (mit korrektem adc_voltage_multiplier aus Config)
        // WICHTIG: Bei Power-On wurde battery_voltage VOR load_config() mit dem DEFAULT-Offset berechnet.
        //          Jetzt ist der korrekte Offset aus config.json geladen → Neuberechnung nötig!
        //          Bei Deep-Sleep-Wake-Up ist der RTC-Wert bereits korrekt, aber Neuberechnung schadet nicht.
        if (config_available && battery_adc_mv > 0) {
            battery_voltage = (float)battery_adc_mv / 1000.0f * VOLTAGE_DIVIDER_RATIO * config_rtc.adc_voltage_multiplier;
            battery_percent = VOLTAGE_TO_PERCENT(battery_voltage);
            ESP_LOGD(TAG, "Battery-Spannung neu berechnet (mit Config-Offset): %.2f V, %d%%", battery_voltage, battery_percent);
        }
        
        // 2a. ZigBee-Config initialisieren (lädt aus NVS bei Power-On, verwendet RTC-RAM bei Deep-Sleep-Wake-up)
        if (config_available && strcmp(config_rtc.transfer_mode, TRANSFER_MODE_ZIGBEE) == 0) {
            if (!zigbee_config_init(isPowerOn)) {
                ESP_LOGW(TAG, "ZigBee-Config-Initialisierung fehlgeschlagen");
            }
        }
        
        // 2b. Transfer-Modus initialisieren (einmalig beim Start)
        if (config_available) {
            if (!transfer_init(config_rtc.transfer_mode)) {
                ESP_LOGW(TAG, "Transfer-Initialisierung fehlgeschlagen (Mode: %s)", config_rtc.transfer_mode);
            }
        }
        
        // 3. Abhängig vom Wake-up-Grund: Unterschiedliche Aktionen
        const bool web_ui_wake = wake_allows_web_ui(wakeup_reason);
        switch (wakeup_reason) {
            case ESP_SLEEP_WAKEUP_TIMER: {
                // Timer-Wake-up: Übertragung alle N Timer-Wake-ups (transfer_minutes / wakeup_minutes)
                timer_wake_count++;
                if (timer_wake_should_transfer(config_available)) {
                    const uint8_t every_n = (uint8_t)(config_rtc.transfer_minutes / config_rtc.wakeup_minutes);
                    ESP_LOGI(TAG,
                             "=== Timer-Wake-up: Datenübertragung (Zähler %lu, alle %u Wake-ups, %u Min) ===",
                             (unsigned long)timer_wake_count, (unsigned)every_n,
                             (unsigned)config_rtc.transfer_minutes);
                    
                    // Transfer-Daten vorbereiten (ADC-Messung wurde bereits beim Wake-up durchgeführt)
                    // HINWEIS: battery_voltage und battery_percent wurden bereits beim Wake-up gemessen
                    //          und sind daher aktuell - keine erneute Messung nötig!
                    transfer_data_t data_to_transfer = {
                        .pulse_counter = *(volatile uint32_t *)&ulp_pulse_counter,
                        .battery_percent = (float)battery_percent,  // Bereits beim Wake-up gemessen
                        .battery_voltage = battery_voltage,  // Bereits beim Wake-up gemessen
                        .firmware_version = PROJECT_VERSION
                    };
                    
                    // Datenübertragung durchführen
                    transfer_status_t transfer_status = transfer_data(&data_to_transfer);
                    
                    if (transfer_status == TRANSFER_STATUS_OK) {
                        ESP_LOGI(TAG, "Datenübertragung erfolgreich abgeschlossen");
                    } else {
                        ESP_LOGW(TAG, "Datenübertragung fehlgeschlagen: %s (Status: %d)", 
                                transfer_status_to_string(transfer_status), transfer_status);
                    }
                    
                } else {
                    ESP_LOGI(TAG,
                             "=== Timer-Wake-up: Keine Übertragung (Zähler %lu, Intervall %u Min) ===",
                             (unsigned long)timer_wake_count, (unsigned)config_rtc.transfer_minutes);
                }
                ESP_LOGI(TAG, "Timer-Wake-up: Deep-Sleep (kein Web-Frontend)");
                enter_deep_sleep_after_wakeup(enable_timer_wakeup);
                break;
            }

            case ESP_SLEEP_WAKEUP_GPIO:
            case ESP_SLEEP_WAKEUP_EXT0:
            case ESP_SLEEP_WAKEUP_EXT1:
            case ESP_SLEEP_WAKEUP_UNDEFINED:
                // Taster oder Power-On: WiFi und Web-Server
                if (config_available) {
            ESP_LOGI(TAG, "Config erfolgreich geladen");
            
            // WiFi verbinden
            if (wifi_connect_sta()) {
                        // mDNS initialisieren (nur einmal, nach erfolgreicher WiFi-Verbindung mit IP)
                        // ESP-IDF Best Practice: mDNS nach IP-Adresszuweisung initialisieren
                        if (!mdns_initialized) {
                            esp_err_t mdns_ret = mdns_init();
                            if (mdns_ret == ESP_OK) {
                                // Hostname und Instance Name setzen (vor Service-Add)
                                mdns_hostname_set(config_rtc.hostname);
                                mdns_instance_name_set("Gas-O-Meter");
                                
                                // HTTP-Service hinzufügen
                                mdns_ret = mdns_service_add(NULL, "_http", "_tcp", 80, NULL, 0);
                                if (mdns_ret == ESP_OK) {
                                    mdns_initialized = true;
                                    ESP_LOGI(TAG, "mDNS initialisiert: http://%s.local", config_rtc.hostname);
                                } else {
                                    ESP_LOGE(TAG, "mDNS: Fehler beim Hinzufügen des HTTP-Services: %s", esp_err_to_name(mdns_ret));
                                }
                            } else {
                                // ESP_ERR_INVALID_STATE bedeutet, dass mDNS bereits initialisiert wurde
                                if (mdns_ret == ESP_ERR_INVALID_STATE) {
                                    mdns_initialized = true;
                                    ESP_LOGW(TAG, "mDNS bereits initialisiert");
                                } else {
                                    ESP_LOGE(TAG, "mDNS-Initialisierung fehlgeschlagen: %s", esp_err_to_name(mdns_ret));
                                }
                            }
                        } else {
                            // mDNS bereits initialisiert - nur Hostname aktualisieren (falls geändert)
                            mdns_hostname_set(config_rtc.hostname);
                            ESP_LOGI(TAG, "mDNS: http://%s.local (bereits initialisiert)", config_rtc.hostname);
                        }
                        
                // NTP-Zeitsynchronisation
                sync_ntp_time();
                
                // Web-Server starten
                setupWebServer(false);
                        char ip_str[16];
                        snprintf(ip_str, sizeof(ip_str), IPSTR, IP2STR(&wifi_get_ip_info()->ip));
                        ESP_LOGI(TAG, "Web-Server: http://%s", ip_str);
                    } else {
                        ESP_LOGE(TAG, "WiFi-Verbindung fehlgeschlagen → Starte Access Point");
                        wifi_manager_session_end();

                        /* AP zuerst: httpd nach laufendem AP starten (sonst TCP-Timeout trotz DNS). */
                        if (wifi_start_access_point()) {
                            setupWebServer(true);
                            ESP_LOGI(TAG, "Web-Server (AP-Modus): http://%d.%d.%d.%d",
                                     AP_IP_ADDRESS_1, AP_IP_ADDRESS_2, AP_IP_ADDRESS_3, AP_IP_ADDRESS_4);
            } else {
                            ESP_LOGE(TAG, "FEHLER: Weder WiFi-Verbindung noch Access Point möglich");
                        }
            }
        } else {
                    ESP_LOGE(TAG, "Config-Laden fehlgeschlagen → WiFi/Web-Server nicht gestartet");
        }
                break;

            default:
                ESP_LOGW(TAG, "Wake-up 0x%x ohne Web-UI → Deep-Sleep", (unsigned)wakeup_reason);
                enter_deep_sleep_after_wakeup(enable_timer_wakeup);
                break;
        }

        if (web_ui_wake) {
            xTaskCreate(
                web_timeout_task,
                "web_timeout",
                4096,
                NULL,
                1,
                NULL);
        }
}

// ============================================
// FreeRTOS Task: Web-Server Timeout und Deep-Sleep Management
// ============================================
void web_timeout_task(void *parameter) {
    const TickType_t check_interval = pdMS_TO_TICKS(1000);  // 1 Sekunde
    const uint64_t sleep_threshold_us = WIFI_WAIT_FOR_SLEEP * 60 * 1000000ULL;  // Minuten in Mikrosekunden
    const uint64_t recent_activity_threshold_us = 30 * 1000000ULL;  // 30 Sekunden in Mikrosekunden
    
    ESP_LOGI(TAG, "Web-Timeout Task gestartet");
    
    while (1) {
        // Reboot-Prüfung
        if (reboot_requested) {
            ESP_LOGI(TAG, "Reboot angefordert: %s", reboot_reason ? reboot_reason : "Unbekannt");
            vTaskDelay(pdMS_TO_TICKS(500));  // Warte auf Antwort-Übertragung
            perform_reboot(reboot_reason ? reboot_reason : "Reboot angefordert");
            // Sollte nie hier ankommen
        }
        
        // Web-Timeout-Prüfung
        if (server_started) {
            uint64_t current_time_us = esp_timer_get_time();
            uint64_t inactivity_us = current_time_us - last_web_activity_us;
            bool recent_activity = (inactivity_us < recent_activity_threshold_us);
            
            if (inactivity_us >= sleep_threshold_us && !should_enter_deep_sleep && !recent_activity) {
                ESP_LOGI(TAG, "Keine Web-Server-Aktivität seit %d Minuten → Deep-Sleep", WIFI_WAIT_FOR_SLEEP);
                should_enter_deep_sleep = true;
                deep_sleep_reason = "Web-Server-Inaktivität";
            } else if (recent_activity && inactivity_us >= sleep_threshold_us) {
                // Aktivität war sehr aktuell, aber Timeout erreicht → warte noch etwas
                ESP_LOGI(TAG, "Aktive Verbindung erkannt (letzte Aktivität vor %llu ms) → Deep-Sleep verzögert", 
                         inactivity_us / 1000);
            }
        }
        
        // Deep-Sleep-Prüfung (wie in loop())
        if (should_enter_deep_sleep) {
            ESP_LOGI(TAG, "%s", deep_sleep_reason);
            bool is_usb_power = IS_USB_POWER(battery_voltage);
            bool enable_timer = is_usb_power || (battery_voltage > BATTERY_VOLTAGE_PROTECTION);
            enter_deep_sleep_after_wakeup(enable_timer);
            
            // Wenn wir hier ankommen, wurde Deep-Sleep nicht gestartet (z.B. keine Wake-up-Quelle)
            // Flag zurücksetzen, um Endlosschleife zu vermeiden
            should_enter_deep_sleep = false;
            ESP_LOGW(TAG, "Deep-Sleep konnte nicht gestartet werden - System bleibt aktiv");
        }
        vTaskDelay(check_interval);
    }
}
