sneumeister/Gas-o-Meter2/include/transfer_zigbee.h

#ifndef TRANSFER_ZIGBEE_H
#define TRANSFER_ZIGBEE_H

#include "transfer.h"
#include <stddef.h>

// ============================================
// ZigBee-spezifische Funktionen
// ============================================

/**
 * @brief Schreibt Gas/Battery in persistente Cluster-RAM-Variablen (vor esp_zb_device_register).
 *
 * Attribute zeigen auf diese Variablen – muss vor transfer_zigbee_init() aufgerufen werden,
 * damit create_gas_meter_endpoint() und Z2M-Reads nach Join keine Defaults (0 / 4,0 V) sehen.
 *
 * @param data Messwerte (pulse_counter, battery_percent, battery_voltage); NULL = keine Aenderung
 */
void transfer_zigbee_prepare_cluster_attrs(const transfer_data_t* data);

/**
 * @brief Initialisiert den ZigBee-Stack
 * 
 * @return true bei Erfolg, false bei Fehler
 */
bool transfer_zigbee_init(void);

/**
 * @brief Führt die ZigBee-Datenübertragung durch
 * 
 * @param data Zu übertragende Daten
 * @return transfer_status_t Status-Code
 */
transfer_status_t transfer_zigbee_send_data(const transfer_data_t* data);

/**
 * @brief Synchronisiert die Zeit vom ZigBee-Coordinator
 * 
 * @return true bei Erfolg, false bei Fehler
 */
bool transfer_zigbee_sync_time(void);

/**
 * @brief Wartet auf ESP_ZB_COMMON_SIGNAL_CAN_SLEEP (Main-Loop laeuft weiter).
 *
 * Vor transfer_zigbee_deinit() / WiFi-Stop aufrufen, damit der Stack idle ist.
 *
 * @param timeout_ms Maximale Wartezeit
 * @return true wenn CAN_SLEEP empfangen, false bei Timeout oder Stack nicht aktiv
 */
bool transfer_zigbee_wait_can_sleep(uint32_t timeout_ms);

/**
 * @brief Stoppt ZigBee Main Loop (kein esp_zb_deinit; vollstaendiger Reset per Reboot).
 */
void transfer_zigbee_deinit(void);

/**
 * @brief Schreibt zigbee_rtc aus dem laufenden Stack in NVS (wenn zigbee_nvs_save_pending).
 *
 * Synchroner NVS-Flush (Deinit/Reboot). /zigbee/status liest nur zigbee_rtc (kein Stack).
 * Reboot/Deep-Sleep: kein Extra-Aufruf noetig (shutdown_resources -> deinit).
 */
void transfer_zigbee_persist_config_to_nvs(void);

/**
 * @brief ZigBee-Status für Web (/zigbee/status): nur zigbee_rtc + Pairing-Flags, kein esp_zb_lock.
 *
 * joined = gültige zigbee_rtc-Config; pairing = Join läuft; sonst factory-new.
 */
bool transfer_zigbee_get_status_json(char* buffer, size_t buffer_size);

/** Gültige ZigBee-Config in RTC (joined + gültige network_addr), ohne Stack-Zugriff. */
bool transfer_zigbee_rtc_config_valid(void);

/**
 * @brief Führt einen Factory-Reset durch (löscht alle ZigBee-Daten)
 * 
 * @param transfer_mode Aktueller Transfer-Modus (um zu prüfen, ob ZigBee aktiv ist)
 * @return true bei Erfolg, false bei Fehler
 */
bool transfer_zigbee_factory_reset(const char* transfer_mode);

/**
 * @brief true während Web-Pairing/Transfer oder ensure_joined-Pairing-Schleife (noch nicht joined).
 */
bool transfer_zigbee_is_pairing_active(void);

/** Status „Pairing läuft“ in /zigbee/status (Web-UI, bis Join oder Task-Ende). */
void transfer_zigbee_mark_web_pairing_requested(void);
void transfer_zigbee_clear_web_pairing_requested(void);

/** true waehrend zigbee_web_transfer_task (kuerzeres Interview-Fenster, Status transfer_busy). */
void transfer_zigbee_set_web_transfer_busy(bool busy);
bool transfer_zigbee_is_web_transfer_busy(void);

/**
 * @brief Prüft, ob ein Factory-Reset gerade läuft
 * 
 * @return true wenn Factory-Reset läuft, false sonst
 */
bool transfer_zigbee_is_factory_reset_in_progress(void);

/**
 * @brief Stellt sicher, dass das Device mit dem ZigBee-Netzwerk verbunden ist
 * 
 * Prüft den aktuellen Status (factory-new, joined) und startet bei Bedarf
 * Pairing oder Rejoin. Wartet auf erfolgreichen Abschluss mit Timeouts.
 * 
 * @return transfer_status_t TRANSFER_STATUS_OK wenn verbunden, Fehlercode bei Fehler
 */
transfer_status_t transfer_zigbee_ensure_joined(void);

/**
 * @brief Prüft, ob der ZigBee-Stack initialisiert ist
 * 
 * @return true wenn Stack initialisiert ist, false sonst
 */
bool transfer_zigbee_is_initialized(void);

/**
 * @brief Prüft, ob das Device mit dem ZigBee-Netzwerk verbunden ist
 * 
 * @return true wenn Device joined ist, false sonst
 */
bool transfer_zigbee_is_joined(void);

/**
 * @brief Prüft, ob das Device factory-new ist (noch nicht gepaart)
 * 
 * @return true wenn Device factory-new ist, false sonst
 */
bool transfer_zigbee_is_factory_new(void);

#endif // TRANSFER_ZIGBEE_H
