sneumeister/Gas-o-Meter2/(commit log)

2025-12-26 Initial commit: Gas-O-Meter2 Projekt
    [partitions.csv]
2025-12-28 Version im Arduino-Framework, ohne LP-Core Code (Dummy-Task): - HP-Core in Deep-Sleep nach x Minuten ohne Web-Zugriff - Sauberes dep-sleep durch shutdown_resources() - Wake-up auf Taste "A" - NVS-Rin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
    [ESP32C6_gasometer.step, battcover.stp, gasmeter-case01.stp, lipo_1500mah.prt]
2025-12-28 Kleinere Anpassungen: - hostname gesetzt für DHCP-Server und - mDNS support - Umstellung auf ArduinoJson 7.4.2 - Umstellung auf LittleFS. - Zufügen von bootstrap.min.css.gz (5.3.2) im FileSystem
    [partitions.csv]
2025-12-28 Neue Logik zum ausliefern Web-Server-Inhalte vom LittleFS. Neuer processor() für Variablenersetzung im HTML (ESPAsynWebserver) und entsprechend die Variablem ESCapes im HTML angepasst (%var%). Basic-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
2025-12-29 Arduino-Platform. - Wake-up on Timer und Taste A - Diveres Verbesserungen
2025-12-29 Getrennte behandlung nach Wake-up-Gründen: - Taster A startet Web-Server - Timer gibt Meldung "Datenübertragung" (tbd.) - Codebereinigungen
2025-12-30 Deep-Sleep: Timer-Wake-up bei USB-Stromversorgung aktiv, Akku-Schutz-Logik angepasst Transfer-Intervall: Datenübertragung nur alle X Timer-Wake-ups (DEFAULT_TRANSFER_INTERVAL_X) WiFi: Credentials als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
    [hardware.h]
2025-12-30 CAD-Housing: README.md und Bilder
2025-12-30 Änderungen: Konfigmenü, PLACEHOLDER Neu: data/config.html ==> Konfigurationsmenü Neu: data/config.js ==> Konfigurationsmenü Geändert: data/index.html ==> PLACEHOLDER für Variablen ersetzt Geändert: i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
2026-01-01 Access Point Modus und mobile UI-Optimierungen
    - Access Point Modus bei fehlgeschlagener WiFi-Verbindung (AP IP: 10.0.0.1)
    - NVS-Partition auf 40 KB erhöht für zukünftige Protokolle (BLE, ZigBee)
    - Mobile UI: Responsive Counter-Korrektur, Button-Positionierungen angepasst
    - Config-Seite: Labels in Fettschrift, Buttons näher am Counter-Display
    [partitions.csv]
2026-01-02 UI-Fixes und Basic Auth Realm
    - Basic Auth Realm hinzugefügt (behebt doppelte Login-Aufforderung)
    - Label-Verknüpfung für Counter-Slider (Accessibility)
    - CSS-Fix: wifi_info_style ohne leere Rulesets
    - Textkorrektur: NVS-Speicher
2026-01-05 Intiale Version in ESPIDF. Noch ohne LP-Core.. Gleiche Funktionalität wie dei ARDUINO Version.
    [partitions.csv]
2026-01-07 Phase 1 zigbee integration: Config und Web-UI angepasst. Fehler im Ring-Speicher Handling korrigiert (auch in der ARDUINO version)! On branch zigbee Changes to be committed: - modified: data/config.h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
    [main_idf.cpp, version.h]
2026-01-07 Fix: Ring-Speicher-Handling nach Power-Up! Changes to be committed: - modified: src/main_arduino.cpp - modified: src/main_idf.cpp
    [main_idf.cpp]
2026-01-08 Feat: Transfer-Module Basis-Struktur mit ZigBee-Dummy
    - Transfer-Module erstellt (transfer.h/cpp, transfer_zigbee.h/cpp)
    - Integration in main_idf.cpp
    - ZigBee-Config mit RTC/NVS (zigbee_config.h)
    - Integration Templates (zigbee2mqtt, nodered in "integration_templates")
    - Dokumentation erstellt
    - Build-Fixes
    Status: Dummy-Funktionen getestet.
    Changes to be committed:
    new file: include/transfer.h
    new file: include/transfer_zigbee.h
    new file: include/zigbee_config.h
    new file: integration_templates/README.md
    new file: integration_templates/nodered/README.md
    new file: integration_templates/nodered/gas-o-meter2-ble-flow.json
    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
    [main_idf.cpp, transfer.cpp, transfer.h, transfer_zigbee.cpp, transfer_zigbee.h, zigbee_config.h]
2026-01-08 ESP-Zigbee-SDK Integration und Config-Management
    - ESP-Zigbee-SDK Dependencies und CMake-Integration
    - ZigBee-Config mit NVS-Persistierung (zigbee_rtc_t)
    - Fix: zigbee_rtc multiple definition (Definition nach transfer_zigbee.cpp)
    - ZigBee-Partitionen (zb_storage, zb_fct) in partitions.csv
    - sdkconfig für ZigBee End Device
    modified: include/zigbee_config.h
    modified: partitions.csv
    modified: sdkconfig.defaults
    modified: sdkconfig.espidf
    modified: src/CMakeLists.txt
    modified: src/idf_component.yml
    modified: src/main_idf.cpp
    modified: src/transfer_zigbee.cpp
    [partitions.csv]
2026-01-10 Fix: littlefs partition ins partitions.csv muss am Ende stehen, sonst klappt der build nicht! Offensichtlich wird die Größe der letzten Partition als littlefs-Part.Größe genommen! Ausserdem jetzt kon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
    [partitions.csv]
2026-01-12 Was funktioniert: - Stack-Initialisierung: SKIP_STARTUP Signal wird empfangen - transfer_zigbee_send_data wartet erfolgreich auf Initialisierung - Signal-Handler für STEERING, DEVICE_FIRST_START, etc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
    [main_idf.cpp, transfer_zigbee.cpp, transfer_zigbee.h, zigbee_config.h]
2026-01-21 ZigBee Test.......... On branch zigbee Changes to be committed: new file: CAD-housing/gas-o-meter-assembly_asm.stp new file: ZIGBEE_IMPLEMENTATION_REVIEW.md new file: ZIGBEE_NETWORK_STEERING_ERRORS.m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
    [partitions.csv]
2026-01-22 Fix: Gas-Zähler-Reset und NVS-Persistenz verbessert
    - CurrentSummationDelivered VOR Rejoin initialisieren (verhindert Reset auf 0)
    - NVS-Flash-Schreibung: 100ms Delay nach nvs_commit(), 500ms nach zigbee_config_save_to_nvs()
    - NVS-Verifikation erweitert: prüft jetzt auch extended_addr, zusätzliches 50ms Delay vor Verifikation
    - Gesamt-Delay für Flash-Schreibvorgang: 600ms (100ms + 500ms)
    - DeepSleep button in Index.html
    modified: data/index.html
    modified: data/script.js
    modified: integration_templates/zigbee2mqtt/external_converters/gas-o-meter2.js
    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
    [main_idf.cpp, transfer_zigbee.cpp, zigbee_config.h]
2026-01-24 Verbesserte Zigbee Rejoin/Pairing-Logik und Timing-Optimierungen
    - Poll-Intervall für Network Steering von 200ms auf 500ms erhöht
    (zuverlässigere Signal-Verarbeitung, konsistent mit ZIGBEE_STEERING_POLL_INTERVAL_MS)
    - Interview-Wartezeit für factory-new Devices korrigiert
    (first_pairing_after_join wird jetzt auch gesetzt, wenn Device zwischen Wake-ups joined)
    - Nachträgliche Prüfung nach fehlgeschlagenem Pairing
    (erkennt erfolgreichen Join, wenn Stack im Hintergrund weiterarbeitet)
    - Verbesserte Logik für Devices, die nach fehlgeschlagenen Versuchen später joinen
    (setzt Pairing-Status nachträglich und aktiviert Interview-Wartezeit)
    - Verbesserte Kommentare und Logging f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
    [main_idf.cpp, transfer_zigbee.cpp, version.h, zigbee_config.h]
2026-01-24 Zigbee: Automatische Reports nach Rejoin + Battery REPORTABLE
    - Manuelle Reports nach Rejoin entfernt (Stack sendet automatisch)
    - Battery Percentage und Alarm State als REPORTABLE markiert
    - Verhindert doppelte MQTT-Nachrichten nach Rejoin
    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
2026-01-25 Fix: Interview-Fehler behoben + Battery-Icon + Optimierungen
    - Fix: device_announce wird jetzt explizit nach Pairing gesendet (Interview-Fix)
    - Fix: Battery-Icon in Zigbee2MQTT (persistente power_source Variable + meta)
    - Fix: Battery-Spannung wird nach Config-Load neu berechnet (korrekter Offset)
    - Erhöhte Join/Steering Retry-Counts und Timeouts für schwache Netzwerke
    - Explizite Battery Reporting-Konfiguration im Converter (1h Fallback)
    - Entfernt: 2s Wartezeit nach Wake-Up, verbose Template-Logs
    modified: src/t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
    [main_idf.cpp, transfer_zigbee.cpp, zigbee_config.h]
2026-02-18 feat: Zentrale Zeit-Sync, ZigBee Time Cluster und Basic Cluster
    - Neues time_sync Modul für zentrale Zeitkorrektur (NTP, ZigBee, BLE)
    - time_sync_set_hard() mit settimeofday()
    - time_sync_last_epoch (64-bit) ersetzt ntp_sync_marker
    - time_sync_seconds_since_last() für Alter der letzten Sync
    - ZigBee Time Cluster:
    - Unterstützung für ESP_ZB_ZCL_ATTR_TYPE_UTC_TIME (0xE2)
    - Delta-Anzeige ESP32 vs. Zigbee-Zeit
    - Harte Zeitkorrektur per time_sync_set_hard() nach Empfang
    - Basic Cluster Power Source:
    - Über basic_cfg setzen (vermeidet "attribute 0x7 already existed")
    - Doppelten add_attr-Aufruf entfernt
    - NTP: sync_ntp_time() nutzt time_sync_set_hard()
    - [DEBUG]-Ausgaben i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
2026-02-18 Funktionierende ZigBee-Version mit manuellen send der Attribute. Fallbackversion. v0.8.0
2026-03-08 BLE: Implementierungsplan und Node-RED Flow (generic-ble)
    - docs/BLE_IMPLEMENTATION_PLAN.md: Vollständiger BLE-Implementierungsplan
    mit NimBLE-Stack, GATT-Services (CTS, Device Info, Custom 0xFFF0),
    Datenformat (JSON), Hostname/BLE-Name-Vereinheitlichung (26 Zeichen),
    Timeouts, TX-Power und Pairing-Workflow (ESP32C6 + Node-RED)
    - Node-RED Flow (gas-o-meter2-ble-flow.json):
    - node-red-contrib-generic-ble (BlueZ D-Bus) statt noble
    - BLE Connect/Read Pipeline mit Generic BLE in/out
    - Data Parser für Custom Characteristic 0xFFF1
    - Inject-Mock-Node für Test ohne Hardware
    - MQTT-Publish auf gas-o-meter2/data
    - Home Assistant Auto-Discovery (AN/AUS schaltbar, 5 Entities)
    - D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
2026-03-09 BLE: ESP32C6 NimBLE GATT Server Implementierung
    Vollständige BLE-Datenübertragung für den ESP32C6 mit NimBLE-Stack:
    - include/ble_config.h: BLE-Konfiguration (UUIDs, Timeouts, Advertising)
    - CTS (0x1805), DIS (0x180A), Custom Service (0xFFF0/0xFFF1)
    - Advertising: 90s Dauer, 100ms Intervall, 3min Session-Timeout
    - include/transfer_ble.h + src/transfer_ble.cpp: NimBLE GATT Server
    - Custom Characteristic (0xFFF1): Messdaten als JSON (Read/Notify)
    Format: {"p":<counter>,"bv":<mV>,"bp":<%>,"bl":<0|1>}
    - Current Time Service: Read/Write für Zeit-Sync von Node-RED
    Plausibilitätsprüfung, time_sync_set_hard() via "BLE"
    - Device Information Service: Firmware Revision String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
2026-03-16 Node-RED: Parse-Fix (useString), Status-Handling, Firmware-Ablauf, HA Discovery, Layout
    - Parse BLE Data: Nutzdaten aus characteristics.fff1 bei string-Payload
    - Connect nur bei disconnected/connecting, Subscribe nur bei connected (weniger "Not yet connected")
    - Firmware: On Notify (0xFFF1) → BLE Read (0x2A26) → On Read Result (0x2A26), zweiter BLE-in-Node
    - HA Discovery Config: return [messages] statt node.send()-Schleife (Debug-Ausgabe)
    - Node-Positionen angepasst, keine Überlappungen
    - README: Flow-Übersicht, BLE-Status, Firmware, HA Discovery; Korrekturen
    On branch ble
    modified: data/config.html
    modified: data/config.js
    modified: include/ble_confi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
    [ble_config.h, main_idf.cpp, transfer_ble.cpp]
2026-03-17 Node-Position in Node-red positioniert und gespeichert.
    modified: integration_templates/nodered/gas-o-meter2-ble-flow.json
    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
2026-03-17 Config-Parameter bei geändertem Transfer-Modus erst nach Save & reboot erreichbar. On branch main Changes to be committed: modified: data/config.js modified: include/version.h
    [version.h]
2026-03-18 TX-Power für WiFi, Zigbee und BLE im UI konfigurierbar. UI Optik angepasst. Erreichbarkeit für Transfer-Mode-Settings robuster getsaltet.
    On branch main
    modified: data/config.json_example
    modified: data/style.css
    modified: include/ble_config.h
    modified: include/hardware.h
    modified: src/transfer_ble.cpp
    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
2026-04-09 feat: implementiere vollständige MQTT-via-WiFi Pipeline (Config, Publish-Flow, Topic-Suffixe, HA Auto-Discovery) und passe den BLE-Node-RED-Flow auf dieselbe Struktur an: dynamisches mqtt_main_topic 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
    modified: .gitignore
    new file: .vscode/settings.json
    modified: gas-o-meter2.code-workspace
    new file: include/mqtt_config.h
    new file: include/transfer_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
2026-05-13 Zigbee: Reporting fix (Power-Config manuell, explizite Reports, Z2M-Bind split)
    On branch zigbee_reporting_fix
    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
    [transfer_zigbee.cpp]
2026-05-13 Fix: Battery-Report-Status-Log bei fehlender Spannung
    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
    [transfer_zigbee.cpp]
2026-05-15 Zigbee: Rejoin nach Deep-Sleep beschleunigen und MQTT-Burst reduzieren
    Timer-Wake war zu lang (~54–86 s), weil 45 s passiv auf einen Stack-Rejoin
    gewartet wurde, der erst nach Network Steering + DEVICE_REBOOT eintritt.
    Zigbee2MQTT bekam zudem doppelte device_announce und mehrfach identische
    State-Publishes.
    - Passive Auto-Rejoin auf 15 s begrenzen; 45 s nur noch für DEVICE_REBOOT-Poll
    - DEVICE_REBOOT früh in Steering-Warte auswerten (zigbee_poll_joined_after_reboot)
    - DEVICE_ANNCE: Debounce, Adress-Stabilisierung; beim Rejoin kein expliziter
    ZDO-Request (Stack announced selbst)
    - Nach Rejoin nur summ explizit reporten; Battery per set_attribute_val (Flag
    ZIGBEE_EXPLICIT_BATTERY_REPO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
2026-05-16 Zigbee: passive Rejoin-Warte auf 2 s, Cluster früher nach Rejoin
    Der passiven 15-s-Wartezeit folgt in der Praxis kein Stack-Rejoin;
    Steering → DEVICE_REBOOT bleibt der Erfolgspfad. Zusätzlich Cluster-
    Werte direkt nach Join pushen und 800-ms-Announce-Warte beim Rejoin
    entfernen.
    - ZIGBEE_AUTO_REJOIN_PASSIVE_WAIT_MS: 15 s → 2 s
    - zigbee_push_cluster_vals_to_stack_if_joined() nach DEVICE_REBOOT-Poll
    - Battery-RAM vor ensure_joined befüllen (set_attribute nur wenn joined)
    - Rejoin: keine 800-ms-Warte auf Stack-DEVICE_ANNCE mehr
    On branch zigee_improvement
    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
2026-05-16 Zigbee: Cluster-RAM vor Endpoint mit echten Messwerten befüllen
    Neue Funktion transfer_zigbee_prepare_cluster_attrs() setzt Gas- und
    Battery-Variablen, auf die die ZCL-Attribute zeigen, noch vor
    transfer_zigbee_init() / esp_zb_device_register(). Damit liefert
    create_gas_meter_endpoint() und der erste Z2M-Read nach Join keine
    Defaults mehr (Summation 0, Batterie 4,0 V).
    - transfer_data(): prepare vor init aufrufen
    - send_data(): doppelte Vorbereitung entfernt, prepare idempotent nutzen
    - zigbee_elapsed_ms(): DEVICE_ANNCE-Debounce sicher über esp_timer-Wrap
    - Passives Rejoin: toten Fortschritts-/Hint-Log bei 2 s Warte entfernt
    modified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
2026-05-16 Zigbee: Low-Battery-Alarm bei ungültiger Spannung zurücksetzen
    In transfer_zigbee_prepare_cluster_attrs() wurde battery_alarm_state nur
    bei battery_voltage > 0 aktualisiert. War die Spannung ≤ 0, blieb Bit 0
    (Low Voltage) vom vorherigen Wake gesetzt und konnte fälschlich
    battery_low in Zigbee2MQTT melden.
    Ohne gültige Spannungsmessung wird der Low-Voltage-Alarm jetzt gelöscht.
    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
2026-05-16 time_sync: time_sync_last_epoch als RTC time_t (ESP32-C6 64-bit)
    Ersetzt uint64_t durch RTC_DATA_ATTR time_t fuer semantisch korrekte Epoch-Speicherung und entfernt ueberfluessige Casts bei time(NULL) - time_sync_last_epoch.
2026-05-16 fix(zigbee): push_cluster_vals nach Rejoin als no-op (TZ-292)
    zigbee_push_cluster_vals_to_stack_if_joined() ruft set_attribute_val
    nicht mehr auf: Der Stack liest Metering/Battery bereits über die
    gebundenen Pointer. set_attribute_val nach Rejoin konnte einen
    ungeplanten Report auslösen. Originalcode bleibt auskommentiert.
    On branch zigbee_improvements
    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
    [transfer_zigbee.cpp]
2026-05-16 fix(zigbee): send_data set_attribute_val einmal, Reports unter Lock (TZ-292)
    transfer_zigbee_send_data() ruft prepare_cluster_attrs nur noch einmal auf
    und setzt Metering/Battery mit set_attribute_val erst nach ensure_joined in
    einem [3/4]-Block. Der frühere Block vor ensure_joined und die getrennten
    Schritte [2.5/4]/[3/4] entfallen – Mehrfachaufrufe konnten ungeplante Reports
    auslösen.
    Explizite Attribute-Reports laufen gebündelt unter esp_zb_lock_acquire via
    send_attribute_report_locked(); send_attribute_report() bleibt für Einzelaufrufe.
    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
    [transfer_zigbee.cpp]
2026-05-16 fix(zigbee): RTC nach passivem Auto-Rejoin aus Stack syncen
    Nach erfolgreichem passivem Rejoin wurde zigbee_rtc nicht aktualisiert,
    obwohl der Stack eine neue Netzwerkadresse haben kann. NVS wird nur bei
    geaendertem Addr/PAN/Channel geschrieben.
    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
    [transfer_zigbee.cpp]
2026-05-16 fix(zigbee): NVS-Speichern aus Signal-Handler in Main-Loop deferren
    DEVICE_ANNCE setzt nur noch zigbee_nvs_save_pending; zigbee_config_save_to_nvs
    und vTaskDelay laufen nach stack_main_loop_iteration in zigbee_main_task.
    Vermeidet ~650ms Blockade des Zigbee-Stacks während Pairing/Rejoin.
    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
    [transfer_zigbee.cpp]
2026-05-16 fix(zigbee): Basic-Cluster-Strings als static statt Stack-Pointer
    manufacturer_name, model_id, sw_build_id und app_version bleiben nach
    create_gas_meter_endpoint() gültig; der Stack hält nur Pointer darauf.
    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
    [transfer_zigbee.cpp]
2026-05-16 fix(zigbee): SummationFormatting 0x2A für 2 Nachkommastellen (Divisor 100)
    summation_formatting=0 bedeutete keine Dezimalstellen; ZCL-Clients können
    den Zählerstand falsch darstellen. 0x2A = 5 Vorkommastellen, 2 Nachkommastellen.
    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
    [transfer_zigbee.cpp, zigbee_config.h]
2026-05-16 fix(zigbee): Interview-Warte auf DEVICE_ANNCE statt fix 90 s
    Nach erstem Pairing: max. 60 s auf DEVICE_ANNCE, danach 30 s Post-Announce
    fuer Z2M. Typisch ~30 s wenn ANNCE bereits nach ensure_joined gesetzt.
    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
    [transfer_zigbee.cpp, zigbee_config.h]
2026-05-16 feat(zigbee): Diagnostics-Cluster mit Last LQI/RSSI für Z2M
    Zigbee2MQTT kann Linkqualität in der Geräteübersicht anzeigen.
    LQI/RSSI kommen aus der Parent-Zeile der Neighbor Table und werden
    bei Join, Rejoin und send_data aktualisiert.
    modified: include/transfer_zigbee.h
    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
2026-05-16 fix(zigbee): Pairing- und Cycle-Timeout für Akku-Laufzeit verkürzen
    PAIRING_TIMEOUT 180s→60s pro Steering-Versuch, CYCLE_TIMEOUT 5min→3min
    als harter Deckel für fehlgeschlagenes Pairing ohne Coordinator.
    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
    [zigbee_config.h]
2026-05-16 fix(zigbee): DEVICE_ANNCE-Flag nicht vor Interview-Warte zuruecksetzen
    Reset am Anfang von ensure_joined() loeschte ein bereits empfangenes
    DEVICE_ANNCE und erzwang 60s Wartezeit beim ersten Pairing. Flag wird
    nach zigbee_wait_for_first_pairing_interview() zurueckgesetzt; bei
    direktem Join ohne ZDO-Signal wird es gesetzt.
    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
    [transfer_zigbee.cpp]
2026-05-17 fix(zigbee): Stack-APIs für RTC und Diagnostics mit esp_zb_lock absichern
    zigbee_update_rtc_from_stack und Parent-Diagnostics laufen nur noch aus
    dem Application-Task unter Lock; Signal-Handler nutzen _impl ohne Lock.
    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
    [transfer_zigbee.cpp]
2026-05-17 fix(zigbee): Interview-Flag bei Rejoin zurücksetzen
    Passiver Auto-Rejoin und „bereits joined“ mit synchronem RTC kehrten
    früh zurück und ließen first_pairing_after_join gesetzt – send_data
    wartete fälschlich bis zu 90 s auf Z2M-Interview.
    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
    [transfer_zigbee.cpp]
2026-05-17 feat(zigbee): OTA-Upgrade-Cluster als Client-Platzhalter einbinden
    Cluster 0x0019 jetzt in der Endpoint-Liste, damit spaetere OTA ohne
    Factory-Reset moeglich bleibt; FileVersion aus RING_BUFFER_VERSION.
    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
    [transfer_zigbee.cpp, zigbee_config.h]
2026-05-17 refactor(zigbee): set_attribute_val in send_data entfernt (TZ-292)
    Werte liegen in gebundenem Cluster-RAM via prepare_cluster_attrs;
    Belt-and-Braces nur noch über explizite report_attr_cmd_req.
    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
2026-05-17 fix(zigbee): STEERING-Delay als Stack-Workaround dokumentieren, #335-Verweis entfernen
    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
    [transfer_zigbee.cpp, zigbee_config.h]
2026-05-17 fix(zigbee): esp_zb_lock für Stack-Netzinfo-Lesezugriffe
    zigbee_read_network_info_locked() bündelt joined/Addr/PAN/Channel unter
    esp_zb_lock. Alle Aufrufe in ensure_joined, Rejoin-Helfern, send_data,
    sync_time und is_joined nutzen den gesicherten Einstieg; Signal-Handler
    unveraendert.
    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
    [transfer_zigbee.cpp]
2026-05-17 fix(zigbee): NVS-Save-Retry bei deferred Speichern aus Signal-Handler
    zigbee_nvs_save_pending erst nach erfolgreichem zigbee_config_save_to_nvs()
    zuruecksetzen, damit transiente Flash-Fehler im Main-Loop erneut versucht werden.
    vTaskDelay(500) im Erfolgsfall entfernt – Main-Loop soll nicht blockieren.
    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
    [transfer_zigbee.cpp]
2026-05-17 refactor(zigbee): Interview-Flag bei RTC-Sync ohne redundanten Guard setzen
    Nach was_not_joined wird first_pairing_after_join immer gesetzt; der
    !first_pairing_after_join-Check verhinderte nur true=true.
    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
2026-05-17 fix(zigbee): Parent-Adresse in coord_addr und redundante NVS-Delays entfernen
    coord_addr aus Neighbor-Table-Parent statt fest 0x0000 (Router-Verbindung).
    vTaskDelay(500) nach zigbee_config_save_to_nvs() in ensure_joined entfernt –
    Commit/Verifikation erfolgt bereits in der Save-Funktion.
    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
    [transfer_zigbee.cpp]
2026-05-17 fix(z2m): Batteriespannung im External Converter in Volt statt mV
    Home Assistant erwartet Spannung typischerweise in V (device_class voltage).
    Zigbee liefert weiterhin 100-mV-Einheiten; der Konverter rechnet mit /10 um.
    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
2026-05-17 fix(zigbee): Interview-Flag nach DEVICE_ANNCE vor ensure_joined erhalten
    first_pairing_after_join wird nur noch gelöscht, wenn pairing_successful
    false ist. Sonst werteten passiver Rejoin und der „RTC bereits synchron“-
    Zweig ein frisches Pairing fälschlich als Rejoin und Z2M bekam in send_data
    kein Interview-Fenster (60+30 s).
    modified: src/transfer_mqtt.cpp
    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
    [transfer_mqtt.cpp, transfer_zigbee.cpp]
2026-05-17 fix(partitions): factory-Partition vergrößern (Image > 0x224000)
    Firmware zigbee_improvements (~2,25 MB) passte nicht mehr in factory
    (2.244.608 Bytes). factory auf 0x230000 (+48 KB), nachfolgende Partitionen
    verschoben.
    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
    [partitions.csv]
2026-05-17 fix(zigbee): Sleepy ED und aktuelle Batteriewerte nach Rejoin
    rx_on_when_idle in transfer_zigbee_init() auf false (Sleepy End Device);
    RX bleibt vor Steering/Rejoin in ensure_joined temporär aktiv.
    Battery-Reports nach Rejoin explizit senden (Z2M-Spannung aktuell).
    External Converter: battery_voltage mit einer Dezimalstelle in V.
    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
    [transfer_zigbee.cpp, zigbee_config.h]
2026-05-17 fix(zigbee): RX-on nach direktem Rejoin wieder deaktivieren
    RX-on nur vor Network Steering; nach erfolgreichem BDB-Rejoin
    wieder rx_on_when_idle=false (Sleepy ED während Datenphase).
    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
    [transfer_zigbee.cpp, zigbee_config.h]
2026-05-17 fix(zigbee): RX-on nach Steering-Rejoin wieder deaktivieren
    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
    [transfer_zigbee.cpp]
2026-05-17 fix(zigbee): ungültigen Secondary-Channel-Mask-Aufruf entfernen
    esp_zb_set_secondary_network_channel_set(0) liefert ESP_ERR_INVALID_ARG;
    für direkten Rejoin und Mask-Restore reicht die Primary-Maske.
    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
    [transfer_zigbee.cpp]
2026-05-18 fix(zigbee): nach INITIALIZATION-Timeout auf DEVICE_REBOOT vor Steering warten
    Vermeidet ESP_FAIL (already in commissioning) und spart den 5s-Retry.
    Doppeltes DEVICE_REBOOT nach erfolgreichem Rejoin ignorieren.
    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
    [transfer_zigbee.cpp, zigbee_config.h]
2026-05-18 fix(zigbee): DEVICE_REBOOT nur während aktivem Pairing/Rejoin auswerten
    Setzt device_rebooted_during_rejoin nur, wenn ensure_joined gerade
    Pairing oder Rejoin fährt; verhindert späte Reboots nach erfolgreichem
    Rejoin und stellt die Pairing-Steering-Warte wieder her. Flags werden
    pro ensure_joined-Zyklus zurückgesetzt.
    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
    [transfer_zigbee.cpp]
2026-05-18 fix(zigbee): Underflow bei DEVICE_REBOOT-Poll im direkten Rejoin vermeiden
    remaining_ms vor zigbee_poll_joined_after_reboot() sicher aus timeout_ms
    berechnen; verhindert Unsigned-Underflow und endloses Warten bei spätem
    DEVICE_REBOOT nach INIT-Timeout.
    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
    [transfer_zigbee.cpp]
2026-05-18 fix(zigbee): Poll-Zeit nach DEVICE_REBOOT buchen und RX nach Pairing-Interview aus
    poll_elapsed_ms_out in zigbee_poll_joined_after_reboot() für korrekte
    Timeout-Buchführung in Rejoin/Steering; rx_on_when_idle nach Interview bzw.
    bei Pairing-Fehler wieder deaktivieren (Sleepy ED).
    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
    [transfer_zigbee.cpp]
2026-05-18 fix(zigbee): Rejoin-Fehlerpfad RX aus und Broadcast-PAN vom direkten Rejoin ausschließen
    Nach fehlgeschlagenem Rejoin rx_on_when_idle wieder deaktivieren (Sleepy ED).
    ZIGBEE_RTC_HAS_DIRECT_REJOIN_CTX lehnt PAN 0xFFFF ab, um sinnlosen INIT-Timeout zu vermeiden.
    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
    [transfer_zigbee.cpp, zigbee_config.h]
2026-05-20 fix(main): Timer-Wake-up unter 0,5× Intervall auf nächstes volles Intervall schieben modified: src/main_idf.cpp
    [main_idf.cpp]
2026-05-21 fix: zigbee_config_save_to_nvs — unnötige Delays nach commit_nvs entfernt.
    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
    [transfer_zigbee.cpp]
2026-05-21 refactor: Arduino-Dual-Build entfernen, nur ESP-IDF
    Alle #ifdef ARDUINO-Zweige und Arduino-Plattform-Kommentare aus dem
    Quellcode entfernt. PIOArduino-Platform und ArduinoJson bleiben.
    Behoben: versehentlich zusammengefügte Kommentar/Code-Zeilen in
    main_idf.cpp nach der Kommentar-Bereinigung.
    modified: include/transfer_ble.h
    modified: include/transfer_mqtt.h
    modified: platformio.ini
    modified: src/transfer.cpp
    modified: src/transfer_zigbee.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
    [hardware.h, main_idf.cpp, transfer.cpp, transfer_ble.cpp, transfer_ble.h, transfer_mqtt.cpp, transfer_mqtt.h]
2026-05-22 fix(mqtt): battery_low-Schwelle über BATTERY_VOLTAGE_30 aus hardware.h
    Die MQTT-Payload nutzt dieselbe 30%-Spannungsschwelle (3,57 V) wie ZigBee und BLE,
    statt einer lokal hartcodierten Konstante.
    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
    [transfer_mqtt.cpp]
2026-05-22 fix(mqtt): ntp_status als HA-Timestamp (ISO-UTC, kein epoch_s)
    [transfer_mqtt.cpp]
2026-05-22 fix(mqtt): HA unique_id an Discovery-Object-ID (gas_o_meter2_<slug>_<tail>) angleichen
    [transfer_mqtt.cpp]
2026-05-22 fix(mqtt): HA availability via status (online/offline, LWT)
    modified: include/mqtt_config.h
    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
    [mqtt_config.h, transfer_mqtt.cpp]
2026-05-22 fix(mqtt): QoS-1-PUBACK pro Publish abwarten (früher Exit, Retry)
    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
    [mqtt_config.h, transfer_mqtt.cpp]
2026-05-23 PCB Schaltplan Version "20251022" zugefügt
2026-05-24 LittleFS per IDF Component Manager; USB-Erkennung per VBUS-GPIO (PCB 20260523)
    LittleFS nur noch ESP-IDF-konform einbinden: joltwallet/littlefs über
    src/idf_component.yml, littlefs in REQUIRES, esp_littlefs aus lib_deps
    entfernt und EXTRA_COMPONENT_DIRS auf .pio/libdeps abgeschaltet. Vermeidet
    Doppel-Build und inkompatible lib_deps-Versionen (z. B. 1.22.x / esp_blockdev.h).
    Platinenversionen als PIO-Environments (PCB_20251022 / PCB_20260523) mit
    BOARD_VERSION_ID. Platine 20260523: USB per GPIO18 (VBUS, HIGH = 5 V);
    20251022 unverändert per ADC. Web-UI zeigt Platinenversion; HARDWARE_PCB_ID
    aus version.h entfernt.
    modified: CMakeLists.txt
    modifi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
2026-05-24 Add: PCB_schmetics + 3D pictusre added PCB_20251022 / PCB_20260523
    new file: KiCAD-PCB/Version20251022/ESP32C6_PCB_3D.png
    new file: KiCAD-PCB/Version20260523/ESP32C6_PCB_3D.png
    new file: KiCAD-PCB/Version20260523/ESP32C6_schematic.png
    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
2026-05-24 fix(ha): RSSI als entity_category diagnostic in MQTT-Discovery
    RSSI in transfer_mqtt.cpp und im Node-RED BLE-Flow mit
    entity_category: diagnostic versehen — analog zu Firmware und NTP.
    Ohne Kategorie erschien RSSI als Primärentität in der HA-Geräteübersicht.
    On branch mqtt_improvements
    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
    [transfer_mqtt.cpp]
2026-05-24 fix(mqtt): ntp_status als Epoch, timestamp als ISO-UTC; NTP-Sentinel -1
    MQTT/WiFi: ntp_status publiziert Unix-Epoch des letzten NTP-Syncs, timestamp
    dieselbe Zeit als ISO-8601 UTC. Bei nie erfolgtem Sync: ntp_status=-1; bei
    fehlgeschlagenem NTP nach früherem Erfolg kein Publish (Retain bleibt).
    HA-Discovery für Last NTP Sync: epoch_s statt device_class timestamp.
    RSSI mit entity_category diagnostic. Konstante MQTT_NTP_STATUS_NEVER_SYNCED.
    Node-RED: Kommentare/README zur BLE-Abweichung (ntp_status=-1, timestamp vom Gateway).
    modified: integration_templates/nodered/README.md
    modified: integration_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
    [mqtt_config.h, transfer_mqtt.cpp]
2026-05-25 refactor(wifi): WiFi-Logik in wifi_manager auslagern
    Connect, Scan und AP laufen zentral im Modul wifi_manager.
    STA-Verbindung wartet per EventGroup auf GOT_IP statt 500-ms-Polling.
    Nur noch ein esp_wifi_start pro Session; doppelter Start im Connect-Loop entfernt.
    main_idf und transfer_mqtt nutzen wifi_connect_sta(); MQTT-Publish unverändert.
2026-05-26 fix(wifi): Stack-Overflow bei Timer-MQTT-Wake beheben
    Große Puffer in wifi_manager und transfer_mqtt statisch auslagern und
    Main-Task-Stack auf 8192 Bytes erhöhen. Behebt Guru Meditation (Stack protection fault)
    beim Timer-Wake vor wifi_connect_sta/transfer_mqtt_send_data.
    modified: sdkconfig.PCB_20260523
    modified: src/wifi_manager.cpp
    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
    [main_idf.cpp, transfer_mqtt.cpp, wifi_manager.cpp]
2026-05-27 fix(mqtt): HA Auto-Discovery reparieren und Availability für Deep Sleep
    Home Assistant hat Discovery-Payloads wegen ungültigem JSON ignoriert
    (Doppelkomma vor availability, fehlendes Komma vor device). Zusätzlich
    verhinderte status=offline (retain) nach jedem Sendezyklus dauerhaft
    „nicht verfügbar“.
    - Discovery-JSON: avail/device-Kommas korrigiert, Payload-Puffer 1536 B
    - HA-Topic-Slug: Bindestriche → Unterstriche (eindeutige object_id)
    - expire_after 120 min (MQTT_HA_EXPIRE_AFTER_SEC) für alle 7 Entitäten
    - Nach erfolgreichem MQTT-Zyklus kein explizites offline; nur bei Fehler + LWT
    - NTP-Sensor: device_class timestamp statt epoch_s
    - sdkconfig.PCB_20260523: MAIN_TASK_STACK_SIZ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
    [mqtt_config.h, transfer_mqtt.cpp]
2026-05-27 docs(config): Hostname-Hinweis für BLE, mDNS und MQTT/HA erweitern
    Der 26-Zeichen-Hinweis bezog sich nur auf BLE; Hostname wird auch für
    mDNS/Web-Zugriff, MQTT/HA-Gerätename und als Standard-MQTT-Main-Topic genutzt.
    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
2026-05-27 chore: Hilfsskripte unter tools/ entfernen
    Entfernt clear_ha_discovery_retained.py und validate_ha_discovery_json.py;
    HA-Discovery-Pflege erfolgt über Firmware und MQTT-Broker/HA direkt.
    deleted: tools/clear_ha_discovery_retained.py
    deleted: tools/validate_ha_discovery_json.py
2026-05-28 feat(nodered): BLE-Flow HA Discovery an WiFi/MQTT angleichen
    PRESETS auf mqtt_main_topic und ha_device_name beschränken; Projekt-
    Konstanten wie mqtt_config.h. Discovery: korrekte unique_id/Slug,
    expire_after, availability_topic, Spannung in V, Firmware-Tail firmware,
    NTP als timestamp. Telemetrie: bv mV→V, /status=online bei BLE-Update.
    README und Kommentar-Node mit Kurzanleitung ergänzt.
    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
2026-05-28 docs(nodered): BLE-Flow Kurzanleitung und Layout überarbeiten
    Kurzanleitung: nur BLE-Modus, MAC/Pairing-Schritt, ohne Hersteller-Hinweis.
    Group „MQTT/HA Setup“ oben, Node-Beschreibungen (z. B. Auto-Scan 1×).
    README an Setup-Schritte und Group-Position angepasst.
    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
2026-05-28 feat(nodered): ntp_status aus BLE-Zeit-Write (flow.ble_time_sync_epoch)
    CTS Write setzt Epoch vor Parse; Einzeltopics liest flow mit Fallback -1.
    README: MQTT-Abschnitt vereinfacht, Nodennamen und ntp_status-Doku.
    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
2026-05-28 docs(zigbee2mqtt): README an gas-o-meter2.js und aktuelle Exposes anpassen
    Zigbee-Doku: nur External Converter (.js), YAML/mjs entfernt; Exposes gas,
    battery_voltage, battery_low; Firmware nur Basic Cluster. integration_templates/
    README: Struktur und Kurzanleitung für external_converters/.
    modified: integration_templates/README.md
    modified: integration_templates/zigbee2mqtt/README.md
    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
2026-06-04 feat(web-api): Transfer-Actions vereinheitlichen und MQTT-Servertest
    ZigBee/BLE/MQTT-Endpunkte nutzen gemeinsame Auth-Hilfen und prüfen
    transfer_mode. BLE-Pairing läuft über POST /ble/action; MQTT-Test
    (servertest) ohne Speichern inkl. UI-Button nur bei STA-WLAN.
    On branch refract_web_endpoints
    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
2026-06-04 fix(config): MQTT-Test POST, Transfer-Panel nach Save und Passwort-Toggle
    Transfer-Actions senden urlencoded statt multipart (512-Byte-Limit).
    Nach Config-Save bleibt die Modus-Sektion sichtbar; MQTT-Passwort
    bekommt das Auge wie bei WiFi.
    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
    [main_idf.cpp]
2026-06-04 fix(config): ZigBee-Status-Fetch gegen veraltete Antworten absichern
    zigbeeStatusFetchSeq: Nur die neueste /zigbee/status-Antwort aktualisiert
    die Tabelle (updateZigbeeStatus und Pairing-Polling).
    Nach Factory-Reset nur noch ein Status-Refresh nach 800 ms statt
    zwei paralleler Fetches, die sich gegenseitig mit alten Daten
    überschreiben konnten.
    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
2026-06-04 fix(mqtt): MQTT-Test-URI thread-lokal statt static (parallele Requests)
    transfer_mqtt_test_connection: test_uri auf dem Stack statt s_test_uri,
    damit parallele /mqtt/action servertest-Aufrufe im HTTP-Thread-Pool
    sich nicht die Broker-URI überschreiben.
    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
    [transfer_mqtt.cpp]
2026-06-04 fix(zigbee): Live-Status in Config-UI und korrekte Anzeige nach Reset/Pairing
    ZigBee-Statustabelle wird per /zigbee/status aktualisiert (nicht nur
    Server-Template). Nach Factory-Reset sofort „Factory-New“, nach Start
    Pairing Polling bis Join („Pairing läuft…“ → „Gepaart“). Firmware:
    joined vor factory_new, Status pairing, NVS nach Reset. Z2M-Converter
    definition version 0.0.1.
    modified: src/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
    [main_idf.cpp, transfer_zigbee.cpp]
2026-06-04 fix(zigbee): Pairing-Config beim Deinit und /zigbee/status in NVS sichern
    Nach Join wurde zigbee_rtc nur verzögert in der Main-Loop geschrieben.
    Bei Reboot (esp_restart) ist RTC-RAM weg – ohne NVS-Flush wirkte die
    Config-UI wieder „factory-new“.
    - transfer_zigbee_persist_config_to_nvs(): RTC aus Stack, pending setzen,
    Save über zigbee_process_pending_nvs_save (Wear-Leveling in save_to_nvs)
    - Aufruf in transfer_zigbee_deinit(); Reboot/Deep-Sleep nur über shutdown_resources
    - /zigbee/status: Live-Netzdaten anzeigen und bei veraltetem RTC persistieren
    modif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
    [main_idf.cpp, transfer_zigbee.cpp, transfer_zigbee.h]
2026-06-04 fix(zigbee): NVS-Sync bei /zigbee/status nur anfordern, nicht sofort schreiben
    Veraltetes zigbee_rtc: RTC aus Stack + pending setzen, Flush in Main-Loop.
    Vermeidet wiederholtes NVS aus dem HTTP-Handler (Wear); Deinit flusht weiter synchron.
    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
    [transfer_zigbee.cpp, transfer_zigbee.h]
2026-06-04 fix(zigbee): Factory-Reset nicht durch Deinit-Persist überschreiben
    Nach dem Zurücksetzen von RTC/NVS rief transfer_zigbee_deinit() noch
    persist_config_to_nvs() auf und schrieb den noch „joined“ Stack zurück.
    Während factory_reset_in_progress kein Stack-Sync; pending wird gelöscht.
    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
    [transfer_zigbee.cpp]
2026-06-04 fix(zigbee): Reboot-Crash nach Pairing – WiFi-Stop bei aktivem Stack überspringen
    transfer_zigbee_deinit() beendet nur die Main Loop, nicht den SDK-Stack.
    esp_wifi_stop() danach löste auf dem ESP32-C6 einen sys_evt Stack-Protection-
    Fault aus (WiFi/ZigBee-Coex). Vor esp_restart() und Deep-Sleep wird WiFi
    bei Modus zigbee nicht mehr gestoppt; das Radio wird ohnehin zurückgesetzt.
    Zusätzlich: CAN_SLEEP (0x16) nur noch DEBUG; NVS-deferred-Log nur bei
    echtem Flash-Schreiben; Config-Web (Status-Polling, MQTT-Test, Auth auf
    Transfer-Actions, joined vor factory-new in der Anzeige).
    modified: src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
    [main_idf.cpp, transfer_zigbee.cpp, zigbee_config.h]
2026-06-04 fix(zigbee,config): Pairing-Status nicht hängen lassen bei fehlgeschlagenem Start
    Firmware: web_steering_requested nur bei erfolgreichem Steering-Start setzen;
    bei Fehler zurücksetzen, sofern der Stack nicht bereits steuert. Veraltetes
    Flag in /zigbee/status per BDB-Mode und Grace-Periode bereinigen.
    Config-UI: Statuszelle erst nach erfolgreichem POST auf „Pairing läuft…“;
    bei Fehler Tabelle per /zigbee/status aktualisieren (kein Widerspruch zur
    Fehlermeldung).
    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
    [transfer_zigbee.cpp]
2026-06-04 fix(zigbee): Reboot nach Pairing – WiFi/802.15.4-Coex und sys_evt-Stack
    Nach erfolgreichem Web-Pairing crashte esp_restart() in sys_evt (Stack
    protection fault), auch wenn WiFi-Stop zuvor übersprungen wurde.
    - esp_coex_wifi_i154_enable() beim ZigBee-Init (WiFi+802.15.4 auf ESP32-C6)
    - esp_coex_ieee802154_status_disable() in transfer_zigbee_deinit vor WiFi-Stop
    - WiFi-Stop wieder aktiv nach Main-Loop-Stopp und kurzer Pause (kein Skip)
    - sys_evt-Stack 4096 (sdkconfig.defaults + PCB-Env-Konfigs)
    - esp_coex als CMake-Abhängigkeit
    modified: sdkconfig.PCB_20251022
    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
    [main_idf.cpp, transfer_zigbee.cpp]
2026-06-04 docs: Commit-Archiv für refract_web_endpoints portieren
    Referenzliste der Branch-Commits inkl. Messages und geänderter Dateien für Cherry-picks (Phase A–D).
2026-06-05 feat(web,zigbee): Phase E – Long-Poll, Coex vor WiFi, vereinheitlichtes Web-Pairing
    Web-ZigBee:
    - start-pairing startet zigbee_xfer mit transfer_data() (wie Timer-Wake)
    - GET /zigbee/status: nur RTC/Flags, kein esp_zb_lock (kein HTTP-Deadlock)
    - Long-Poll via ?wait=N (max 30 s), Activity-Refresh in Warteschleife
    - /zigbee/action nur bei STA; 503 im Einrichtungs-AP
    Frontend (config.js/html):
    - Long-Poll ?wait=20 statt 10-s-Polling; Client-Timeout 30 s
    - Stay-Alive pausiert während Long-Poll
    - ZigBee-UI (Pairing/Factory-Reset) nur bei WLAN (STA), Hinweistext
    WiFi/Coex (ESP32-C6):
    - esp_coex in REQUIRES; esp_coex_wifi_i154_enable() einmal vor esp_wifi_init
    - Kein esp_coex_ieee802154_status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
    [main_idf.cpp, transfer_zigbee.cpp, transfer_zigbee.h, wifi_manager.cpp, wifi_manager.h, wifi_scan_config.h, zigbee_config.h]
2026-06-06 refract(captive): Captive Portal auf nordesems/esp-captive-portal umstellen
    Eigenbau-DNS und Custom-Probe-Handler entfernen, stattdessen captive_portal_register() mit DHCP Option 114. Web-Assets nach /static/, Handler-Reihenfolge App -> static -> Captive; AP-IP vor esp_wifi_start().
2026-06-07 fix: Modiefied during build. On branch mqtt_improve Changes to be committed: modified: sdkconfig.PCB_20260523
2026-06-07 fix(mqtt): Spezifische Fehlermeldungen beim Verbindungstest
    MQTT_EVENT_ERROR auswerten (DNS, Auth, Erreichbarkeit, TLS, Subscribe) statt pauschalem Timeout; Verbindungstest bricht bei Fehler sofort ab. JSON liefert error_type, connect_return_code, esp_err und sock_errno; Web-UI zeigt Meldungen und Debug-Tooltip.
    [main_idf.cpp, transfer_mqtt.cpp]
2026-07-11 docs(kicad): Platinendokumentation fuer Version 20251022 und 20260523
    README mit Funktionsprinzip (Reed, TPL5110), Stromversorgung (GPIO0 Pin1/A0/D0, USB ADC bzw. VBUS GPIO18), BOM, Schaltplan-PNG/PDF, 3D-Ansicht und KiCAD-Exporten.
    [BOM_ESP32C6_gasometer.xlsx, ESP32C6_gasometer.kicad_pcb, ESP32C6_gasometer.kicad_sch]
2026-07-11 docs(kicad): KiCAD-Export-Verzeichnis in README verlinken
2026-07-12 docs(cad-housing): Gehaeuse-README strukturieren und markdownlint-konform formatieren
    Erweitert die Dokumentation um CAD-, STEP- und JLCPCB-Abschnitte und behebt MD033/MD060-Warnungen.
2026-07-12 docs(kicad): Schaltplan-PDF fuer Platinenversion 20260523 ergaenzen
    KiCAD-Projektexport als ESP32C6_gasometer.pdf, analog zu Version 20251022.
2026-07-12 chore(gitignore): KiCAD-Temporaerdateien ignorieren
    Autosaves, Lock-Dateien, fp-info-cache und Backup-Ordner unter KiCAD-PCB/ aus dem Repository ausschliessen.
2026-07-12 docs(cad-housing): Gehaeuse-Bilder in pictures/ versionieren
    Bilder in Unterverzeichnis pictures/ ausgelagert und um house04/05 erweitert. Gitignore erlaubt PNG/STP/MD in CAD-housing-Unterordnern.
2026-07-12 docs(cad-housing): Creo-Quelldateien und PCB-STEP-Export versionieren
    Creo_parametrics mit Assembly und Teilen sowie ESP32C6_gasometer.step ins Repository aufnehmen.
    [ESP32C6_gasometer.step, battcover.prt, gasmeter-case01.prt, lipo_1500mah.prt]
2026-07-12 docs(kicad): XIAO ESP32-C6 als U2 in Stuecklisten aufnehmen
    BOM in README und XLSX fuer Version 20251022 und 20260523 um Seeed Studio XIAO ESP32-C6 ergaenzt.
    [BOM_ESP32C6_gasometer.xlsx]
2026-07-12 docs: Zigbee-Dokumentation aus Repo-Root entfernen
    ZIGBEE_IMPLEMENTATION_REVIEW und ZIGBEE_NETWORK_STEERING_ERRORS aus dem Projektroot entfernt.
2026-07-12 docs: Root-README als zentrale Projektdokumentation erweitern
    Features, Hardware-Links, Transfer-Modi, Software-Stack, Build-Environments und Konfiguration; USB-Erkennung per BOARD_VERSION_ID ohne Platinen-Zwang.
2026-07-18 docs: Akku-Schutz und Web-UI-Dokumentation ergaenzen
    LiPo-Spannungsreihe und Wake-up-/USB-Verhalten im Root-README; Web-UI-Anleitung mit Screenshots und Preview-HTML.
2026-07-18 docs: README-Abschnitte neu ordnen und Statusbild ergaenzen
    Akku-Schutz hinter Transfer-Modi; Status-Uebersicht als Vorschaubild.
2026-07-18 docs: README-Badges fuer Release, Lizenz und Stack ergaenzen
    Shields fuer v-Release, GPLv3, ESP32-C6, pioarduino und ESP-IDF.
2026-07-19 feat(webui): Zaehlerstand per Tastatur eingeben (v1.0.1)
    Editierbare Vor-/Nachkomma-Felder mit Zahlenfilter und Navigation
    (Tab, Punkt/Komma, Pfeiltasten); Version auf 1.0.1 anheben.
2026-07-19 fix(counter): NVS-Schreiben bei manueller Korrektur absichern
    Fehler pruefen, ring_idx reparieren, Commit+Verify loggen;
    Erfolg nur melden, wenn der Wert wirklich in NVS liegt.
    [main_idf.cpp]
2026-07-19 fix(lp-core): Zaehlerstand nach Binary-Load wiederherstellen
    ulp_lp_core_load_binary setzt pulse_counter auf 0; Wert sichern und
    NVS-Restore vor dem Watchdog-Start ausfuehren.
    [main_idf.cpp]
2026-07-19 docs: README Markdownlint (MD012/MD047) und Link-Syntax korrigieren
    Doppelte Leerzeilen entfernen, Dateiende-Newline und kaputte Backtick-Links.
2026-07-21 fix(z2m): Firmware-ID bei Reconfigure aus genBasic aktualisieren
    swBuildId lesen und device.softwareBuildID setzen, damit die About-UI nach USB-Flash die aktuelle Version zeigt.
2026-07-22 fix(webui): +/- Zaehler auf Mobil exakt und Hold verzoegert
    Touch+Mouse-Doppeltrigger vermeiden; Repeat erst nach Hold-Delay,
    Beschleunigung spaeter und weniger aggressiv.
2026-07-27 fix(lp-core): Watchdog-Falschzaehlung bei Dauer-LOW verhindern
    Zaehlt nur HIGH→LOW-Flanken und haelt lp_core_running auch waehrend LOW/Idle am Leben; HP-Core verwirft RTC-Muell und nutzt 6s Watchdog.
    [hardware.h, main_idf.cpp, ulp_main.c]
2026-07-27 docs: TPL_test-Erwartung fuer Dauerbruecke und Magnettest korrigieren
2026-07-29 docs(kicad): Reed-Empfindlichkeit und Steckerpraezisierung
    - Praezisierung der Reed-Schalter Empfindlichkeit *-1520, anstatt *-2025
    - Akku-Buchse JST-PH2.0
    - Reed-Schalter Stecker/Buchse JST-XH1.25
    [BOM_ESP32C6_gasometer.xlsx, ESP32C6_gasometer.kicad_sch]
2026-07-29 fix(nvs): Ring-Buffer nur noch bei Low-Akku schreiben
    USB/VBUS allein loest kein NVS-Schreiben mehr aus, solange der Akku >= 30 % ist — Flash-Schonung bei sicherem RTC-RAM.
    [main_idf.cpp]
2026-07-29 docs(nodered): PRESETS-Tabelle ohne unklare „dort“-Verweise
    Node-Namen in der Spalte „Wo“ explizit nennen.
2026-07-29 docs(nodered): Flow-Vorschaubild und praezisere Einleitung
    Thumbnail verlinkt auf Vollbild; Einleitung nennt Empfang und Zeitsync-Rueckkanal.
2026-07-29 docs(kicad): Reed-Ausrichtung im Gehaeuse dokumentieren
2026-07-30 docs(bom): Steckerbezeichnungen angepasst und LiPo-Akku zugefügt
    [BOM_ESP32C6_gasometer.xlsx]
2026-07-30 feat(release): automatisierte Web-Flash-Releases
    Tag-basierte Builds liefern reproduzierbare PCB- und TPL-Artefakte, Release-Downloads und einen browserbasierten Flasher mit sicherem Latest-Deploy.
2026-07-30 fix(release): Teilupdates vor Full-Erase schützen
    Fordert bei Teil-Images eine Erase-Bestätigung an und aktualisiert Web-Flash- sowie Pages-Abhängigkeiten.
2026-07-31 docs(bom): README-Tabellen mit Excel abgleichen
2026-08-02 fix(release): nicht flashbare Firmware-Artefakte verhindern
    Build-Abhängigkeiten werden reproduzierbar fixiert und Release-Images vor Veröffentlichung gegen die tatsächliche Factory-Partition geprüft.
2026-08-02 fix(release): aktuellen esptool-Befehl bevorzugen
    Der Release-Build vermeidet damit die Deprecation-Warnung und behält den alten Namen nur als Fallback.
2026-08-02 chore(release): Version auf 1.0.3 erhöhen
    Der neue Patch-Release ersetzt die zurückgezogenen, nicht flashbaren 1.0.2-Artefakte.
2026-08-02 docs(release): Lizenzhinweise mit Artefakten ausliefern
    Web-Flasher und Releases verlinken Quellcode, GPLv3 sowie die Lizenz- und Copyright-Hinweise der direkten Drittanbieter-Abhängigkeiten.
2026-08-02 docs(license): Projekt auf Apache 2.0 umlizenzieren
    Die permissive Projektlizenz vermeidet den Konflikt mit der separat lizenzierten ZBOSS-Bibliothek; NOTICE und Release-Hinweise grenzen Drittanbieterrechte klar ab.
2026-08-02 docs(license): Grund der Umlizenzierung erläutern
    Die Dokumentation macht den möglichen Copyleft-Konflikt mit den separaten ZBOSS-Binärbedingungen als Motivation transparent.
2026-08-02 fix(zigbee): Zeitsynchronisation an Coordinator senden
    Parent-Router und Coordinator werden wieder getrennt, damit Time-Cluster-Reads gemäß Zigbee-Spezifikation stets 0x0000 erreichen.
    [transfer_zigbee.cpp]
2026-08-02 chore(develop): Version 1.0.4 vorbereiten
    Der Develop-Branch sammelt die nächsten Korrekturen bereits unter der kommenden Patch-Version.
2026-08-15 docs(web-flasher): Firefox Web Serial dokumentieren
    Nutzer von Firefox 151+ erhalten klare Hinweise zur seitenspezifischen Berechtigungs-Erweiterung und benötigen keinen Drittanbieter-Polyfill.
2026-08-15 docs: öffentliche Dokumentation zweisprachig (DE/EN)
    Englische Schwesterdateien mit knappen American-English-Texten, Sprachumschalter und Blob-Hash-Prüfung gegen veraltete Übersetzungen.
2026-08-15 docs: Sprachumschalter ganz nach oben mit einheitlichem Pfeil
    Der Umschalter steht vor der ersten Überschrift und nutzt überall denselben ↓-Präfix; Blob-Hashes wurden aktualisiert.
2026-08-15 docs: Leerzeichen vor V und % in Akku-Tabelle entfernen
    Verhindert Zeilenumbrüche in schmalen Tabellenspalten der englischen README.
2026-08-15 docs: MD013 Zeilenlängenprüfung für READMEs deaktivieren
    Tabellen, Badges und lange Linkzeilen in der Projektdoku überschreiten die 80-Zeichen-Grenze absichtlich.
2026-08-15 docs: THIRD_PARTY_NOTICES versionsneutral formulieren
    Der Einleitungssatz verweist auf die gepinnten Abhängigkeiten im aktuellen Quellbaum statt auf eine feste Release-Nummer.
2026-08-15 fix(web-flasher): Sprachlink auf index.html statt ./
    Damit funktioniert der Wechsel zur deutschen Seite auch beim lokalen Öffnen der Dateien.
2026-09-03 refactor(main): feste 200-ms-Log-Pause durch uart_wait_tx_done vor Sleep/Reboot ersetzen
    [main_idf.cpp]
2026-09-03 perf(main): 1-s-Serial-Monitor-Pause nur bei Power-On und Taster-Wake
2026-09-03 chore(build): platformio.ini Kommentare und Legacy-Block aufraeumen
2026-09-05 chore(version): PROJECT_VERSION auf 1.0.6 erhoehen
    Startpunkt fuer LP-Core- und Watchdog-Optimierung.
2026-09-05 fix(watchdog): LP-Heartbeat ueber Deep-Sleep pruefen
    Speichert den letzten LP-Core-Heartbeat im RTC-RAM und prueft ihn direkt beim Start des Watchdog-Tasks. Initialisiert beide Zaehler bei Power-On/Reboot und behaelt das 6-s-Pruefintervall fuer lange HP-Wachphasen bei.
    [hardware.h, main_idf.cpp]
2026-09-07 fix(lp-core): Impulse per Timer-Pegelabtastung statt LP_IO-Wake
    esp_deep_sleep_wakeup_io_reset() loescht die NEGEDGE-Konfiguration bei jedem HP-Wake; adaptives LP-Timer-Polling (2 s / 250 ms) und reed_level stellen die Zaehlung wieder her (v1.0.7).
    [hardware.h, main_idf.cpp, ulp_main.c, version.h]
2026-09-07 refactor(hardware): gemeinsame Pinmap in hardware_shared.h
    Pins und LP-Abtastintervalle einmal fuer HP- und LP-Core; XIAO-ESP32-C6-Kommentar und Chip-Guard; hardware.h verweist klar auf die Shared-Definitionen.
2026-09-09 fix(hardware): Chip-Guard aus hardware_shared.h entfernen
    CONFIG_IDF_TARGET_ESP32C6 ist beim fruehen HP-Compile oft noch nicht gesetzt und bricht den Build; Pinmap bleibt per Kommentar an XIAO ESP32-C6 gebunden.
    [hardware_shared.h]
2026-09-09 chore(vscode): IntelliSense auf clangd umstellen
    platformio-ide nutzt clangd; Microsoft C/C++-IntelliSense wird deaktiviert, um Konflikte zu vermeiden.
2026-10-12 docs(z2m): Screenshot und klarere Device-Icon-Anleitung
    Zeigt die Z2M-Geräteansicht mit Custom-Icon und verweist explizit auf device_icons plus meta.icon.
2026-10-12 chore(vscode): pioarduino und clangd portabel konfigurieren
    Empfiehlt pioarduino plus clangd, markiert offizielles PlatformIO und cpptools als unerwuenscht, und entfernt maschinenabhaengige Absolutpfade aus der Workspace-Datei.
2026-10-12 docs(readme): clangd/pioarduino und Version auf v1.0.7 abgleichen
    Aktualisiert die Entwicklungsumgebung in DE/EN und repariert kaputte Markdown-Links.
2026-10-12 docs(readme): markdownlint MD012/MD060 bereinigen
    Entfernt doppelte Leerzeilen und richtet Tabellen kompakt aus.
